Kamikawa-Enclosure/Kamikawa-Enclosure-Open-Models/Spec-Sheets/README.md

# Specification Sheets Library
PDF datasheets with full technical parameters of each aluminum enclosure model:
- Outer & inner dimensions
- Wall thickness
- IP65 waterproof & dustproof performance
- Material and surface treatment options
- Mounting and assembly instructions
