Kamikawa-Enclosure/Kamikawa-Enclosure-Open-Models/Product-Case-Studies-3D/README.md

# Product Case Studies 3D
## Overview
This folder collects real-world finished product 3D models of Kamikawa Precision aluminum enclosure solutions for industrial electronics. All samples are verified mass-production cases, covering extrusion aluminum profiles, IP-rated electronic shells, home energy storage pack boxes, and custom CNC precision housings.

## File Contents
- Native SolidWorks part & assembly source files
- Neutral exchange formats: STEP / STL for cross-platform CAD viewing
- Render preview images of finished aluminum enclosures
- Dimension-matched 3D models aligned with official spec sheets

## Usage Scenarios
- Mechanical engineers: Internal structural layout design, space interference check
- Procurement & sales teams: Visual 3D demo for client technical communication
- Hardware developers: Quick size reference for PCB board layout matching

## Version Control Note
All case models are sorted by application industry, updated synchronously with our latest public open mold library.
