Kamikawa-Enclosure/Kamikawa-Enclosure-Open-Models/Spec-Sheets/Aluminium Extrusion Enclosure Specifications v1.0.0.2.pdf

| | | Split-body | K268 | Split-body | K3
SC-ZT25.5x25.5 | SC-ZT32x23 | SC-ZT32x32 | SC-FT33.8X25 | | SC-FT33.8X33.8
Unibody+21:69A621:9221:85A6221:705 K365 | Unibody | K418 | Unibody | K2

# HUIZHOU KAMIKAWA PRECISION

TECHNOLOGY CO., LTD.

### Aluminium Extrusion Enclosure Available Models & Specifications VER: 1.0.0.2

Electronic enclosures are widely used across a vast range of applications—almost all electronic devices require robust, lightweight, and eco-friendly housing for effective protection.
Aluminum enclosures have gained strong popularity in the market. They are not only sturdy, lightweight, and environmentally friendly, but also offer excellent heat dissipation. In addition, aluminum enclosures provide outstanding electromagnetic interference (EMI) shielding performance (and can also be designed to be electrically conductive), ensuring safe and stable operation of your electronic equipment.
We offer over 400 different extruded aluminum enclosure profiles in various sizes and shapes (as shown in the table)—all available without any tooling/mold costs. Simply select the appropriate size based on your PCB dimensions, pair it with your choice of end caps, and you can easily create a perfect anodized aluminum electronic enclosure. You can also fully customize your enclosures: end-cap styles, mounting hole positions and shapes, surface color, logo marking, and packaging. Of course, our professional design team can also develop electronic enclosures with different ingress protection (IP) ratings to meet your specific requirements.
Custom ingress protection grades including IP65 and IP68 can be configured per equipment demands.

Cross-sectional dimensions and shape：20 & 50mm.

Split-body | K15 | Unibody | K318 | Split-body | K4 | Split-body | K5 | Unibody | K7
SC-FT34.6X25 | | SC-FT35X19 | | SC-FT35X25.8 | | SC-FT40.6X30 | | SC-ZT42X42
Split-body | SC-K269 | Split-body | SC-K6 | Unibody | SC-K324 | Unibody | SC-K9 | Unibody | SC-K266
SC-FT43.8X25 | | SC-FT43.8X43.8 | | SC-ZT43X14.1 | | SC-ZT44X23 | | SC-ZT45X18.5
Unibody | SC-K353 | Split-body | SC-K11 | Unibody | SC-K10 | Unibody | SC-K412 | Unibody | SC-K13
SC-ZT45X18.5 | | SC-FT46.2X29.6 | | SC-ZT46X18.8 | | SC-ZT48X25 | | SC-ZT50.5X21.1
Split-body | SC-K12 | Unibody | SC-K14 | Unibody | SC-K180 | Unibody | SC-K270 | Unibody | SC-K16
SC-FT50X20 | | SC-ZT50X21 | | SC-ZT50X30 | | SC-ZT50X35 | | SC-ZT50X40

# HUIZHOU KAMIKAWA PRECISION

TECHNOLOGY CO., LTD.

### Aluminium Extrusion Enclosure Available Models & Specifications VER: 1.0.0.2

Electronic enclosures are widely used across a vast range of applications—almost all electronic devices require robust, lightweight, and eco-friendly housing for effective protection.
Aluminum enclosures have gained strong popularity in the market. They are not only sturdy, lightweight, and environmentally friendly, but also offer excellent heat dissipation. In addition, aluminum enclosures provide outstanding electromagnetic interference (EMI) shielding performance (and can also be designed to be electrically conductive), ensuring safe and stable operation of your electronic equipment.
We offer over 400 different extruded aluminum enclosure profiles in various sizes and shapes (as shown in the table)—all available without any tooling/mold costs. Simply select the appropriate size based on your PCB dimensions, pair it with your choice of end caps, and you can easily create a perfect anodized aluminum electronic enclosure. You can also fully customize your enclosures: end-cap styles, mounting hole positions and shapes, surface color, logo marking, and packaging. Of course, our professional design team can also develop electronic enclosures with different ingress protection (IP) ratings to meet your specific requirements.
Custom ingress protection grades including IP65 and IP68 can be configured per equipment demands.
Unibody | SC-K359 | Unibody | SC-K341 | Unibody | SC-K18 | Split-body | SC-K272 | Split-body | SC-K20
SC-ZT52X19.6 | | SC-ZT52X26 | | SC-ZT52X52 | | SC-FT53.8X25 | | SC-FT54.2X54.2

Cross-sectional dimensions and shape：50 & 60mm.

Split-body | SC-K444 | Unibody | SC-K19 | Unibody | SC-K21 | Split-body | SC-K22 | Unibody | SC-K340
SC-FT54.5X27 | | SC-ZT54X23 | | SC-ZT55X19 | | SC-FT55X30 | | SC-ZT56X16
Unibody | SC-K24 | Unibody | SC-K327 | Unibody | SC-K342 | Unibody | SC-K26 | Unibody | SC-K448
SC-ZT56X56 | | SC-ZT57.8X34.2 | | SC-ZT57X24 | | SC-ZT57X28 | | SC-ZT58.6X20
Unibody | SC-K493 | Unibody | SC-K27 | Unibody | SC-K28 | Split-body | SC-K188 | Split-body | SC-K189
SC-ZT58.6X24.1 | | SC-ZT58X24 | | SC-ZT58.3X24.9 | | SC-FT60X25 | | SC-FT60X35
Split-body | SC-K190 | Unibody | SC-K181
SC-FT60X50 | | SC-ZT60X60

# HUIZHOU KAMIKAWA PRECISION

TECHNOLOGY CO., LTD.

### Aluminium Extrusion Enclosure Available Models & Specifications VER: 1.0.0.2

Electronic enclosures are widely used across a vast range of applications—almost all electronic devices require robust, lightweight, and eco-friendly housing for effective protection.
Aluminum enclosures have gained strong popularity in the market. They are not only sturdy, lightweight, and environmentally friendly, but also offer excellent heat dissipation. In addition, aluminum enclosures provide outstanding electromagnetic interference (EMI) shielding performance (and can also be designed to be electrically conductive), ensuring safe and stable operation of your electronic equipment.
We offer over 400 different extruded aluminum enclosure profiles in various sizes and shapes (as shown in the table)—all available without any tooling/mold costs. Simply select the appropriate size based on your PCB dimensions, pair it with your choice of end caps, and you can easily create a perfect anodized aluminum electronic enclosure. You can also fully customize your enclosures: end-cap styles, mounting hole positions and shapes, surface color, logo marking, and packaging. Of course, our professional design team can also develop electronic enclosures with different ingress protection (IP) ratings to meet your specific requirements.
Custom ingress protection grades including IP65 and IP68 can be configured per equipment demands.
Unibody with ears | SC-K157 | Unibody | SC-K36 | Split-body | SC-K155 | Unibody | SC-K259 | Unibody | SC-K256
SC-ZT66.6X29.5带耳 | | SC-ZT66X27 | | SC-FT66X30 | | SC-ZT66X32 | | SC-ZT66X43
Split-body | SC-K23 | Unibody | SC-K152 | Split-body | SC-K25 | Unibody | SC-K378 | Split-body | SC-K284
SC-FT61.6X40 | | SC-ZT61X22.4 | | SC-FT62.6X45 | | SC-FT62.9X38 | | SC-ZT63.8X30

Cross-sectional dimensions and shape：60 & 70mm.

Split-body | SC-K30 | Unibody | SC-K31 | Unibody | SC-K153 | Split-body | SC-K34 | Unibody | SC-K373
SC-FT63X25 | | SC-ZT63X37 | | SC-ZT64.2X23.5 | | SC-FT64.2X64.2 | | SC-ZT64.5X35
Split-body | SC-K33 | Unibody | SC-K154 | Split-body | SC-K41 | Split-body | SC-K35 | Unibody | SC-K156
SC-FT64X23 | | SC-ZT64X25.3 | | SC-FT65.6X35 | | SC-FT65X45 | | SC-ZT66.2X27.5
Unibody | SC-K338 | Unibody | SC-K366 | Unibody | SC-K366 | Unibody | SC-K40 | Unibody | SC-K396
SC-ZT66X55 | | SC-ZT67.1-24.9 | | SC-ZT67.1X24.9 | | SC-ZT67X53 | | SC-ZT68X42.5

# HUIZHOU KAMIKAWA PRECISION

TECHNOLOGY CO., LTD.

### Aluminium Extrusion Enclosure Available Models & Specifications VER: 1.0.0.2

Electronic enclosures are widely used across a vast range of applications—almost all electronic devices require robust, lightweight, and eco-friendly housing for effective protection.
Aluminum enclosures have gained strong popularity in the market. They are not only sturdy, lightweight, and environmentally friendly, but also offer excellent heat dissipation. In addition, aluminum enclosures provide outstanding electromagnetic interference (EMI) shielding performance (and can also be designed to be electrically conductive), ensuring safe and stable operation of your electronic equipment.
We offer over 400 different extruded aluminum enclosure profiles in various sizes and shapes (as shown in the table)—all available without any tooling/mold costs. Simply select the appropriate size based on your PCB dimensions, pair it with your choice of end caps, and you can easily create a perfect anodized aluminum electronic enclosure. You can also fully customize your enclosures: end-cap styles, mounting hole positions and shapes, surface color, logo marking, and packaging. Of course, our professional design team can also develop electronic enclosures with different ingress protection (IP) ratings to meet your specific requirements.
Custom ingress protection grades including IP65 and IP68 can be configured per equipment demands.
Unibody with ears | SC-K47 | Split-body | SC-K48 | Split-body | SC-K49 | Unibody | SC-K240 | Split-body | SC-K42
SC-ZT70.5X24.7带耳 | | SC-FT71X25 | | SC-FT71X27 | | SC-ZT73.2X65.2 | | SC-FT73.6X50
Split-body | SC-K55 | Split-body | SC-K158 | Unibody with ears | SC-K281 | Unibody | SC-K182 | Split-body | SC-K470
SC-FT75.8X46 | | SC-FT75X35 | | SC-ZT75X39.3带耳 | | SC-ZT75X40 | | SC-FT76X47.6
Unibody | SC-K257 | Split-body | SC-K43 | Unibody | SC-K310 | Split-body | SC-K44 | Split-body | SC-K45
SC-ZT69X24 | | SC-FT69X27 | | SC-ZT69X34.5 | | SC-FT69X35 | | SC-FT69X43

Cross-sectional dimensions and shape：70 & 80mm.

Unibody | SC-K331 | Split-body | SC-K286 | Split-body | SC-K363 | Split-body | SC-K368 | Split-body | SC-K369
SC-ZT73X59 | | SC-FT73.8X30 | | SC-FT74.6X25 | | SC-FT74.6X25 | | SC-FT74.6X25
Split-body | SC-K52 | Unibody | SC-K51 | Split-body | SC-K50 | Split-body | SC-K53 | Split-body | SC-K54
SC-FT74.6X74.6 | | SC-ZT74X29 | | SC-FT75.6X40 | | SC-FT75.6X45 | | SC-FT75.8X34.8

# HUIZHOU KAMIKAWA PRECISION

TECHNOLOGY CO., LTD.

### Aluminium Extrusion Enclosure Available Models & Specifications VER: 1.0.0.2

Electronic enclosures are widely used across a vast range of applications—almost all electronic devices require robust, lightweight, and eco-friendly housing for effective protection.
Aluminum enclosures have gained strong popularity in the market. They are not only sturdy, lightweight, and environmentally friendly, but also offer excellent heat dissipation. In addition, aluminum enclosures provide outstanding electromagnetic interference (EMI) shielding performance (and can also be designed to be electrically conductive), ensuring safe and stable operation of your electronic equipment.
We offer over 400 different extruded aluminum enclosure profiles in various sizes and shapes (as shown in the table)—all available without any tooling/mold costs. Simply select the appropriate size based on your PCB dimensions, pair it with your choice of end caps, and you can easily create a perfect anodized aluminum electronic enclosure. You can also fully customize your enclosures: end-cap styles, mounting hole positions and shapes, surface color, logo marking, and packaging. Of course, our professional design team can also develop electronic enclosures with different ingress protection (IP) ratings to meet your specific requirements.
Custom ingress protection grades including IP65 and IP68 can be configured per equipment demands.
Split-body | SC-K273 | Unibody with ears | SC-K57 | Split type with ears | SC-K169 | Unibody | SC-K311 | Unibody | SC-K435
SC-FT77.4X46 | | SC-ZT78X24带耳 | | SC-FT78X26带耳 | | SC-ZT79X23.5 | | SC-ZT79X30
Split-body | SC-K361 | Unibody | SC-K397 | Unibody with ears | SC-K58 | Split-body | SC-K191 | Split-body | SC-K210
SC-FT80X22.5 | | SC-ZT80X22 | | SC-ZT80X23带耳 | | SC-FT80X30 | | SC-FT80X30
Unibody with ears | SC-K297 | Split-body | SC-K59 | Unibody | SC-K463 | Split-body | SC-K60 | Split-body | SC-K300
SC-ZT80.5X25.5带耳 | | 81.6X40 | | SC-ZT82X44 | | SC-FT83.6X50 | | SC-FT83.8X30
Unibody | SC-K159 | Unibody | SC-K170 | Unibody | SC-K303 | Split-body | SC-K61 | Split-body | SC-K192
SC-ZT80X35 | | SC-ZT80X35 | | SC-ZT80X37.6 | | SC-FT80X40 | | SC-FT80X40
Split-body | SC-K211 | Unibody | SC-K63 | Split-body | SC-K193 | Split-body | SC-K212 | Unibody | SC-K183
SC-FT80X40 | | SC-ZT80X45 | | SC-FT80X55 | | SC-FT80X55 | | SC-ZT80X80

Cross-sectional dimensions and shape：80 & 90mm.

# HUIZHOU KAMIKAWA PRECISION

TECHNOLOGY CO., LTD.

### Aluminium Extrusion Enclosure Available Models & Specifications VER: 1.0.0.2

Electronic enclosures are widely used across a vast range of applications—almost all electronic devices require robust, lightweight, and eco-friendly housing for effective protection.
Aluminum enclosures have gained strong popularity in the market. They are not only sturdy, lightweight, and environmentally friendly, but also offer excellent heat dissipation. In addition, aluminum enclosures provide outstanding electromagnetic interference (EMI) shielding performance (and can also be designed to be electrically conductive), ensuring safe and stable operation of your electronic equipment.
We offer over 400 different extruded aluminum enclosure profiles in various sizes and shapes (as shown in the table)—all available without any tooling/mold costs. Simply select the appropriate size based on your PCB dimensions, pair it with your choice of end caps, and you can easily create a perfect anodized aluminum electronic enclosure. You can also fully customize your enclosures: end-cap styles, mounting hole positions and shapes, surface color, logo marking, and packaging. Of course, our professional design team can also develop electronic enclosures with different ingress protection (IP) ratings to meet your specific requirements.
Custom ingress protection grades including IP65 and IP68 can be configured per equipment demands.
Split-body | SC-K68 | Unibody | SC-K67 | Unibody | SC-K504 | Unibody with ears | SC-K426 | Unibody | SC-K385
SC-FT84.6X84.6 | | SC-ZT84X28 | | SC-ZT84X28 | | SC-ZT85.8X26.5带耳 | | SC-ZT85X46
Split-body | SC-K279 | Split-body | SC-K69 | Unibody | SC-K172 | Split-body | SC-K70 | Unibody with ears | SC-K281
SC-FT86X46 | | SC-FT88X30 | | SC-ZT88X38.9 | | SC-FT88X38 | | SC-ZT88X39.6带耳
Unibody | SC-K420 | Split-body | SC-K301 | Split type with ears | SC-K71 | Unibody | SC-K160 | Split-body | SC-K73
SC-ZT88X43 | | SC-FT89.6X35 | | SC-FT89X27带耳 | | SC-ZT90X34.9 | | SC-FT90X35
Split-body | SC-K74 | Unibody with ears | SC-K75 | Split-body | SC-K77 | Split-body | SC-K78 | Split-body | SC-K79
SC-FT90X36 | | SC-ZT90X40带耳 | | SC-FT90X59 | | SC-FT90X74.5 | | SC-FT90X90
Split-body | SC-K308 | Unibody | SC-K65 | Split-body | SC-K371 | Split-body | SC-K375 | Split-body | SC-K377
SC-FT83.9X55 | | SC-ZT83X29 | | SC-FT84.6X30 | | SC-FT84.6X30 | | SC-FT84.6X30

# HUIZHOU KAMIKAWA PRECISION

TECHNOLOGY CO., LTD.

### Aluminium Extrusion Enclosure Available Models & Specifications VER: 1.0.0.2

Electronic enclosures are widely used across a vast range of applications—almost all electronic devices require robust, lightweight, and eco-friendly housing for effective protection.
Aluminum enclosures have gained strong popularity in the market. They are not only sturdy, lightweight, and environmentally friendly, but also offer excellent heat dissipation. In addition, aluminum enclosures provide outstanding electromagnetic interference (EMI) shielding performance (and can also be designed to be electrically conductive), ensuring safe and stable operation of your electronic equipment.
We offer over 400 different extruded aluminum enclosure profiles in various sizes and shapes (as shown in the table)—all available without any tooling/mold costs. Simply select the appropriate size based on your PCB dimensions, pair it with your choice of end caps, and you can easily create a perfect anodized aluminum electronic enclosure. You can also fully customize your enclosures: end-cap styles, mounting hole positions and shapes, surface color, logo marking, and packaging. Of course, our professional design team can also develop electronic enclosures with different ingress protection (IP) ratings to meet your specific requirements.
Custom ingress protection grades including IP65 and IP68 can be configured per equipment demands.
Unibody | SC-K374 | Split type with ears | SC-K80 | Split type with ears | SC-K81 | Unibody | SC-K499 | Split-body | SC-K82
SC-ZT92X30 | | SC-FT92X35带耳 | | SC-FT92X46带耳 | | SC-ZT92X46 | | SC-FT92X73
Split-body | SC-K133 | Split-body | SC-K90 | Split-body | SC-K86 | Unibody with ears | SC-K161 | Split-body | SC-K87
SC-FT97.6X39 | | SC-FT97.8X48.4 | | SC-FT97X39.8 | | SC-ZT97X40.6带耳 | | SC-FT97X50
Split-body | SC-K64 | Split-body | SC-K468 | Unibody | SC-K477 | Split-body | SC-K76 | Unibody | SC-K124
SC-FT91.6X50 | | SC-FT91X57.6 | | SC-ZT91X91 | | SC-FT92.6X30 | | SC-ZT92.6X31

Cross-sectional dimensions and shape：90 & 100mm.

Split-body | SC-K379 | Split-body | SC-K381 | Split-body | SC-K382 | Split-body | SC-K315 | Unibody | SC-K83
SC-FT94.6X30 | | SC-FT94.6X30 | | SC-FT94.6X30 | | SC-FT94.6X35 | | SC-ZT95.4X45.2
Unibody | SC-K399 | Split-body | SC-K84 | Split-body | SC-K498 | Split-body | SC-K85 | Split-body | SC-K66
SC-ZT95X30 | | SC-FT95X54.3 | | SC-FT96.6X36.5 | | SC-FT96X45.5 | | SC-FT97.6X30

# HUIZHOU KAMIKAWA PRECISION

TECHNOLOGY CO., LTD.

### Aluminium Extrusion Enclosure Available Models & Specifications VER: 1.0.0.2

Electronic enclosures are widely used across a vast range of applications—almost all electronic devices require robust, lightweight, and eco-friendly housing for effective protection.
Aluminum enclosures have gained strong popularity in the market. They are not only sturdy, lightweight, and environmentally friendly, but also offer excellent heat dissipation. In addition, aluminum enclosures provide outstanding electromagnetic interference (EMI) shielding performance (and can also be designed to be electrically conductive), ensuring safe and stable operation of your electronic equipment.
We offer over 400 different extruded aluminum enclosure profiles in various sizes and shapes (as shown in the table)—all available without any tooling/mold costs. Simply select the appropriate size based on your PCB dimensions, pair it with your choice of end caps, and you can easily create a perfect anodized aluminum electronic enclosure. You can also fully customize your enclosures: end-cap styles, mounting hole positions and shapes, surface color, logo marking, and packaging. Of course, our professional design team can also develop electronic enclosures with different ingress protection (IP) ratings to meet your specific requirements.
Custom ingress protection grades including IP65 and IP68 can be configured per equipment demands.
Unibody | SC-K329 | Split-body | SC-K436 | Unibody with ears | SC-K92 | Split-body | SC-K319 | Split-body | SC-K93
SC-ZT101.2X23.5 | | SC-FT101.5X24 | | SC-ZT104.4X28.3带耳 | | SC-FT104.6X35 | | SC-FT104X35.6
Split-body | SC-K88 | Unibody | SC-K89 | Split-body | SC-K276 | Split-body | SC-K317 | Split-body | SC-K320
SC-FT97X60 | | SC-ZT97X84 | | SC-FT98X25 | | SC-FT99.6X35 | | SC-FT99.6X43.8
Split-body | SC-K387 | Split-body | SC-K393 | Split-body | SC-K398 | Split-body | SC-K91 | Unibody | SC-K424
SC-FT99.6X35 | | SC-FT99.6X35 | | SC-FT99.6X35 | | SC-FT100X25.5 | | SC-ZT100X27
Unibody | SC-K184 | Unibody | SC-K323
SC-ZT100X50 | | SC-ZT100X54.5

Cross-sectional dimensions and shape：100 & 110mm.

Split-body | SC-K94 | Split-body | SC-K328 | Split-body | SC-K95 | Split-body | SC-K96 | Split-body | SC-K336
SC-FT104X45.6 | | SC-FT104X46.9 | | SC-FT104X55.6 | | SC-FT104X63 | | SC-FT104X63

# HUIZHOU KAMIKAWA PRECISION

TECHNOLOGY CO., LTD.

### Aluminium Extrusion Enclosure Available Models & Specifications VER: 1.0.0.2

Electronic enclosures are widely used across a vast range of applications—almost all electronic devices require robust, lightweight, and eco-friendly housing for effective protection.
Aluminum enclosures have gained strong popularity in the market. They are not only sturdy, lightweight, and environmentally friendly, but also offer excellent heat dissipation. In addition, aluminum enclosures provide outstanding electromagnetic interference (EMI) shielding performance (and can also be designed to be electrically conductive), ensuring safe and stable operation of your electronic equipment.
We offer over 400 different extruded aluminum enclosure profiles in various sizes and shapes (as shown in the table)—all available without any tooling/mold costs. Simply select the appropriate size based on your PCB dimensions, pair it with your choice of end caps, and you can easily create a perfect anodized aluminum electronic enclosure. You can also fully customize your enclosures: end-cap styles, mounting hole positions and shapes, surface color, logo marking, and packaging. Of course, our professional design team can also develop electronic enclosures with different ingress protection (IP) ratings to meet your specific requirements.
Custom ingress protection grades including IP65 and IP68 can be configured per equipment demands.
Split-body | SC-K97 | Split-body | SC-K337 | Split-body | SC-K98 | Split-body | SC-K335 | Unibody | SC-K367
SC-FT104X73 | | SC-FT104X76.95 | | SC-FT104X89.6 | | SC-FT104X107 | | SC-ZT105.5X52.9
Unibody | SC-K99 | Split-body | SC-K194 | Split-body | SC-K213 | Split-body | SC-K162 | Split-body | SC-K195
SC-ZT105X22 | | SC-FT105X30 | | SC-FT105X30 | | SC-FT105X45 | | SC-FT105X45
Split-body | SC-K196 | Unibody | SC-K434 | Split-body | SC-K100 | Split-body | SC-K101 | Split-body | SC-K102
SC-FT105X60 | | SC-ZT106X36.3 | | SC-FT106X40 | | SC-FT106X54 | | SC-FT106X55
Split-body | SC-K263 | Split-body | SC-K148 | Unibody | SC-K395 | Unibody | SC-K296 | Split-body | SC-K103
SC-FT106X55 | | SC-FT107.6X55 | | SC-ZT107X27 | | SC-ZT107X36.6 | | SC-FT107X47
Unibody | SC-K171 | Split-body | SC-K321 | Split-body | SC-K402 | Split-body | SC-K404 | Split-body | SC-K406
SC-ZT108X108 | | SC-FT109.6X35 | | SC-FT109.6X35 | | SC-FT109.6X35 | | SC-FT109.6X35

# HUIZHOU KAMIKAWA PRECISION

TECHNOLOGY CO., LTD.

### Aluminium Extrusion Enclosure Available Models & Specifications VER: 1.0.0.2

Electronic enclosures are widely used across a vast range of applications—almost all electronic devices require robust, lightweight, and eco-friendly housing for effective protection.
Aluminum enclosures have gained strong popularity in the market. They are not only sturdy, lightweight, and environmentally friendly, but also offer excellent heat dissipation. In addition, aluminum enclosures provide outstanding electromagnetic interference (EMI) shielding performance (and can also be designed to be electrically conductive), ensuring safe and stable operation of your electronic equipment.
We offer over 400 different extruded aluminum enclosure profiles in various sizes and shapes (as shown in the table)—all available without any tooling/mold costs. Simply select the appropriate size based on your PCB dimensions, pair it with your choice of end caps, and you can easily create a perfect anodized aluminum electronic enclosure. You can also fully customize your enclosures: end-cap styles, mounting hole positions and shapes, surface color, logo marking, and packaging. Of course, our professional design team can also develop electronic enclosures with different ingress protection (IP) ratings to meet your specific requirements.
Custom ingress protection grades including IP65 and IP68 can be configured per equipment demands.
Unibody | SC-K425 | Unibody with ears | SC-K427 | Split-body | SC-K492 | Split-body | SC-K106 | Unibody | SC-K175
SC-ZT110X24 | | SC-ZT110X26.1带耳 | | SC-FT110X46.9 | | SC-FT110X50 | | SC-ZT110X58
Unibody with ears | SC-K285

SC-ZT129.6X31.5带耳

Split-body | SC-K234 | Unibody | SC-K423 | Split type with ears | SC-K108 | Split type with ears | SC-K109 | Split-body | SC-K110
SC-FT111.2X88 | | SC-ZT112X25 | | SC-FT113X40带耳 | | SC-FT113X49.8带耳 | | SC-FT114X33
Split-body | SC-K409 | Split-body | SC-K414 | Split-body | SC-K422 | Unibody | SC-K185 | Unibody with ears | SC-K112
SC-FT114.6X38 | | SC-FT114.6X38 | | SC-FT114.6X38 | | SC-ZT114X65 | | SC-ZT116X53带耳
Split-body | SC-K229 | Split-body | SC-K230 | Split-body | SC-K231 | Split-body | SC-K232 | Split-body | SC-K233
SC-FT111.2X21.4 | | SC-FT111.2X32.5 | | SC-FT111.2X43.6 | | SC-FT111.2X54.7 | | SC-FT111.2X65.8

Cross-sectional dimensions and shape：110 & 120mm.

# HUIZHOU KAMIKAWA PRECISION

TECHNOLOGY CO., LTD.

### Aluminium Extrusion Enclosure Available Models & Specifications VER: 1.0.0.2

Electronic enclosures are widely used across a vast range of applications—almost all electronic devices require robust, lightweight, and eco-friendly housing for effective protection.
Aluminum enclosures have gained strong popularity in the market. They are not only sturdy, lightweight, and environmentally friendly, but also offer excellent heat dissipation. In addition, aluminum enclosures provide outstanding electromagnetic interference (EMI) shielding performance (and can also be designed to be electrically conductive), ensuring safe and stable operation of your electronic equipment.
We offer over 400 different extruded aluminum enclosure profiles in various sizes and shapes (as shown in the table)—all available without any tooling/mold costs. Simply select the appropriate size based on your PCB dimensions, pair it with your choice of end caps, and you can easily create a perfect anodized aluminum electronic enclosure. You can also fully customize your enclosures: end-cap styles, mounting hole positions and shapes, surface color, logo marking, and packaging. Of course, our professional design team can also develop electronic enclosures with different ingress protection (IP) ratings to meet your specific requirements.
Custom ingress protection grades including IP65 and IP68 can be configured per equipment demands.
Split type with ears | SC-K115 | Split-body | SC-K114 | Split-body | SC-K116 | Unibody | SC-K350 | Split-body | SC-K117
SC-FT119.6X34.2带耳 | | SC-FT120X35 | | SC-FT120X40 | | SC-ZT120X45 | | SC-FT120X49
Split type with ears | SC-K118 | Split-body | SC-K119 | Split type with ears | SC-K120 | Split-body | SC-K121 | Split-body | SC-K122
SC-FT120X50.1带耳 | | SC-FT120X63 | | SC-FT120X64.9带耳 | | SC-FT120X69 | | SC-FT120X83
Split-body | SC-K113 | Unibody with ears | SC-K287
SC-FT120X103 | | SC-ZT149X38带耳
Split-body | SC-K267 | Unibody | SC-K123 | Split-body | SC-K235 | Unibody | SC-K278 | Unibody | SC-K275
SC-FT122.4X28 | | SC-ZT122X28 | | SC-FT122X44.8 | | SC-ZT122X87 | | SC-ZT123X40

Cross-sectional dimensions and shape：120 & 140mm.

Split-body | SC-K343 | Split-body | SC-K428 | Split-body | SC-K430 | Split-body | SC-K437 | Split-body | SC-K125
SC-FT124.6X35 | | SC-FT124.6X45 | | SC-FT124.6X45 | | SC-FT124.6X45 | | SC-FT125X51

# HUIZHOU KAMIKAWA PRECISION

TECHNOLOGY CO., LTD.

### Aluminium Extrusion Enclosure Available Models & Specifications VER: 1.0.0.2

Electronic enclosures are widely used across a vast range of applications—almost all electronic devices require robust, lightweight, and eco-friendly housing for effective protection.
Aluminum enclosures have gained strong popularity in the market. They are not only sturdy, lightweight, and environmentally friendly, but also offer excellent heat dissipation. In addition, aluminum enclosures provide outstanding electromagnetic interference (EMI) shielding performance (and can also be designed to be electrically conductive), ensuring safe and stable operation of your electronic equipment.
We offer over 400 different extruded aluminum enclosure profiles in various sizes and shapes (as shown in the table)—all available without any tooling/mold costs. Simply select the appropriate size based on your PCB dimensions, pair it with your choice of end caps, and you can easily create a perfect anodized aluminum electronic enclosure. You can also fully customize your enclosures: end-cap styles, mounting hole positions and shapes, surface color, logo marking, and packaging. Of course, our professional design team can also develop electronic enclosures with different ingress protection (IP) ratings to meet your specific requirements.
Custom ingress protection grades including IP65 and IP68 can be configured per equipment demands.
Split-body | SC-K126 | Unibody | SC-K429 | Unibody with ears | SC-K127 | Unibody with ears | SC-K165 | Split-body | SC-K128
SC-FT127X75 | | SC-ZT128.5X41 | | SC-ZT129.7X31带耳 | | SC-ZT130X31.7带耳 | | SC-FT130X55
Split-body | SC-K451 | Split-body | SC-K443 | Split-body | SC-K452 | Unibody with ears | SC-K438 | Unibody | SC-K462
SC-FT130X55 | | SC-FT130X55 | | SC-FT130X55 | | SC-ZT131X27.5带耳 | | SC-ZT133.6X97.5
Unibody with ears | SC-K288 | Split-body | SC-K439 | Split-body | SC-K440 | Split-body | SC-K441 | Split type with ears | SC-K129
SC-ZT133X46.8带耳 | | SC-FT134.6X45 | | SC-FT134.6X45 | | SC-FT134.6X45 | | SC-FT134X35.6带耳
Split type with ears | SC-K130 | Split type with ears | SC-K131 | Split-body | SC-K304 | Unibody | SC-K132 | Unibody with ears | SC-K417
SC-FT134X45.6带耳 | | SC-FT134X62.6带耳 | | SC-FT136X64 | | SC-ZT136X136 | | SC-ZT137.5X50带耳
Unibody | SC-K494 | Unibody | SC-K309 | Split-body | SC-K197 | Split-body | SC-K216 | Split-body | SC-K163
SC-ZT137.8X34.1 | | SC-ZT137X72 | | SC-FT140X35 | | SC-FT140X35 | | SC-FT140X50

# HUIZHOU KAMIKAWA PRECISION

TECHNOLOGY CO., LTD.

### Aluminium Extrusion Enclosure Available Models & Specifications VER: 1.0.0.2

Electronic enclosures are widely used across a vast range of applications—almost all electronic devices require robust, lightweight, and eco-friendly housing for effective protection.
Aluminum enclosures have gained strong popularity in the market. They are not only sturdy, lightweight, and environmentally friendly, but also offer excellent heat dissipation. In addition, aluminum enclosures provide outstanding electromagnetic interference (EMI) shielding performance (and can also be designed to be electrically conductive), ensuring safe and stable operation of your electronic equipment.
We offer over 400 different extruded aluminum enclosure profiles in various sizes and shapes (as shown in the table)—all available without any tooling/mold costs. Simply select the appropriate size based on your PCB dimensions, pair it with your choice of end caps, and you can easily create a perfect anodized aluminum electronic enclosure. You can also fully customize your enclosures: end-cap styles, mounting hole positions and shapes, surface color, logo marking, and packaging. Of course, our professional design team can also develop electronic enclosures with different ingress protection (IP) ratings to meet your specific requirements.
Custom ingress protection grades including IP65 and IP68 can be configured per equipment demands.
Unibody with ears | SC-K294 | Split-body | SC-K236 | Split-body | SC-K458 | Split-body | SC-K455 | Split-body | SC-K459
SC-ZT142.8X31带耳 | | SC-FT142x53.4 | | SC-FT145.6X65 | | SC-FT145.6X65 | | SC-FT145.6X65
Split-body | SC-K357 | Split-body | SC-K134 | Split-body | SC-K135 | Split-body | SC-K136 | Split type with ears | SC-K283
SC-FT145.6X40 | | SC-FT145X54 | | SC-FT145X68 | | SC-FT145X82 | | SC-FT147X35.7带耳
Split type with ears | SC-K137 | Split type with ears | SC-K138 | Split type with ears | SC-K139 | Split type with ears | SC-K265 | Unibody | SC-K302
SC-FT147X41带耳 | | SC-FT147X55带耳 | | SC-FT147X61带耳 | | SC-FT149X50.5带耳 | | SC-ZT149X106.2
Split-body | SC-K496 | Unibody with ears | SC-K445 | Split type with ears | SC-K140 | Split-body | SC-K164 | Split type with ears | SC-K142
SC-FT150.6X151 | | SC-ZT150X37.9带耳 | | SC-FT150X39带耳 | | SC-FT150X55 | | SC-FT150X72带耳

Cross-sectional dimensions and shape：140 & 160mm.

Split-body | SC-K198 | Split-body | SC-K199 | Split-body | SC-K200
SC-FT140X50 | | SC-FT140X70 | | SC-FT140X90

# HUIZHOU KAMIKAWA PRECISION

TECHNOLOGY CO., LTD.

### Aluminium Extrusion Enclosure Available Models & Specifications VER: 1.0.0.2

Electronic enclosures are widely used across a vast range of applications—almost all electronic devices require robust, lightweight, and eco-friendly housing for effective protection.
Aluminum enclosures have gained strong popularity in the market. They are not only sturdy, lightweight, and environmentally friendly, but also offer excellent heat dissipation. In addition, aluminum enclosures provide outstanding electromagnetic interference (EMI) shielding performance (and can also be designed to be electrically conductive), ensuring safe and stable operation of your electronic equipment.
We offer over 400 different extruded aluminum enclosure profiles in various sizes and shapes (as shown in the table)—all available without any tooling/mold costs. Simply select the appropriate size based on your PCB dimensions, pair it with your choice of end caps, and you can easily create a perfect anodized aluminum electronic enclosure. You can also fully customize your enclosures: end-cap styles, mounting hole positions and shapes, surface color, logo marking, and packaging. Of course, our professional design team can also develop electronic enclosures with different ingress protection (IP) ratings to meet your specific requirements.
Custom ingress protection grades including IP65 and IP68 can be configured per equipment demands.
Unibody | SC-K186 | Split-body | SC-K173 | Split-body | SC-K487 | Split-body | SC-K143 | Split type with ears | SC-K380
SC-ZT150X75 | | SC-FT150X90 | | SC-FT152X30 | | SC-FT152X44 | | SC-FT153.4X42带耳
Split-body | SC-K358 | Split-body | SC-K460 | Split-body | SC-K461 | Split-body | SC-K465 | Unibody with ears | SC-K144
SC-FT155.6X50 | | SC-FT155.6X90 | | SC-FT155.6X90 | | SC-FT155.6X90 | | SC-ZT155X32带耳
Unibody with ears | SC-K306 | Unibody with ears | SC-K292 | Split-body | SC-K364 | Split-body | SC-K166 | Unibody | SC-K476
SC-ZT158X35带耳 | | SC-ZT158X39带耳 | | SC-FT159X40 | | SC-FT160X55 | | SC-ZT160X68.1
Split-body | SC-K475 | Split-body | SC-K483 | Split-body | SC-K484 | Split-body | SC-K258 | Split type with ears | SC-K389
SC-FT165.6X90 | | SC-FT165.6X90 | | SC-FT165.6X90 | | SC-FT167.6X47 | | SC-FT168X40.6带耳
Split-body | SC-K146

SC-FT160X80

Cross-sectional dimensions and shape：160 & 200mm.

# HUIZHOU KAMIKAWA PRECISION

TECHNOLOGY CO., LTD.

### Aluminium Extrusion Enclosure Available Models & Specifications VER: 1.0.0.2

Electronic enclosures are widely used across a vast range of applications—almost all electronic devices require robust, lightweight, and eco-friendly housing for effective protection.
Aluminum enclosures have gained strong popularity in the market. They are not only sturdy, lightweight, and environmentally friendly, but also offer excellent heat dissipation. In addition, aluminum enclosures provide outstanding electromagnetic interference (EMI) shielding performance (and can also be designed to be electrically conductive), ensuring safe and stable operation of your electronic equipment.
We offer over 400 different extruded aluminum enclosure profiles in various sizes and shapes (as shown in the table)—all available without any tooling/mold costs. Simply select the appropriate size based on your PCB dimensions, pair it with your choice of end caps, and you can easily create a perfect anodized aluminum electronic enclosure. You can also fully customize your enclosures: end-cap styles, mounting hole positions and shapes, surface color, logo marking, and packaging. Of course, our professional design team can also develop electronic enclosures with different ingress protection (IP) ratings to meet your specific requirements.
Custom ingress protection grades including IP65 and IP68 can be configured per equipment demands.
Split type with ears | SC-K386 | Split-body | SC-K277 | Split-body | SC-K147 | Split-body | SC-K486 | Split-body | SC-K497
SC-FT168X40带耳 | | SC-FT168X45 | | SC-FT168X54 | | SC-FT175.6X65 | | SC-FT175.6X65
Split-body | SC-K204 | Split type with ears | SC-K352 | Split type with ears | SC-K149 | Unibody with ears | SC-K450 | Split-body | SC-K495
SC-FT185X105 | | SC-FT190X45.9带耳 | | SC-FT190X71.6带耳 | | SC-ZT194X23.5带耳 | | SC-FT197.6X197.6
Unibody | SC-K500 | Split-body | SC-K261 | Split-body | SC-K392 | Split-body | SC-K167 | Split-body | SC-K201
SC-ZT175.6X65 | | SC-FT177.6X39 | | SC-FT179.8X50 | | SC-FT180X45 | | SC-FT185X42
Split-body | SC-K479 | Split-body | SC-K480 | Split-body | SC-K481 | Split-body | SC-K202 | Split-body | SC-K203
SC-FT185.6X65 | | SC-FT185.6X65 | | SC-FT185.6X65 | | SC-FT185X60 | | SC-FT185X80
Split-body | SC-K168 | Unibody | SC-K187
SC-FT200X55 | | SC-ZT200X75

# HUIZHOU KAMIKAWA PRECISION

TECHNOLOGY CO., LTD.

### Aluminium Extrusion Enclosure Available Models & Specifications VER: 1.0.0.2

Electronic enclosures are widely used across a vast range of applications—almost all electronic devices require robust, lightweight, and eco-friendly housing for effective protection.
Aluminum enclosures have gained strong popularity in the market. They are not only sturdy, lightweight, and environmentally friendly, but also offer excellent heat dissipation. In addition, aluminum enclosures provide outstanding electromagnetic interference (EMI) shielding performance (and can also be designed to be electrically conductive), ensuring safe and stable operation of your electronic equipment.
We offer over 400 different extruded aluminum enclosure profiles in various sizes and shapes (as shown in the table)—all available without any tooling/mold costs. Simply select the appropriate size based on your PCB dimensions, pair it with your choice of end caps, and you can easily create a perfect anodized aluminum electronic enclosure. You can also fully customize your enclosures: end-cap styles, mounting hole positions and shapes, surface color, logo marking, and packaging. Of course, our professional design team can also develop electronic enclosures with different ingress protection (IP) ratings to meet your specific requirements.
Custom ingress protection grades including IP65 and IP68 can be configured per equipment demands.
Split-body | SC-K384 | Split-body | SC-K237 | Split type with ears | SC-K150 | Split-body | SC-K488 | Split-body | SC-K489
SC-FT202X32 | | SC-FT202X52 | | SC-FT204X48带耳 | | SC-FT205.6X65 | | SC-FT205.6X65

Cross-sectional dimensions and shape：200 & 300mm.

Split-body | SC-K490 | Split-body | SC-K503 | Unibody | SC-K298 | Split-body | SC-K205 | Split-body | SC-K206
SC-FT205.6X65 | | SC-FT210X54 | | SC-ZT220X48.4 | | SC-FT230X50 | | SC-FT230X75
Split-body | SC-K207 | Split-body | SC-K501 | Split-body | SC-K502 | Split-body | SC-K208 | Split-body | SC-K209
SC-FT230X100 | | SC-FT240X85 | | SC-FT250X54 | | SC-FT285X75 | | SC-FT285X125
Split-body | SC-K242 | Split-body | SC-K243 | Unibody | SC-K29 | Unibody | SC-K407 | Split-body | SC-K252
SC-FT40.6X14.6 | | SC-FT56.5X17.5 | | SC-ZT60X21 | | SC-ZT67.5X24 | | SC-FT69.1X35

The following is the special-shaped aluminum shell.

Split-body | SC-K244 | Split-body | SC-K248 | Unibody | SC-K46 | Split-body | SC-K307 | Split-body | SC-K245
SC-FT69.5X19.5 | | SC-FT69.5X34.5 | | SC-ZT70X24 | | SC-FT79X26 | | SC-FT81.5X23.5

# HUIZHOU KAMIKAWA PRECISION

TECHNOLOGY CO., LTD.

### Aluminium Extrusion Enclosure Available Models & Specifications VER: 1.0.0.2

Electronic enclosures are widely used across a vast range of applications—almost all electronic devices require robust, lightweight, and eco-friendly housing for effective protection.
Aluminum enclosures have gained strong popularity in the market. They are not only sturdy, lightweight, and environmentally friendly, but also offer excellent heat dissipation. In addition, aluminum enclosures provide outstanding electromagnetic interference (EMI) shielding performance (and can also be designed to be electrically conductive), ensuring safe and stable operation of your electronic equipment.
We offer over 400 different extruded aluminum enclosure profiles in various sizes and shapes (as shown in the table)—all available without any tooling/mold costs. Simply select the appropriate size based on your PCB dimensions, pair it with your choice of end caps, and you can easily create a perfect anodized aluminum electronic enclosure. You can also fully customize your enclosures: end-cap styles, mounting hole positions and shapes, surface color, logo marking, and packaging. Of course, our professional design team can also develop electronic enclosures with different ingress protection (IP) ratings to meet your specific requirements.
Custom ingress protection grades including IP65 and IP68 can be configured per equipment demands.
Unibody | SC-K241 | Unibody | SC-K348 | Split-body | SC-K249 | Split-body | SC-K253 | Split-body | SC-K246
SC-ZT84X17.5 | | SC-ZT84X17.5 | | SC-FT94.5X39.5 | | SC-FT99.4X25.8 | | SC-FT99.6X15.6
Split-body | SC-K254 | Unibody | SC-K104 | Split-body | SC-K247 | Unibody | SC-K105 | Unibody | SC-K111
SC-FT108.2X29.5 | | SC-ZT108X26 | | SC-FT109.5X29.5 | | SC-ZT110X28 | | SC-ZT115X24
Unibody | SC-K401 | Split-body | SC-K250 | Unibody | SC-K305 | SC-FTxx X xx
SC-ZT128.4X34.3 | | SC-FT129.5X34.5 | | SC-ZT165X40 | | Any length, width, height dimensions
