Kamikawa-Enclosure/Kamikawa-Enclosure-Open-Models/3D-Models/SCZT245x180-SC.STEP

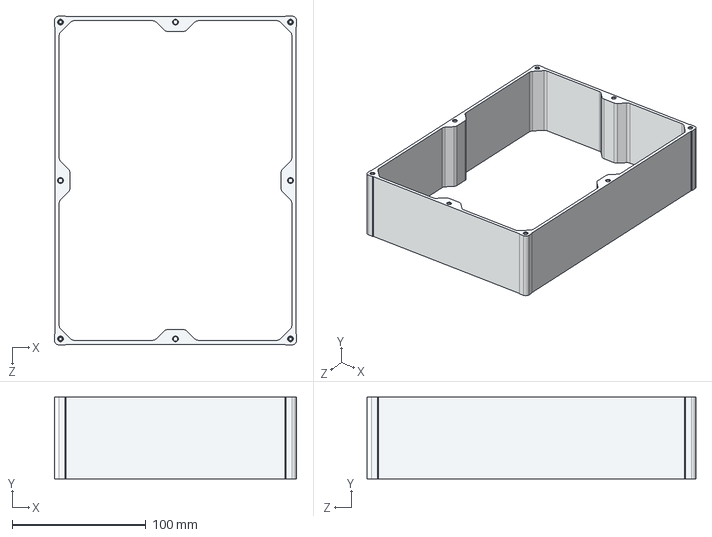
[picture p1: CAD file, 2026-11-07]
3D-Models/SCZT245x180-SC.STEP
181.0 x 61.0 x 246.0 mm
