Kamikawa-Enclosure/Kamikawa-Enclosure-Open-Models/CAD-Drawings/SCZT245x180-SC.DXF

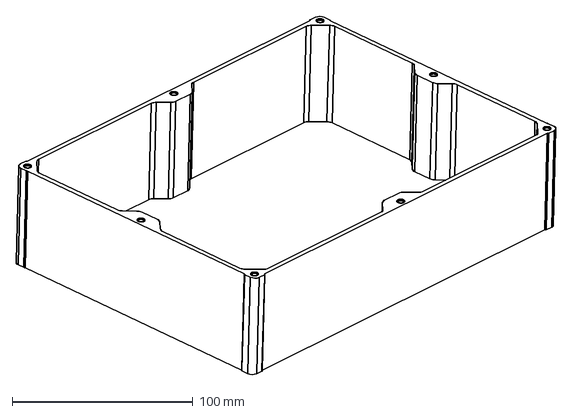
[picture p2: CAD file, 2026-11-07]
CAD-Drawings/SCZT245x180-SC.DXF
298.7 x 198.6 mm
