Kamikawa-Enclosure/Kamikawa-Enclosure-Open-Models/Product-Case-Studies-3D/SC-FT-K61-K73-K116-K158-22.STEP

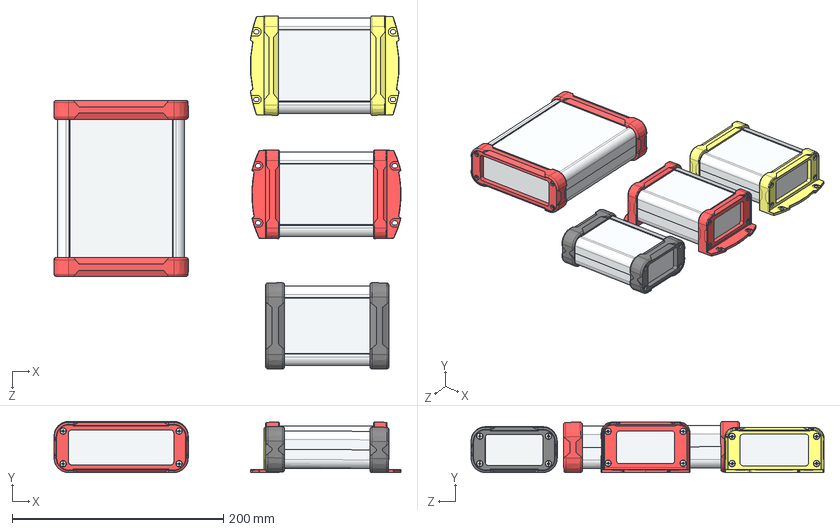
[picture p3: CAD file, 2026-10-18]
Product-Case-Studies-3D/SC-FT-K61-K73-K116-K158-22.STEP
328.1 x 48.4 x 333.9 mm
SC-FT80x40-10_A
SC-FT80x40-10_B
SC-FT80x40-20_A
SC-FT80x40-20_B
cross recessed pan head screws gb_GB M3X8-8 x 32
SC-FT80x40-30_深蓝色 x 2
SC-FT90x35-10_A
SC-FT90x35-10_B
SC-FT90x35-20_A
SC-FT90x35-20_B
SC-FT90x35-30_深蓝色 x 2
SC-FT120x40-10_A
SC-FT120x40-10_B
SC-FT120x40-20_A
SC-FT120x40-20_B
SC-FT120x40-30_黑色 x 2
SC-FT75x35-10_A
SC-FT75x35-10_B
SC-FT75x35-20_A
SC-FT75x35-20_B
SC-FT75x35-30_黑色 x 2
