Kamikawa-Enclosure/Kamikawa-Enclosure-Open-Models/3D-Models/SC-ZT150x120-SC.STEP

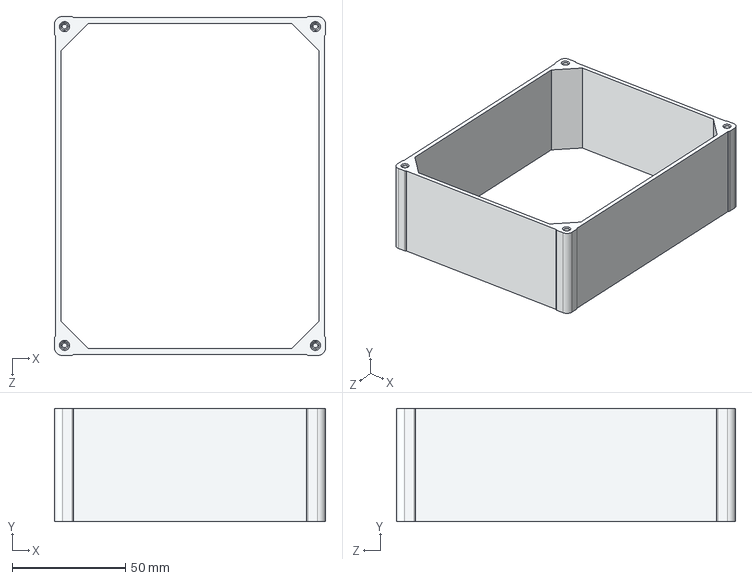
[picture p4: CAD file, 2026-11-07]
3D-Models/SC-ZT150x120-SC.STEP
120.0 x 50.0 x 150.0 mm
