Kamikawa-Enclosure/Kamikawa-Enclosure-Open-Models/CAD-Drawings/SC-ZT190x120-SC.DXF

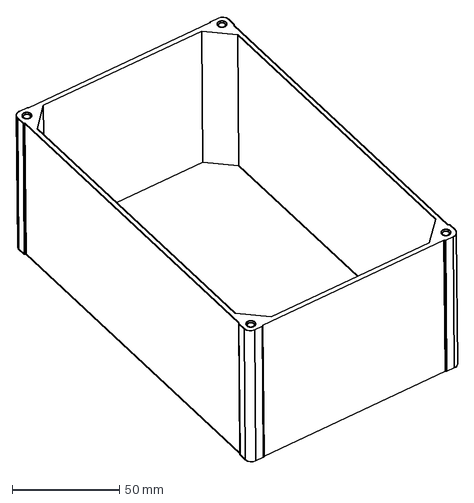
[picture p5: CAD file, 2026-11-07]
CAD-Drawings/SC-ZT190x120-SC.DXF
205.3 x 207.5 mm
