Kamikawa-Enclosure/Kamikawa-Enclosure-Open-Models/Product-Case-Studies-3D/SC-FT80x40-00.STEP

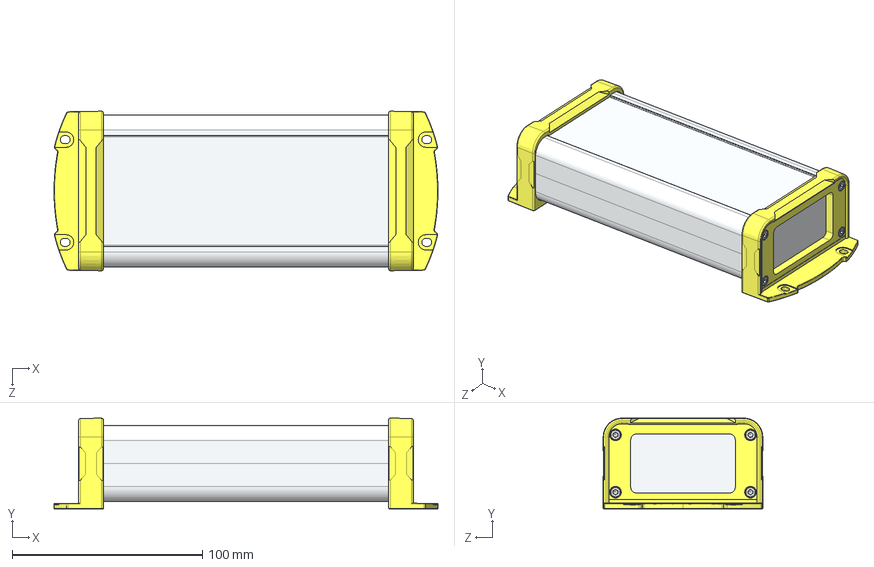
[picture p6: CAD file, 2026-10-11]
Product-Case-Studies-3D/SC-FT80x40-00.STEP
202.0 x 47.8 x 84.0 mm
SC-FT80x40-1.1-K61 x 2
SC-FT80x40-2.1-K61
SC-FT80x40-2.3-K61_黄色 x 2
SC-FT80x40-3.1-K61
hexagon socket head cap screws gb_GB_FASTENER_SCREWS_HSHCS M3X12-N x 8
