Kamikawa-Enclosure/Kamikawa-Enclosure-Open-Models/3D-Models/SC-ZT190x120-SC.STEP

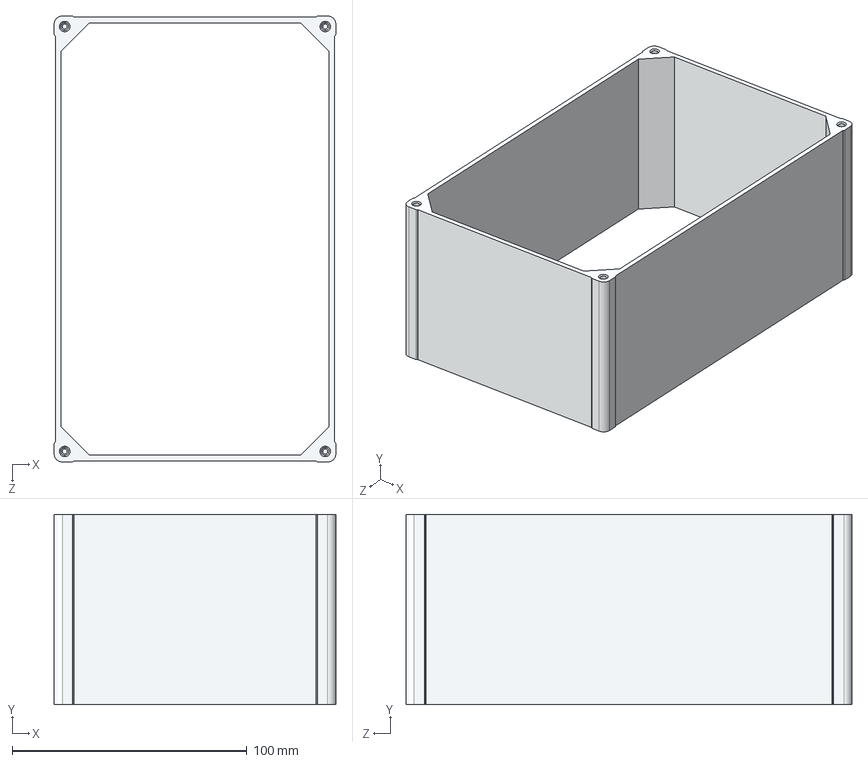
[picture p7: CAD file, 2026-11-07]
3D-Models/SC-ZT190x120-SC.STEP
120.0 x 81.0 x 190.0 mm
