Kamikawa-Enclosure/Kamikawa-Enclosure-Open-Models/CAD-Drawings/SC-ZT150x120-SC.DXF

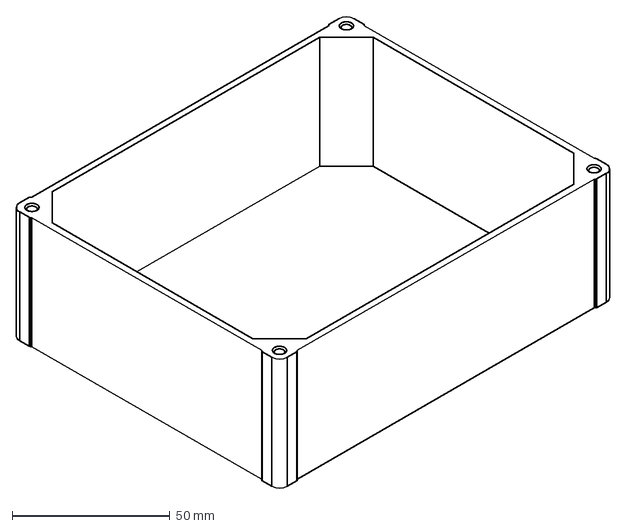
[picture p8: CAD file, 2026-11-07]
CAD-Drawings/SC-ZT150x120-SC.DXF
188.0 x 149.8 mm
