Kamikawa-Enclosure/Kamikawa-Enclosure-Open-Models/Product-Case-Studies-3D/SC-ZT200-200-60-A2003T.STEP

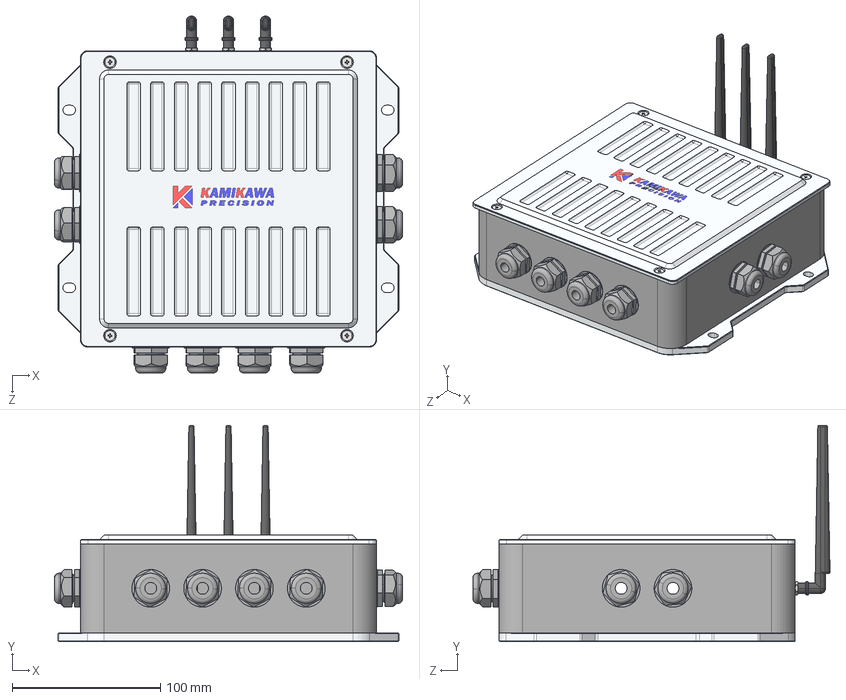
[picture p9: CAD file, 2026-08-10]
Product-Case-Studies-3D/SC-ZT200-200-60-A2003T.STEP
235.0 x 146.0 x 241.0 mm
SC-ZT200x200x60-1-A2003T
SC-ZT200x200x60-2-A2003T
cross recessed ctsk head screws type b gb_GB_CROSS_SCREWS_TYPE136 M4X10-N x 8
SC-ZT200x200x60-3-A2003T
SC-ZT200x200x60-4-A2003T x 4
cross recessed cheese head screws type a gb_GB_CROSS_SCREWS_TYPE135 M3X8-N x 4
SC-K150x120x60-6 x 3
SC-K150x120x60-7 x 3
SC-ZT200x200x60-5-A2003T x 8
