Kamikawa-Enclosure/Kamikawa-Enclosure-Open-Models/3D-Models/SC-FT106X54-K101.STEP

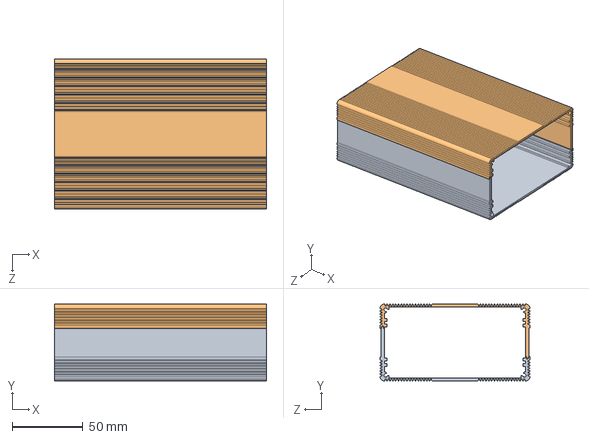
[picture p10: CAD file, 2026-11-05]
3D-Models/SC-FT106X54-K101.STEP
150.0 x 54.4 x 106.0 mm
