Kamikawa-Enclosure/Kamikawa-Enclosure-Open-Models/CAD-Drawings/SC-FT106X54-K101.dxf

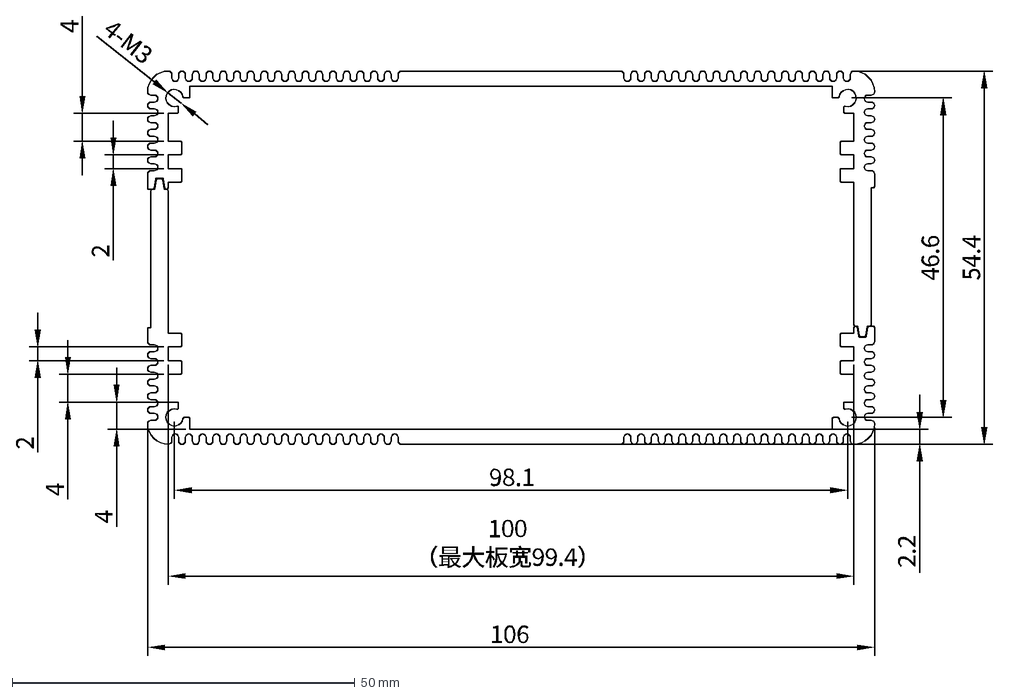
[picture p11: CAD file, 2026-11-05]
CAD-Drawings/SC-FT106X54-K101.dxf
98.1
46.6
106
54.4
4-M3
100 （最大板宽99.4）
2.2
2
4
