Kamikawa-Enclosure/Kamikawa-Enclosure-Open-Models/Product-Case-Studies-3D/SC-IT1000-00.STEP

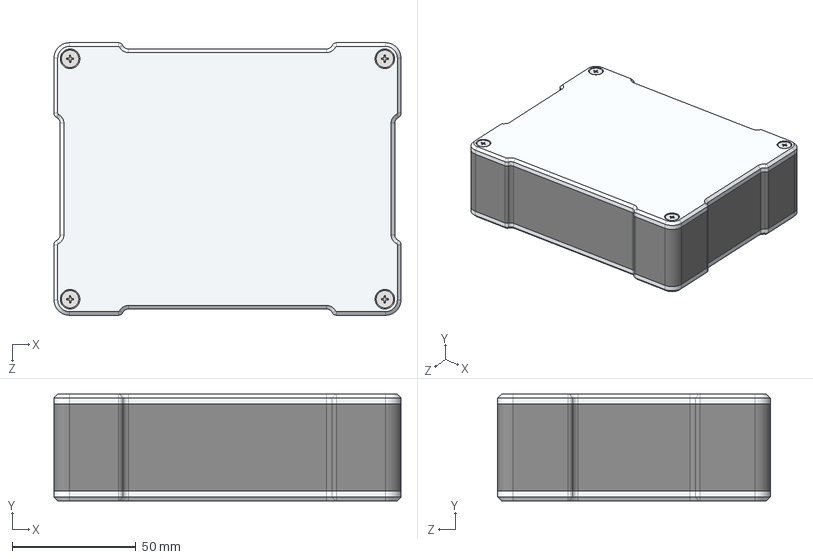
[picture p12: CAD file, 2026-07-21]
Product-Case-Studies-3D/SC-IT1000-00.STEP
140.0 x 43.0 x 110.0 mm
SC-IT1000-10
SC-IT1000-20
SC-IT1000-30
cross recessed ctsk head screws type b gb_GB_CROSS_SCREWS_TYPE136 M4X12-N x 8
