Kamikawa-Enclosure/Kamikawa-Enclosure-Open-Models/3D-Models/SC-FT75x35-K158.STEP

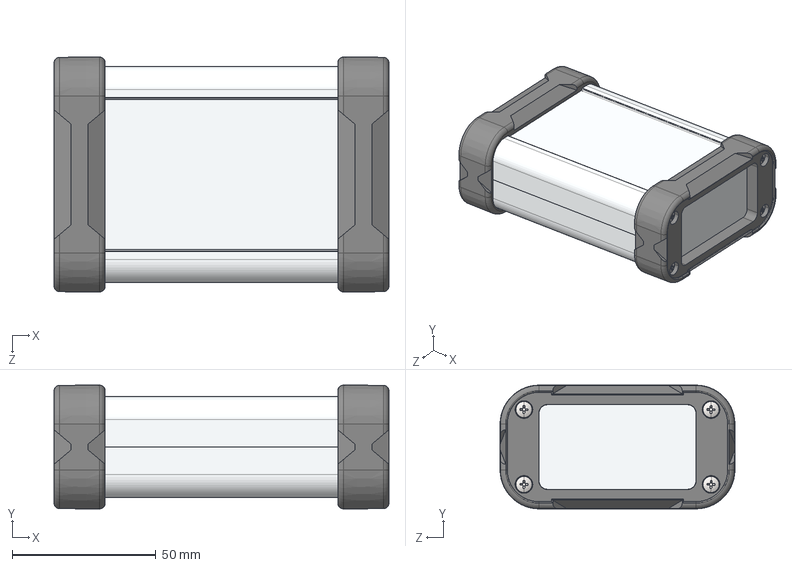
[picture p13: CAD file, 2026-10-18]
3D-Models/SC-FT75x35-K158.STEP
116.4 x 43.0 x 81.6 mm
SC-FT75x35-10_A
SC-FT75x35-10_B
SC-FT75x35-20_A
SC-FT75x35-20_B
SC-FT75x35-30_黑色 x 2
cross recessed pan head screws gb_GB M3X8-8 x 8
