Kamikawa-Enclosure/Kamikawa-Enclosure-Open-Models/CAD-Drawings/SC-FT75x35-K158.dxf

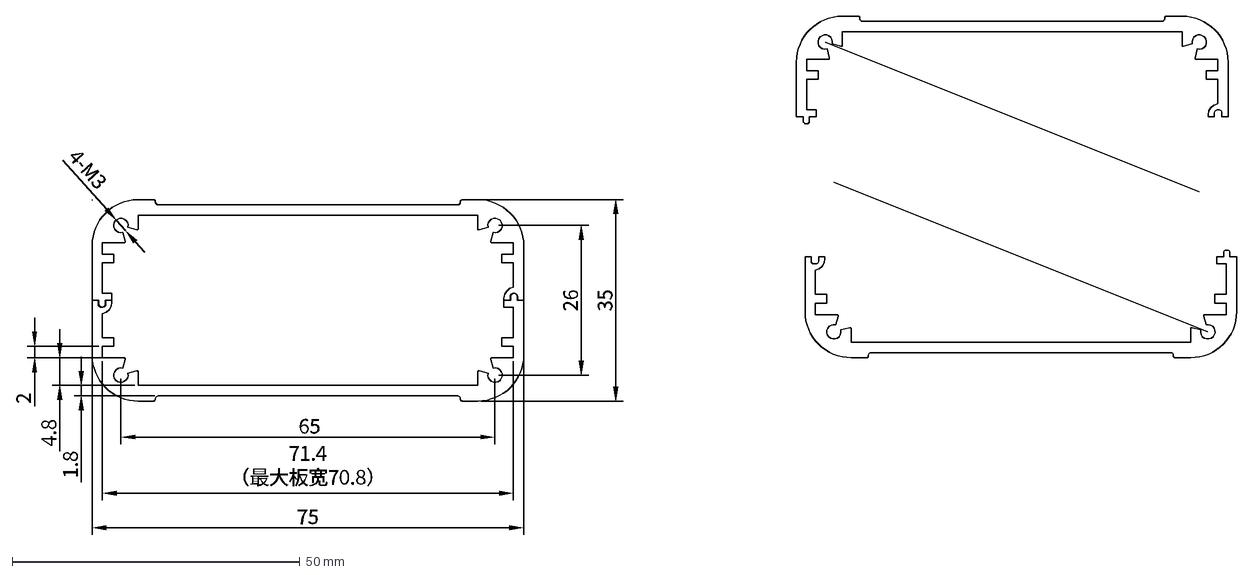
[picture p14: CAD file, 2026-10-18]
CAD-Drawings/SC-FT75x35-K158.dxf
4-M3
65
26
35
75
71.4 （最大板宽70.8）
1.8
4.8
2
