Kamikawa-Enclosure/Kamikawa-Enclosure-Open-Models/3D-Models/SC-FT120x40-K116.STEP

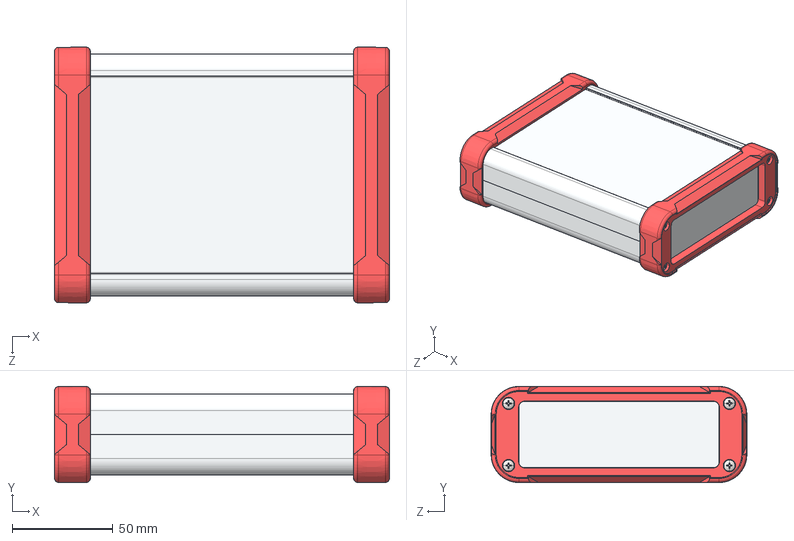
[picture p15: CAD file, 2026-10-18]
3D-Models/SC-FT120x40-K116.STEP
166.4 x 47.7 x 127.0 mm
SC-FT120x40-10_A
SC-FT120x40-10_B
SC-FT120x40-20_A
SC-FT120x40-20_B
SC-FT120x40-30_黑色 x 2
cross recessed pan head screws gb_GB M3X8-8 x 8
