Kamikawa-Enclosure/Kamikawa-Enclosure-Open-Models/CAD-Drawings/SC-FT120x40-K116.dxf

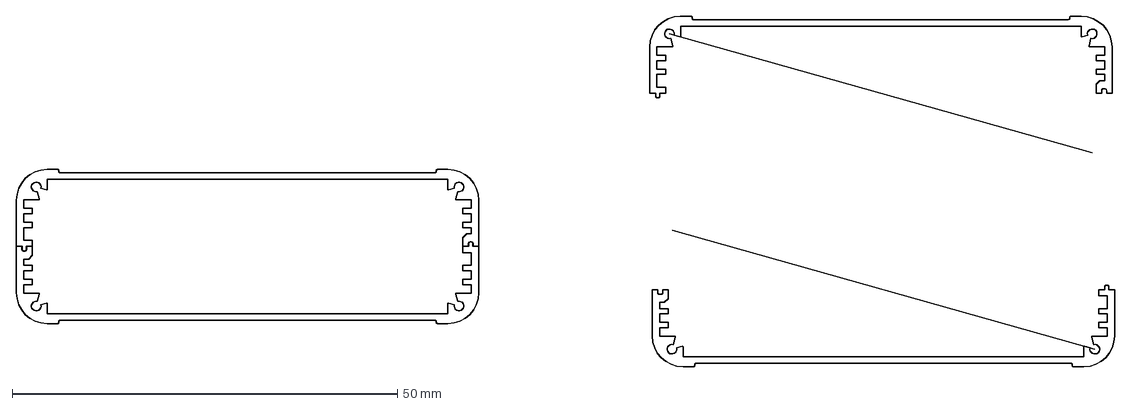
[picture p16: CAD file, 2026-10-18]
CAD-Drawings/SC-FT120x40-K116.dxf
142.5 x 45.5 mm
