Kamikawa-Enclosure/Kamikawa-Enclosure-Open-Models/3D-Models/SC-FT80x40-K61.STEP

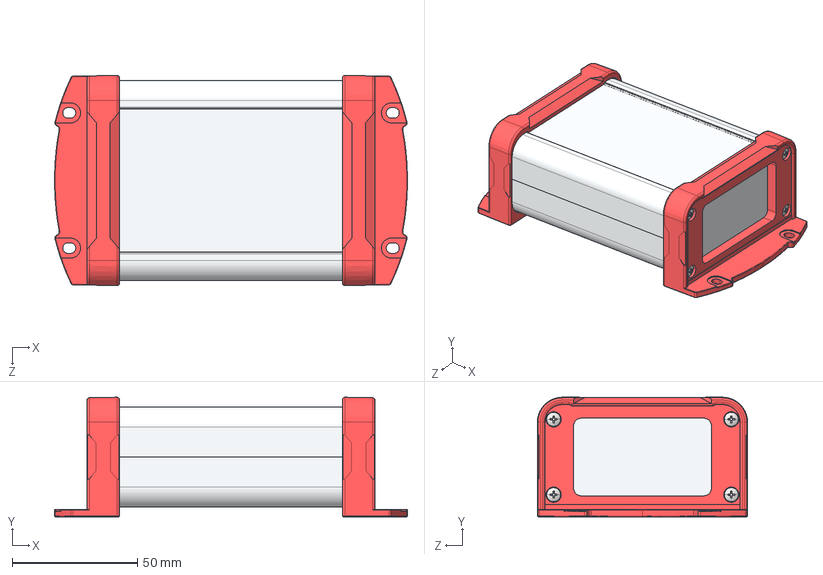
[picture p17: CAD file, 2026-10-18]
3D-Models/SC-FT80x40-K61.STEP
141.0 x 47.8 x 84.0 mm
SC-FT80x40-10_A
SC-FT80x40-10_B
SC-FT80x40-20_A
SC-FT80x40-20_B
cross recessed pan head screws gb_GB M3X8-8 x 8
SC-FT80x40-30_深蓝色 x 2
