Kamikawa-Enclosure/Kamikawa-Enclosure-Open-Models/CAD-Drawings/SC-FT80x40-K61.dxf

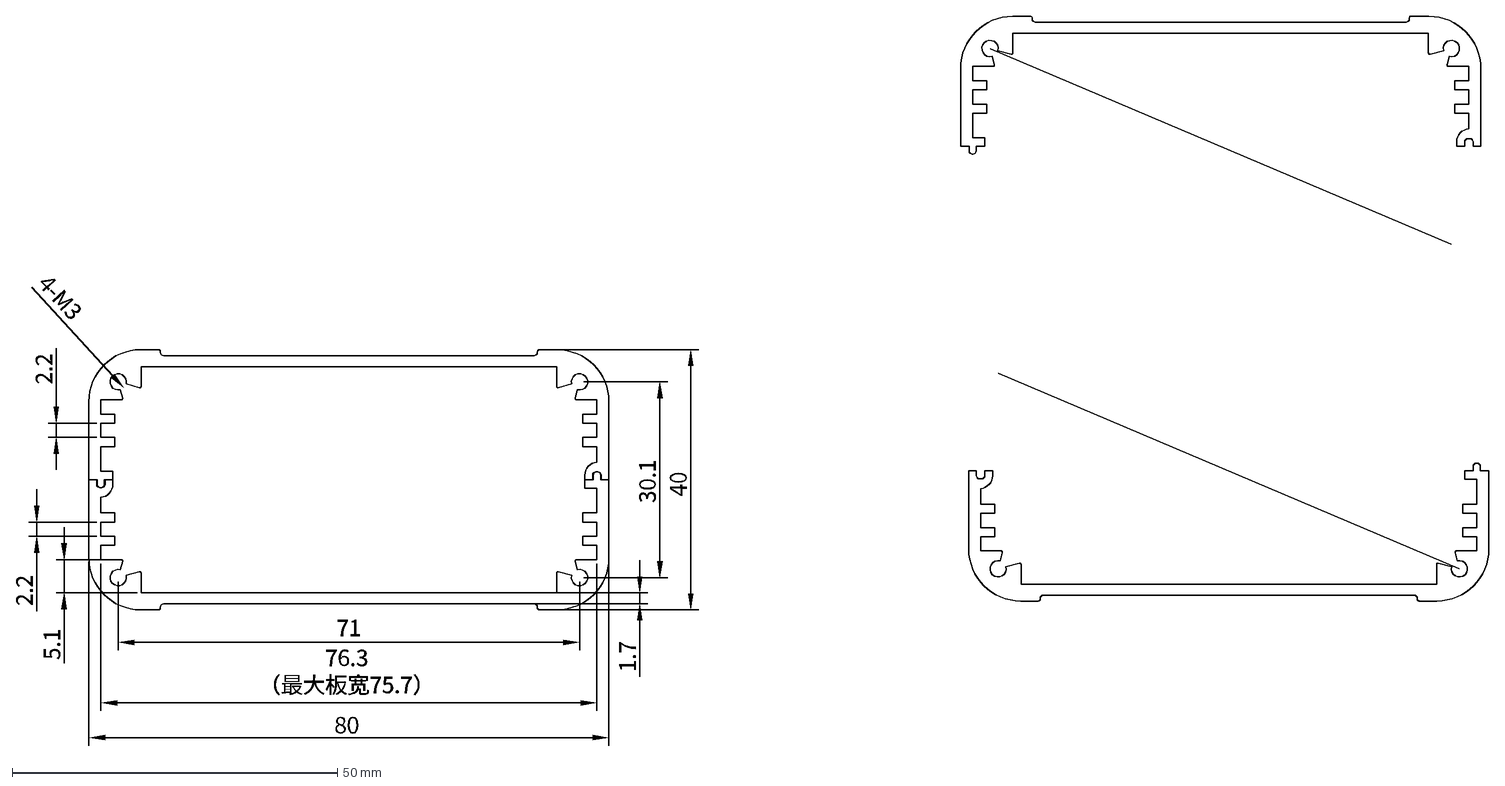
[picture p18: CAD file, 2026-10-18]
CAD-Drawings/SC-FT80x40-K61.dxf
30.1
80
40
76.3 （最大板宽75.7）
4-M3
1.7
5.1
2.2
71
