Kamikawa-Enclosure/Kamikawa-Enclosure-Open-Models/3D-Models/SC-FT90x35 K73.STEP

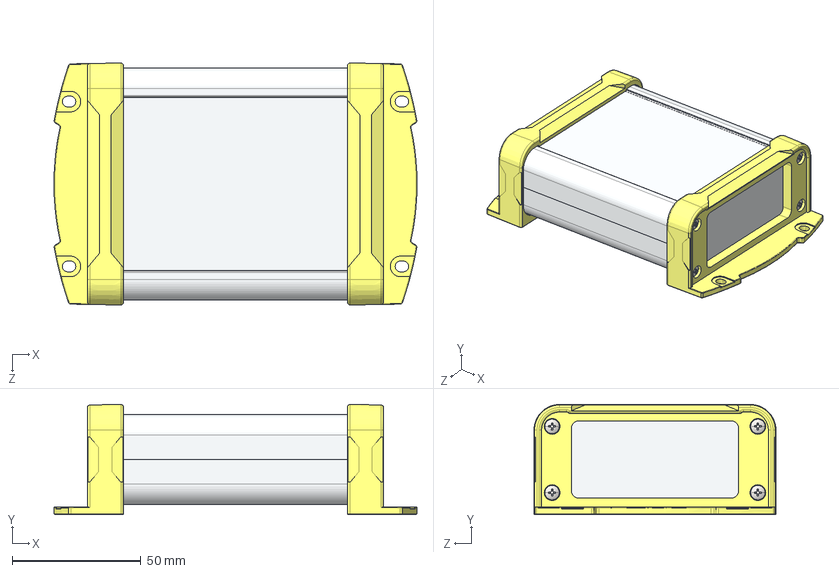
[picture p19: CAD file, 2026-10-18]
3D-Models/SC-FT90x35 K73.STEP
140.9 x 42.8 x 94.0 mm
SC-FT90x35-10_A
SC-FT90x35-10_B
SC-FT90x35-20_A
SC-FT90x35-20_B
SC-FT90x35-30_深蓝色 x 2
cross recessed pan head screws gb_GB M3X8-8 x 8
