Kamikawa-Enclosure/Kamikawa-Enclosure-Open-Models/CAD-Drawings/SC-FT90x35 K73.dxf

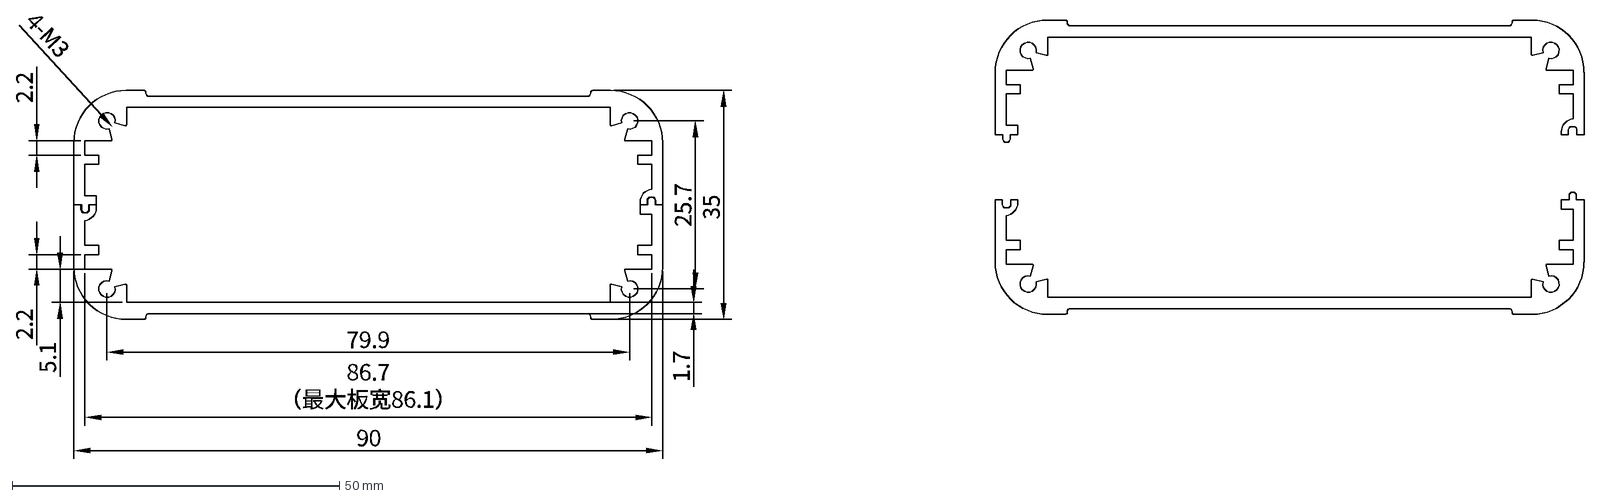
[picture p20: CAD file, 2026-10-18]
CAD-Drawings/SC-FT90x35 K73.dxf
79.9
25.7
4-M3
86.7 （最大板宽86.1）
5.1
1.7
90
35
2.2
