Kamikawa-Enclosure/Kamikawa-Enclosure-Open-Models/3D-Models/SC-FT140X70-K218.STEP

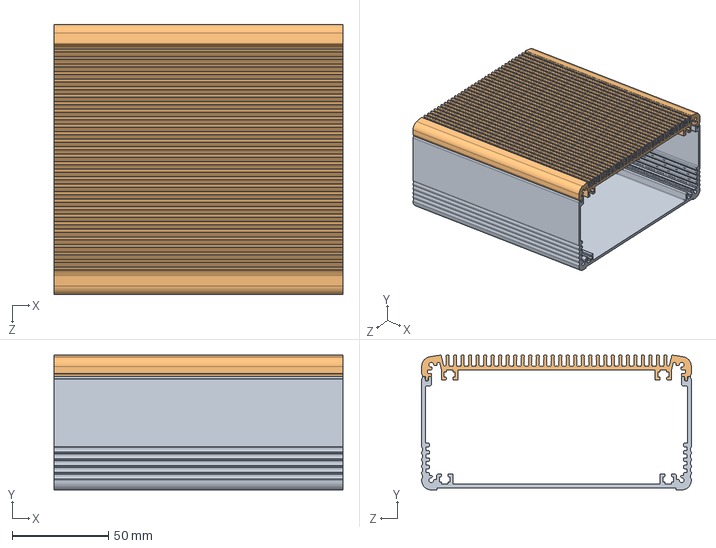
[picture p21: CAD file, 2026-10-17]
3D-Models/SC-FT140X70-K218.STEP
150.0 x 70.0 x 140.0 mm
