Kamikawa-Enclosure/Kamikawa-Enclosure-Open-Models/3D-Models/SC-FT140X90-K219.STEP

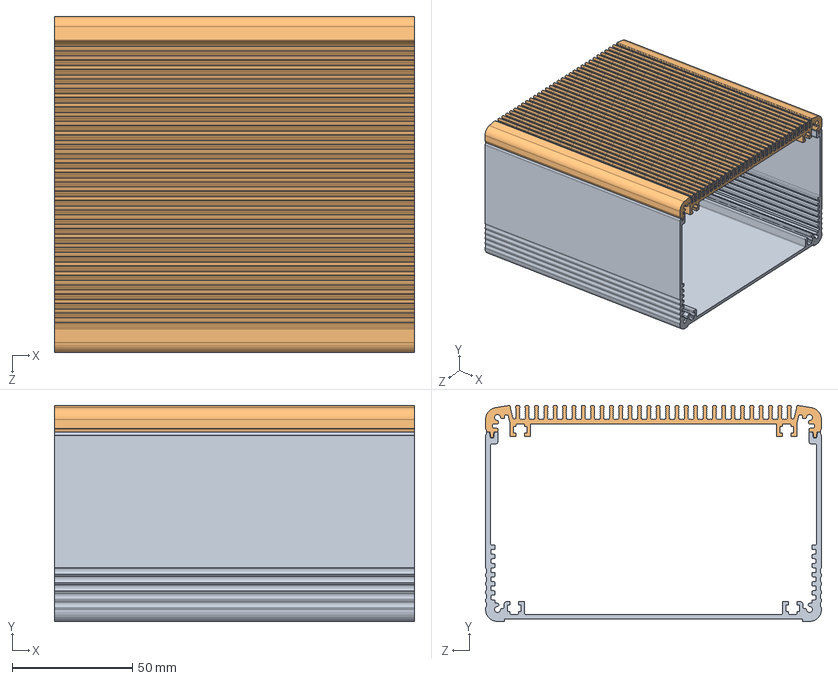
[picture p22: CAD file, 2026-10-17]
3D-Models/SC-FT140X90-K219.STEP
150.0 x 90.0 x 140.0 mm
