Kamikawa-Enclosure/Kamikawa-Enclosure-Open-Models/3D-Models/SC-ZT200x150-SC.STEP

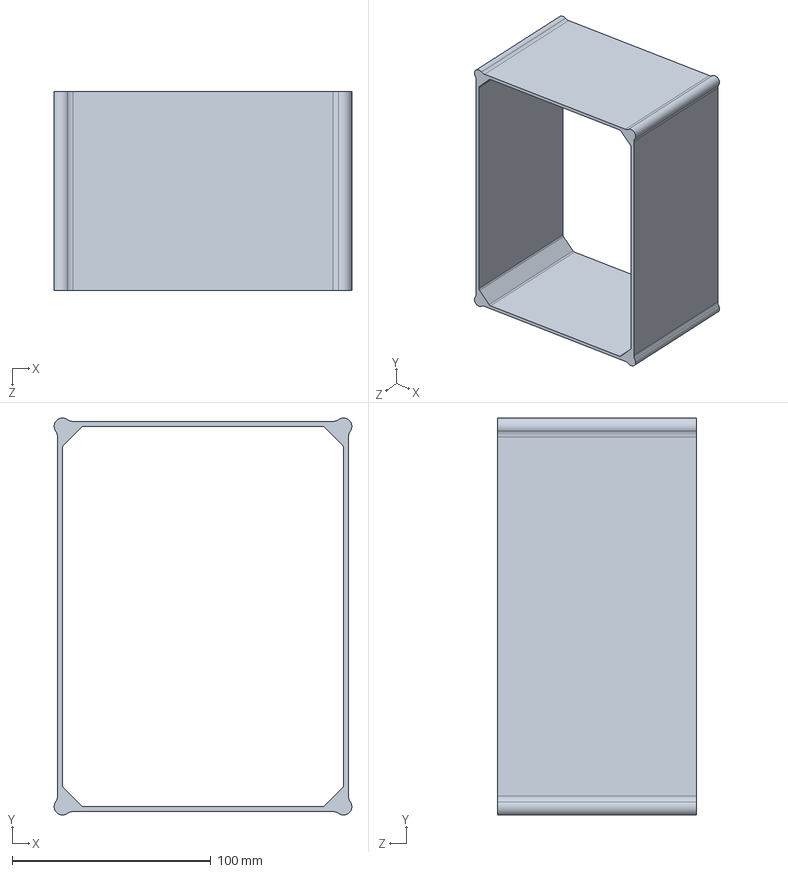
[picture p23: CAD file, 2026-10-16]
3D-Models/SC-ZT200x150-SC.STEP
150.0 x 200.0 x 100.0 mm
