Kamikawa-Enclosure/Kamikawa-Enclosure-Open-Models/3D-Models/SC-FT104X76.95-K337.STEP

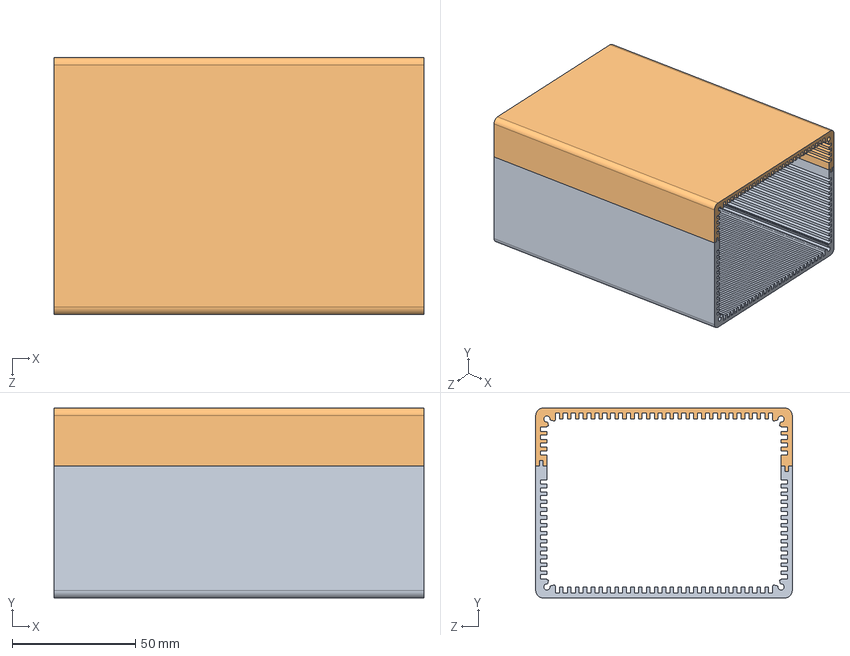
[picture p24: CAD file, 2026-09-08]
3D-Models/SC-FT104X76.95-K337.STEP
150.0 x 77.0 x 104.0 mm
