Kamikawa-Enclosure/Kamikawa-Enclosure-Open-Models/3D-Models/SC-ZT110X58-K175.STEP

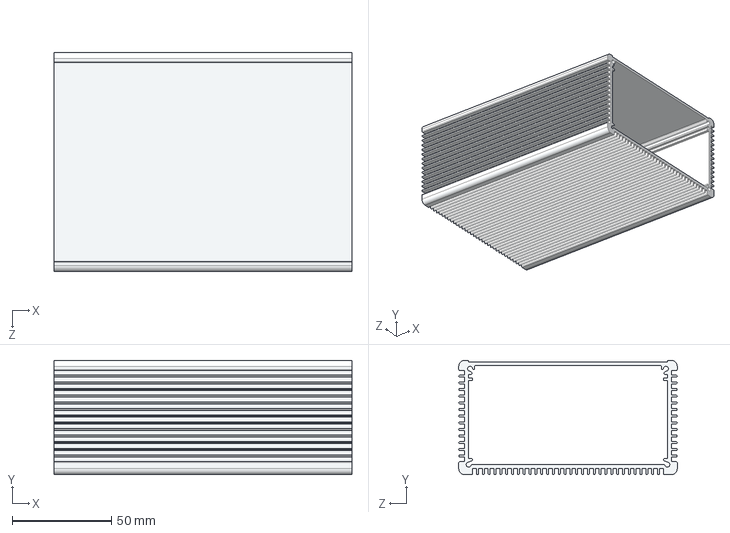
[picture p25: CAD file, 2026-08-13]
3D-Models/SC-ZT110X58-K175.STEP
150.0 x 57.5 x 110.0 mm
