Kamikawa-Enclosure/Kamikawa-Enclosure-Open-Models/3D-Models/SC-ZT120X32-K390.STEP

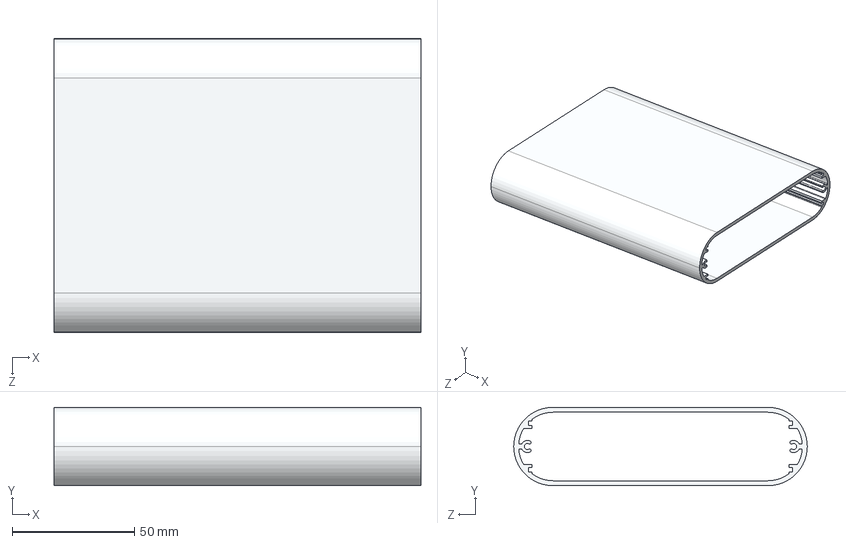
[picture p26: CAD file, 2026-08-12]
3D-Models/SC-ZT120X32-K390.STEP
150.0 x 32.0 x 120.0 mm
