Kamikawa-Enclosure/Kamikawa-Enclosure-Open-Models/CAD-Drawings/SC-FT177.6X39-K261.dxf

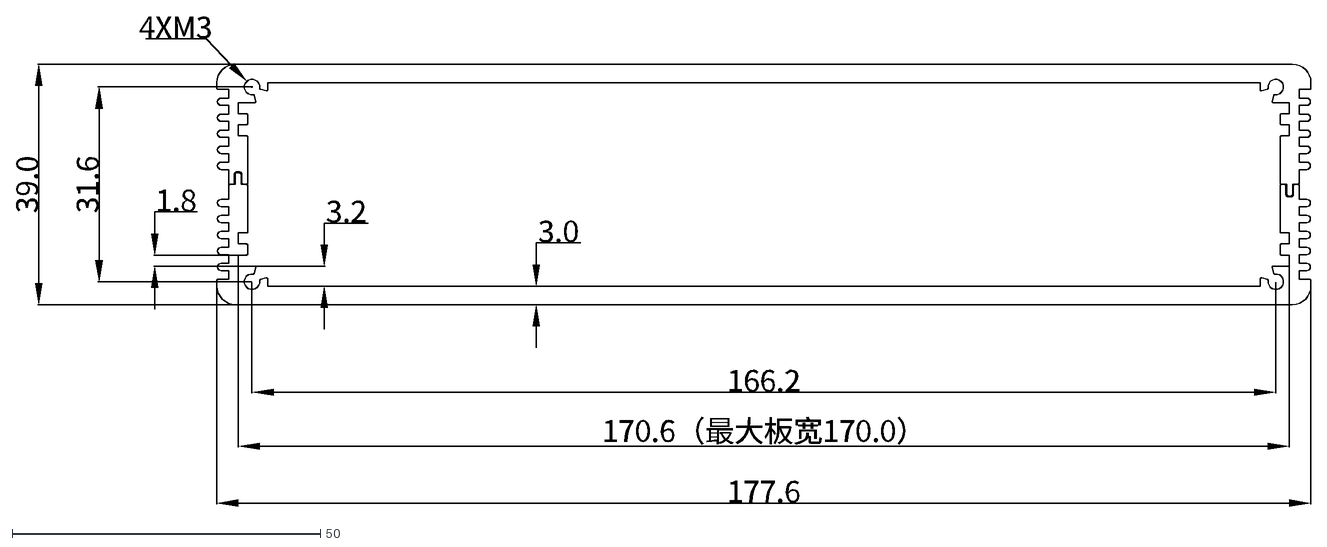
[picture p27: CAD file, 2026-07-27]
CAD-Drawings/SC-FT177.6X39-K261.dxf
1.8
3.2
3.0
166.2
170.6（最大板宽170.0）
177.6
31.6
39.0
4XM3
