Kamikawa-Enclosure/Kamikawa-Enclosure-Open-Models/3D-Models/SC-FT134X35.6-K129.STEP

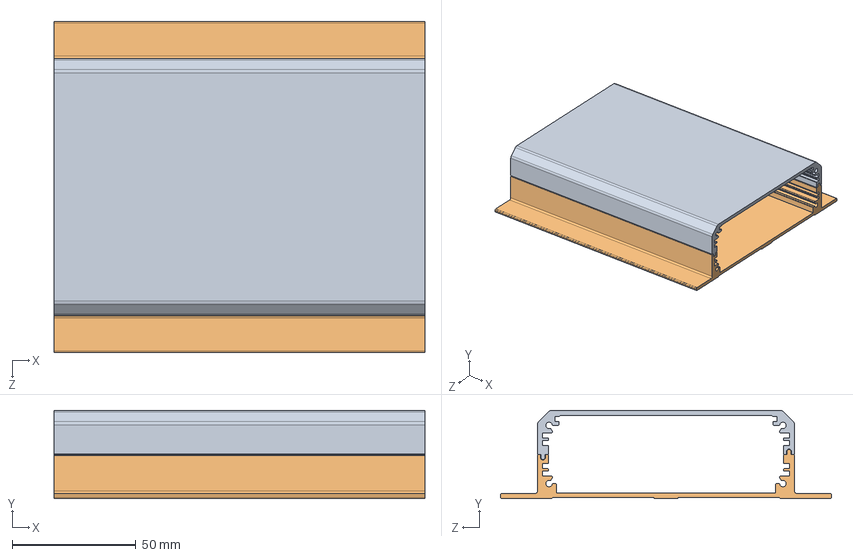
[picture p28: CAD file, 2026-07-24]
3D-Models/SC-FT134X35.6-K129.STEP
150.0 x 35.6 x 134.0 mm
