Kamikawa-Enclosure/Kamikawa-Enclosure-Open-Models/CAD-Drawings/SC-FT155.6X90-K461.dxf

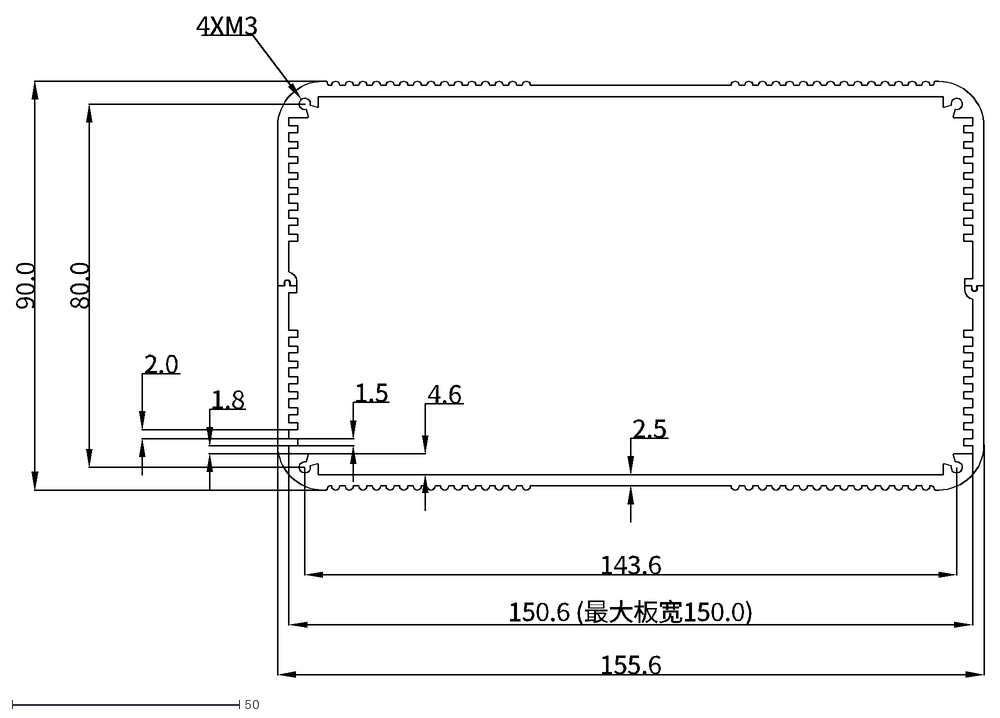
[picture p29: CAD file, 2026-07-27]
CAD-Drawings/SC-FT155.6X90-K461.dxf
155.6
90.0
1.8
2.0
1.5
4.6
2.5
143.6
150.6 (最大板宽150.0)
80.0
4XM3
