Kamikawa-Enclosure/Kamikawa-Enclosure-Open-Models/3D-Models/SC-FT50x40-K16.STEP

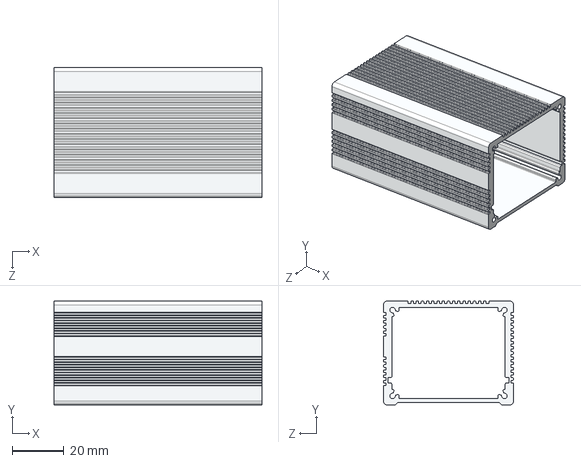
[picture p30: CAD file, 2026-07-23]
3D-Models/SC-FT50x40-K16.STEP
80.0 x 40.0 x 50.0 mm
