Kamikawa-Enclosure/Kamikawa-Enclosure-Open-Models/3D-Models/SC-ZT80X35-K170.STEP

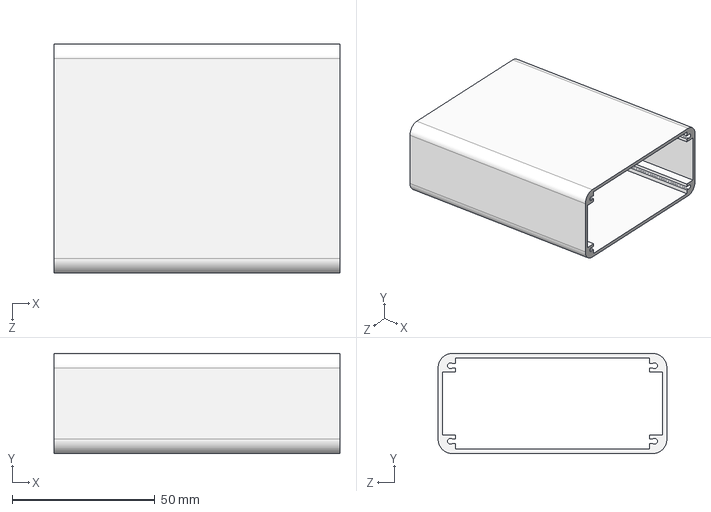
[picture p31: CAD file, 2026-07-23]
3D-Models/SC-ZT80X35-K170.STEP
100.0 x 35.0 x 80.0 mm
