Kamikawa-Enclosure/Kamikawa-Enclosure-Open-Models/CAD-Drawings/SC-ZT80X35-K170.dxf

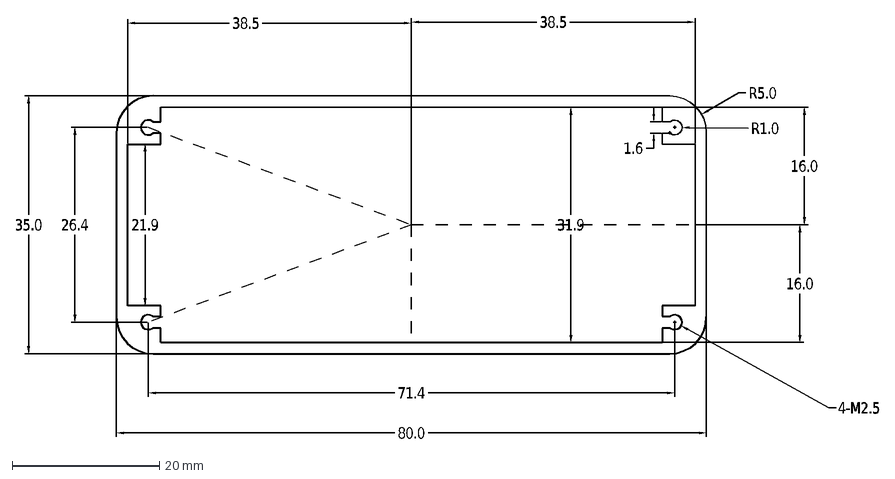
[picture p32: CAD file, 2026-07-23]
CAD-Drawings/SC-ZT80X35-K170.dxf
71.4
80.0
31.9
21.9
26.4
35.0
1.6
R1.0
R5.0
4-M2.5
38.5
16.0
