Kamikawa-Enclosure/Kamikawa-Enclosure-Open-Models/3D-Models/SC-FT140X50-K217.STEP

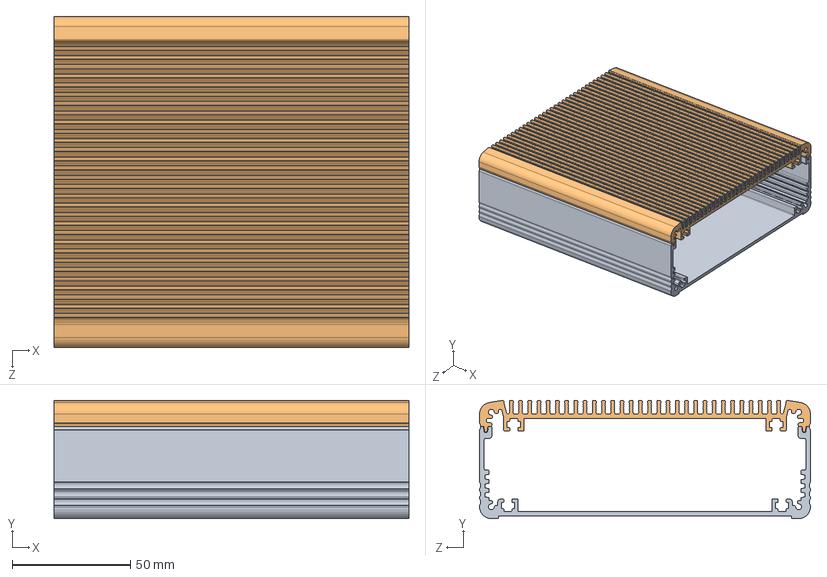
[picture p33: CAD file, 2026-07-18]
3D-Models/SC-FT140X50-K217.STEP
150.0 x 50.0 x 140.0 mm
