Kamikawa-Enclosure/Kamikawa-Enclosure-Open-Models/3D-Models/SC-FT91x58-K468.STEP

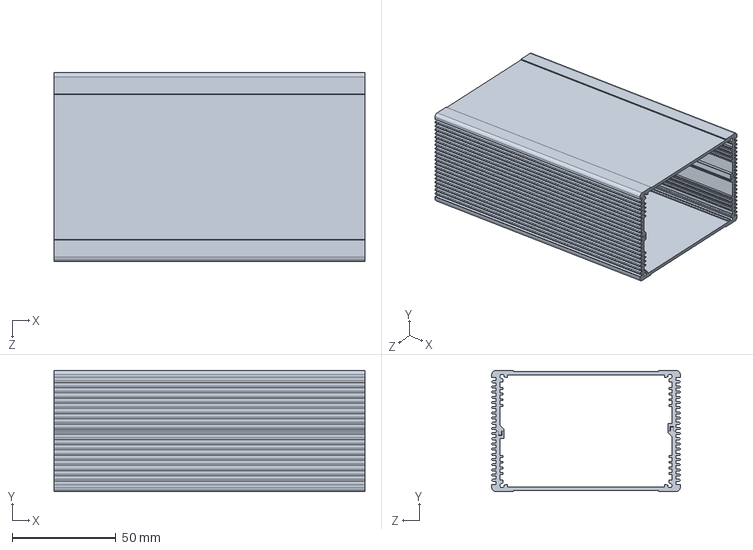
[picture p34: CAD file, 2026-07-14]
3D-Models/SC-FT91x58-K468.STEP
150.0 x 58.4 x 91.0 mm
