Kamikawa-Enclosure/Kamikawa-Enclosure-Open-Models/CAD-Drawings/SC-ZT340x280-A3009.dxf

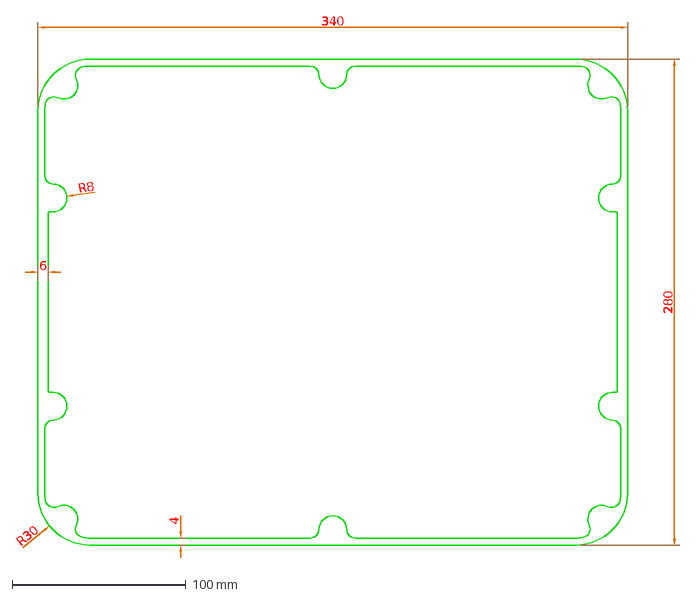
[picture p35: CAD file, 2026-07-02]
CAD-Drawings/SC-ZT340x280-A3009.dxf
340
280
4
6
R30
R8
