Kamikawa-Enclosure/Kamikawa-Enclosure-Open-Models/3D-Models/SC-FT145.6X65-K455.STEP

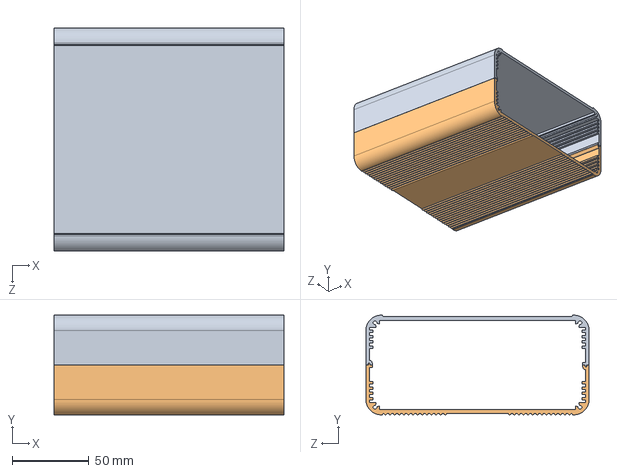
[picture p36: CAD file, 2026-07-14]
3D-Models/SC-FT145.6X65-K455.STEP
150.0 x 65.0 x 145.6 mm
