Kamikawa-Enclosure/Kamikawa-Enclosure-Open-Models/3D-Models/SC-ZT91x91-K477.STEP

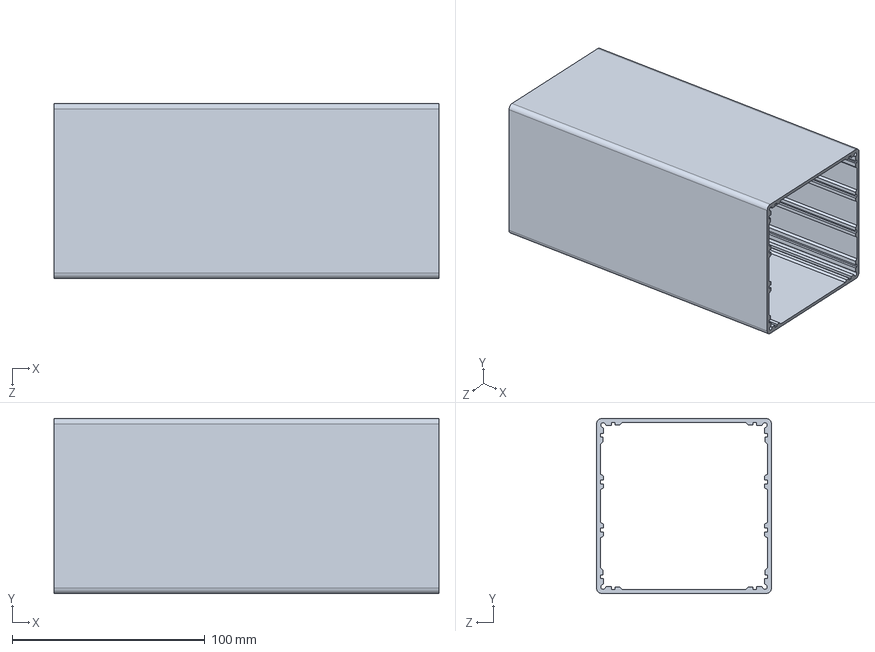
[picture p37: CAD file, 2026-07-14]
3D-Models/SC-ZT91x91-K477.STEP
200.0 x 91.0 x 91.0 mm
