Kamikawa-Enclosure/Kamikawa-Enclosure-Open-Models/CAD-Drawings/SC-ZT129.7x31-K127.dxf

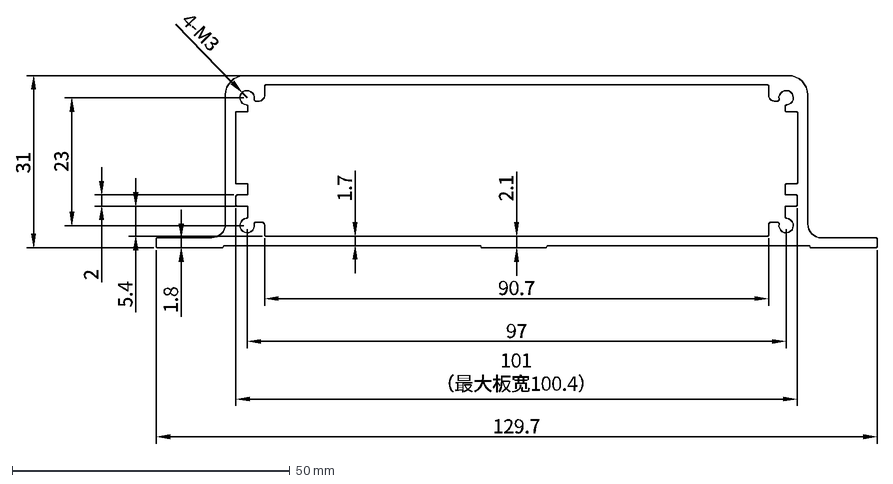
[picture p38: CAD file, 2026-07-02]
CAD-Drawings/SC-ZT129.7x31-K127.dxf
129.7
101 （最大板宽100.4）
97
90.7
31
23
1.7
2.1
1.8
5.4
2
4-M3
