Kamikawa-Enclosure/Kamikawa-Enclosure-Open-Models/3D-Models/SC-ZT92x46-K499.STEP

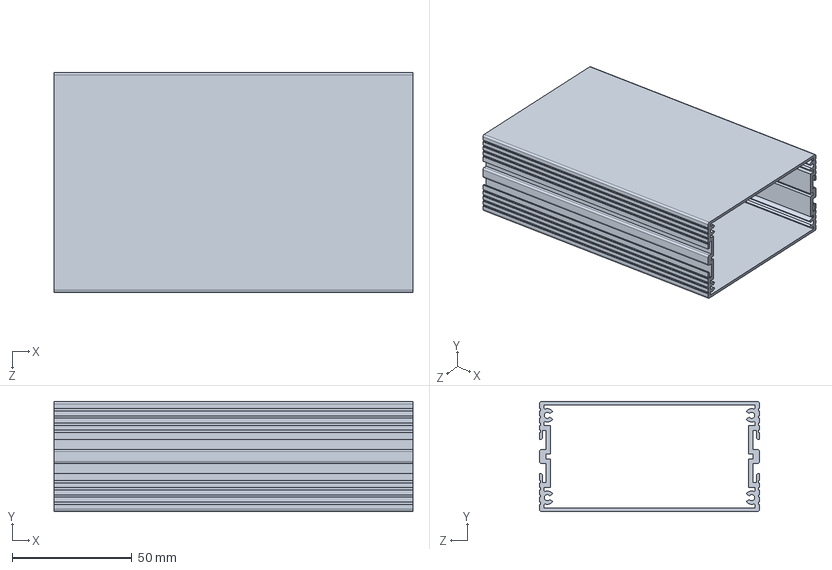
[picture p39: CAD file, 2026-07-14]
3D-Models/SC-ZT92x46-K499.STEP
150.0 x 46.0 x 92.0 mm
