Kamikawa-Enclosure/Kamikawa-Enclosure-Open-Models/CAD-Drawings/SC-ZT136X136-K132.dxf

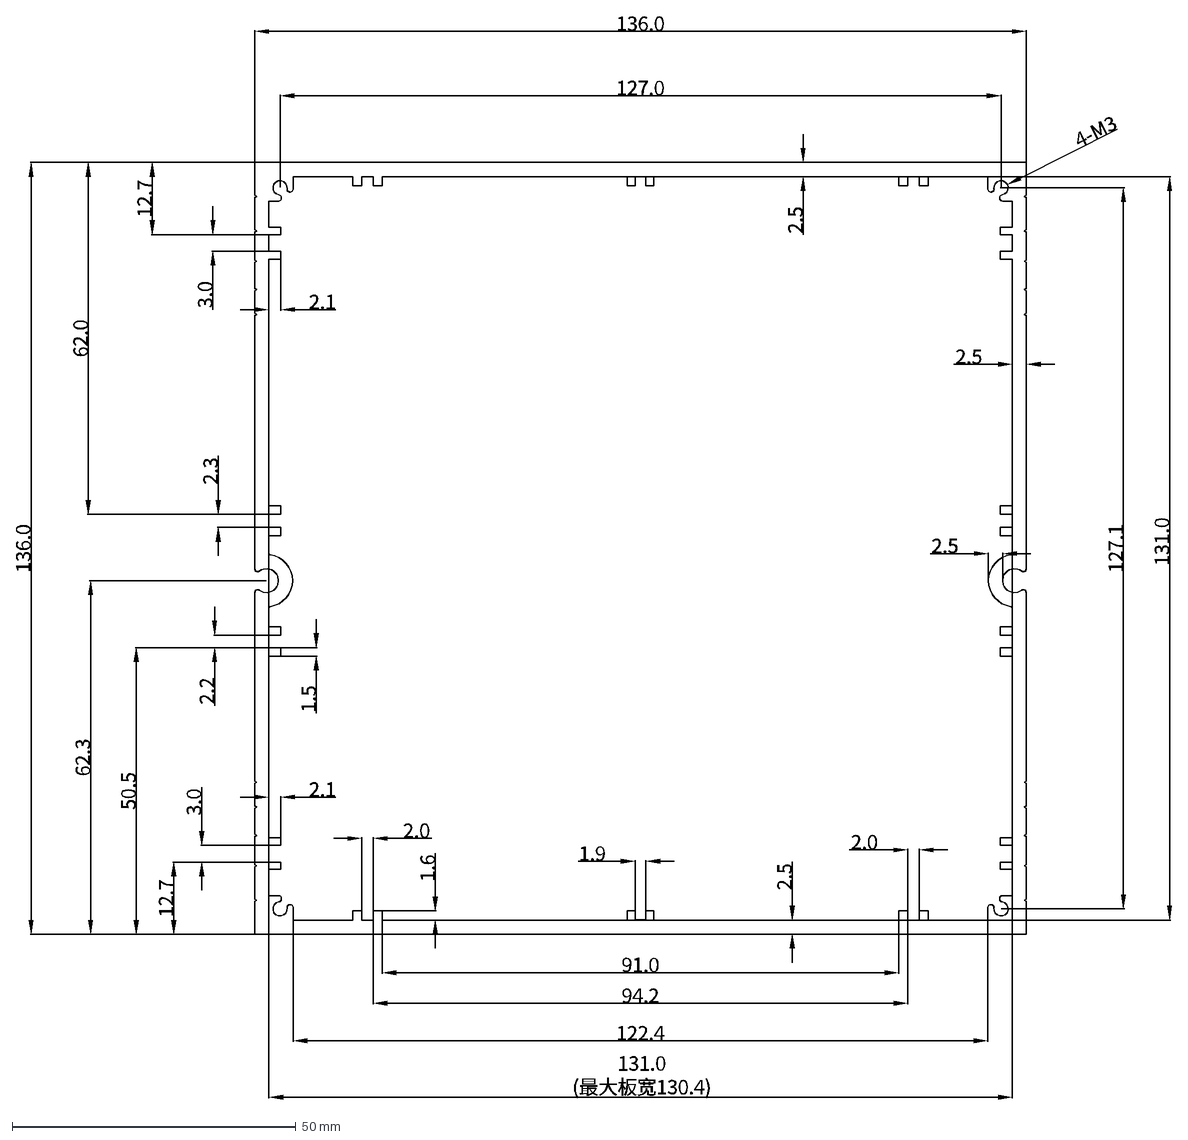
[picture p40: CAD file, 2026-07-02]
CAD-Drawings/SC-ZT136X136-K132.dxf
136.0
131.0 (最大板宽130.4)
62.3
131.0
127.0
127.1
2.5
2.0
1.9
94.2
1.6
91.0
122.4
12.7
3.0
50.5
62.0
2.3
2.1
2.2
1.5
4-M3
