Kamikawa-Enclosure/Kamikawa-Enclosure-Open-Models/3D-Models/SC-FT130X55-K451.STEP

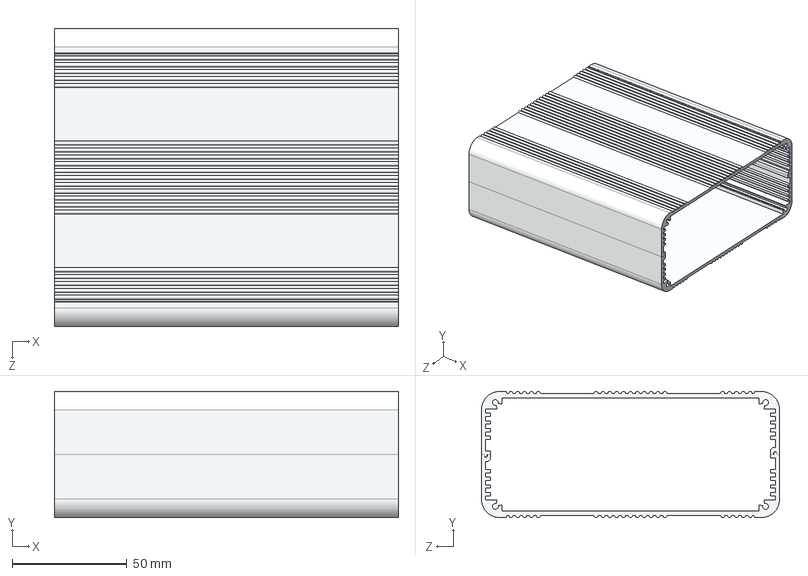
[picture p41: CAD file, 2026-07-14]
3D-Models/SC-FT130X55-K451.STEP
150.0 x 55.0 x 130.0 mm
