Kamikawa-Enclosure/Kamikawa-Enclosure-Open-Models/3D-Models/SC-FT175.6X65-K486.STEP

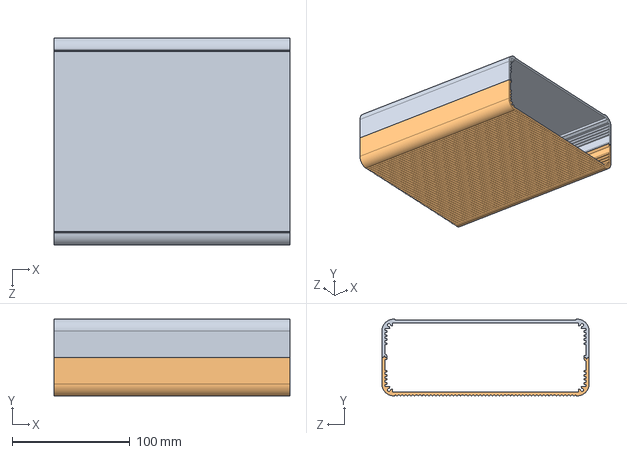
[picture p42: CAD file, 2026-07-14]
3D-Models/SC-FT175.6X65-K486.STEP
200.0 x 65.0 x 175.6 mm
