Kamikawa-Enclosure/Kamikawa-Enclosure-Open-Models/3D-Models/SC-FT240X85-K501.STEP

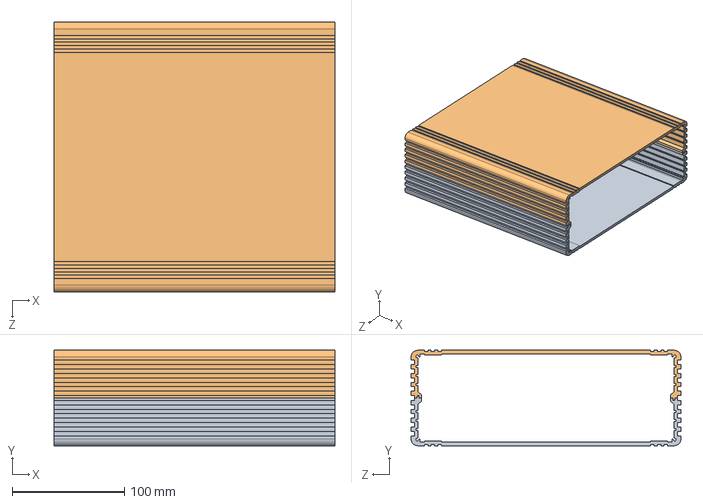
[picture p43: CAD file, 2026-07-14]
3D-Models/SC-FT240X85-K501.STEP
250.0 x 85.0 x 240.0 mm
