Kamikawa-Enclosure/Kamikawa-Enclosure-Open-Models/3D-Models/SC-ZT160X68.1-K476.STEP

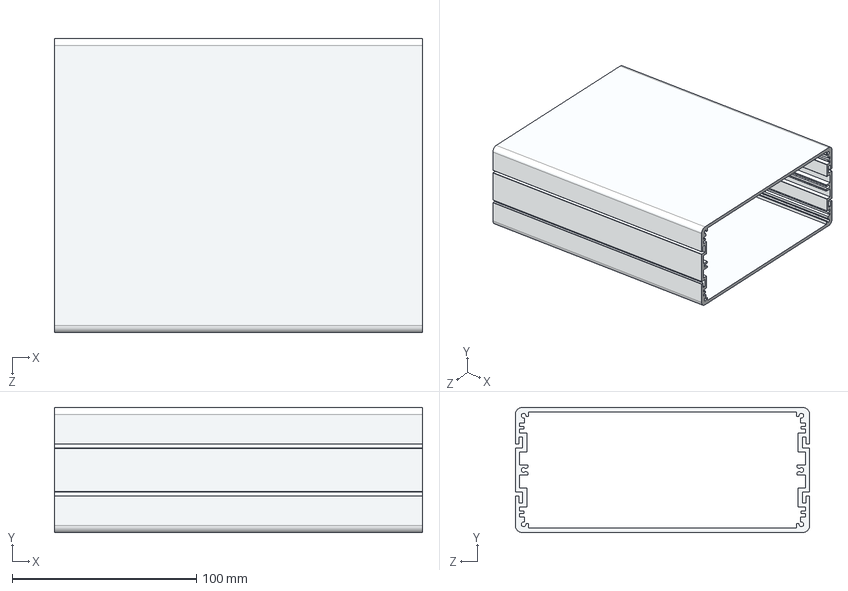
[picture p44: CAD file, 2026-07-14]
3D-Models/SC-ZT160X68.1-K476.STEP
200.0 x 68.1 x 160.0 mm
