Kamikawa-Enclosure/Kamikawa-Enclosure-Open-Models/3D-Models/SC-ZT175.6X65-K500.STEP

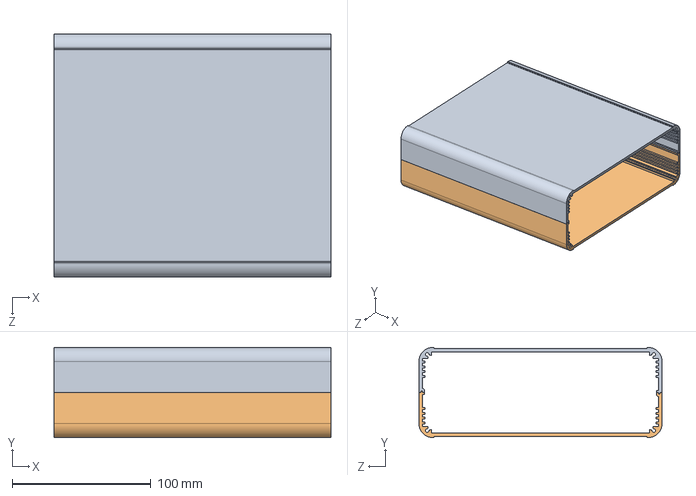
[picture p45: CAD file, 2026-07-14]
3D-Models/SC-ZT175.6X65-K500.STEP
200.0 x 65.0 x 175.6 mm
