Kamikawa-Enclosure/Kamikawa-Enclosure-Open-Models/CAD-Drawings/SC-ZT115.4x23.7-K111.dxf

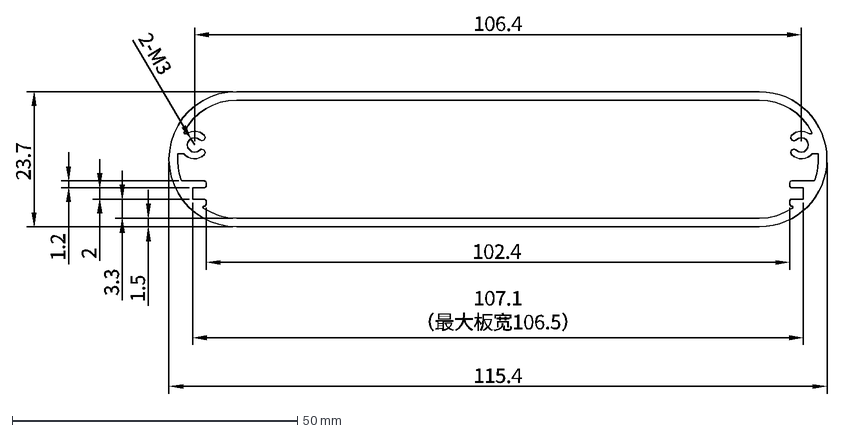
[picture p46: CAD file, 2026-07-02]
CAD-Drawings/SC-ZT115.4x23.7-K111.dxf
115.4
107.1 （最大板宽106.5）
102.4
23.7
106.4
1.5
3.3
2
1.2
2-M3
