Kamikawa-Enclosure/Kamikawa-Enclosure-Open-Models/3D-Models/SC-ZT150x37.4-K445.STEP

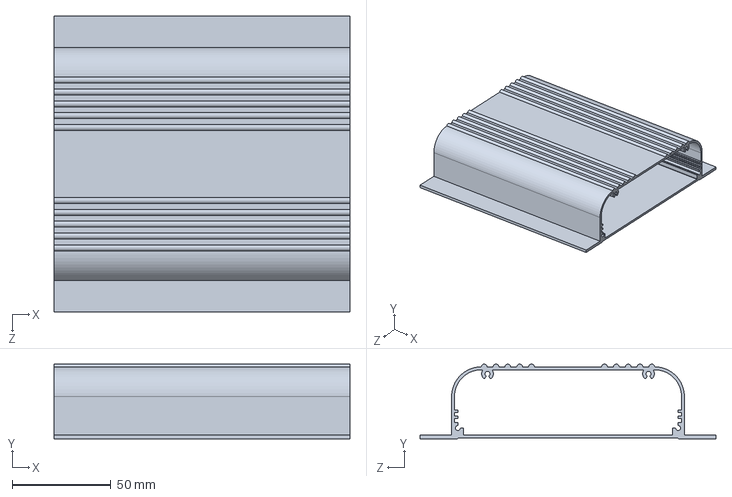
[picture p47: CAD file, 2026-07-14]
3D-Models/SC-ZT150x37.4-K445.STEP
150.0 x 37.9 x 150.0 mm
