Kamikawa-Enclosure/Kamikawa-Enclosure-Open-Models/3D-Models/SC-FT134.6X45-K440.STEP

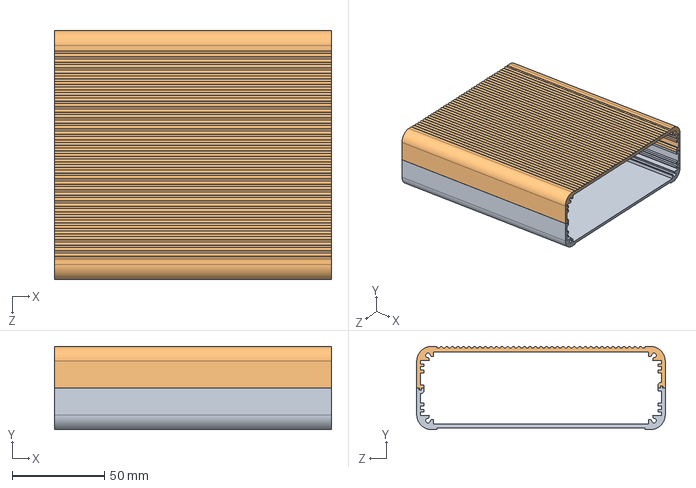
[picture p48: CAD file, 2026-07-14]
3D-Models/SC-FT134.6X45-K440.STEP
150.0 x 45.0 x 134.6 mm
