Kamikawa-Enclosure/Kamikawa-Enclosure-Open-Models/CAD-Drawings/SC-ZT121.5x28-K123.dxf

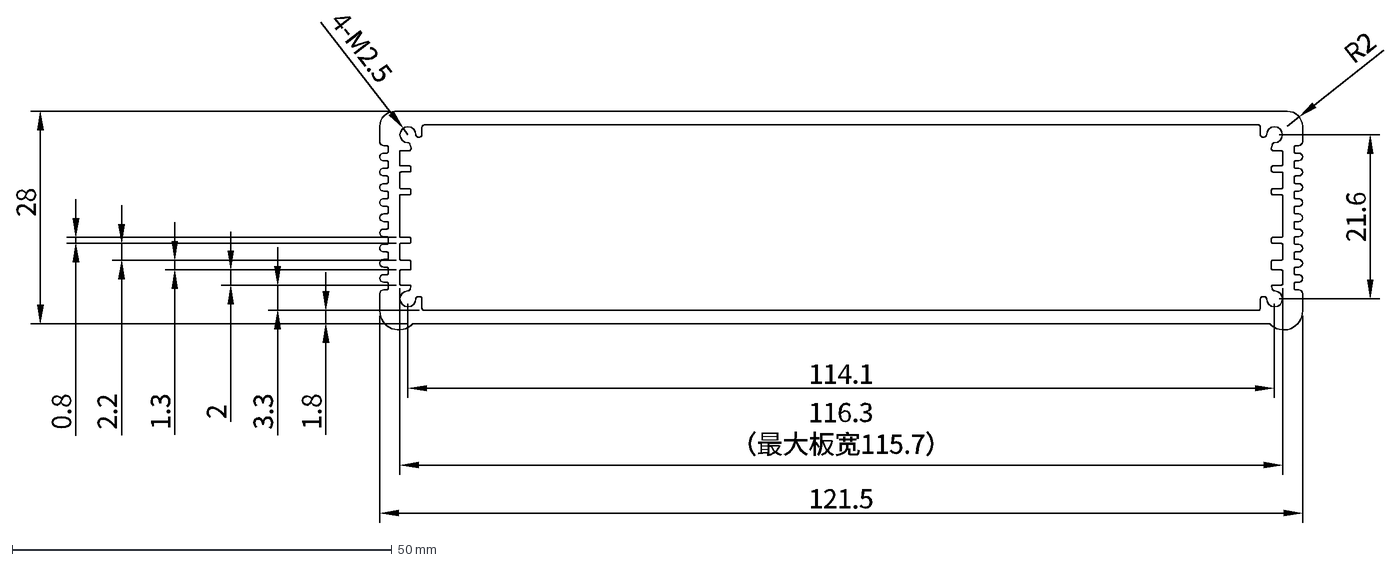
[picture p49: CAD file, 2026-07-02]
CAD-Drawings/SC-ZT121.5x28-K123.dxf
121.5
28
1.8
3.3
114.1
21.6
2
1.3
2.2
0.8
R2
4-M2.5
116.3 （最大板宽115.7）
