Kamikawa-Enclosure/Kamikawa-Enclosure-Open-Models/3D-Models/SC-ZT84X28-K504.STEP

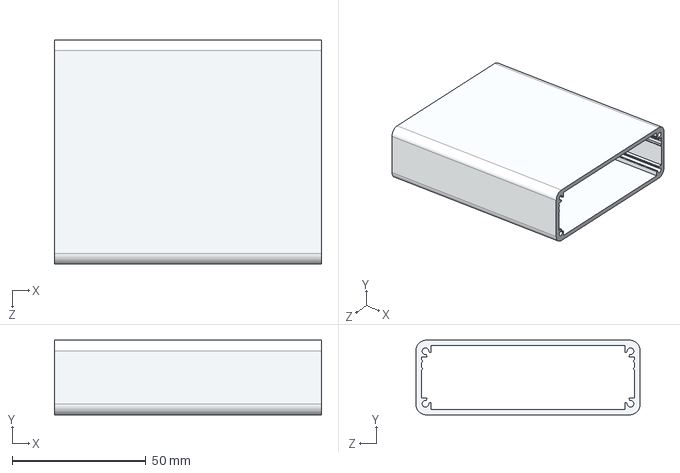
[picture p50: CAD file, 2026-07-14]
3D-Models/SC-ZT84X28-K504.STEP
100.0 x 28.0 x 84.0 mm
