Kamikawa-Enclosure/Kamikawa-Enclosure-Open-Models/CAD-Drawings/SC-ZT108x25.7-K104.dxf

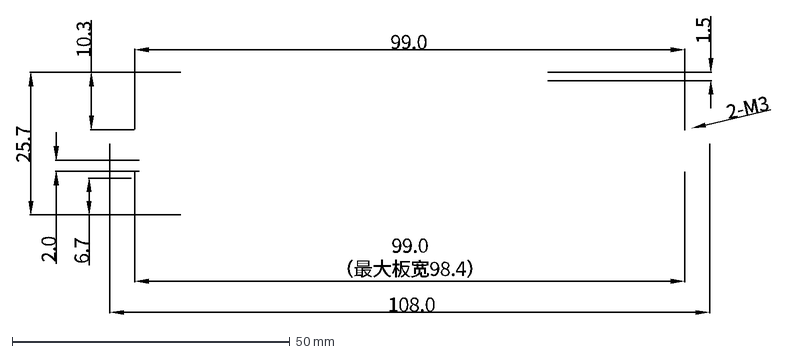
[picture p53: CAD file, 2026-07-02]
CAD-Drawings/SC-ZT108x25.7-K104.dxf
108.0
25.7
6.7
99.0 （最大板宽98.4）
99.0
10.3
2.0
2-M3
1.5
