Kamikawa-Enclosure/Kamikawa-Enclosure-Open-Models/3D-Models/SC-ZT137.77x34.1-K494.STEP

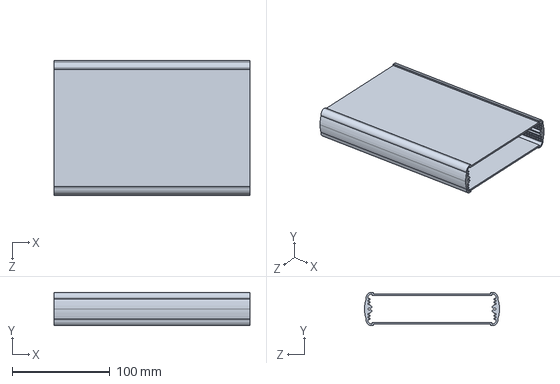
[picture p54: CAD file, 2026-07-14]
3D-Models/SC-ZT137.77x34.1-K494.STEP
200.0 x 34.1 x 137.8 mm
