Kamikawa-Enclosure/Kamikawa-Enclosure-Open-Models/3D-Models/SC-ZT110x46.9-K492.STEP

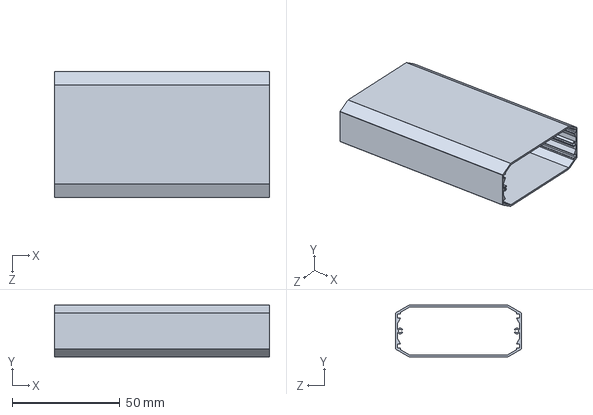
[picture p56: CAD file, 2026-07-14]
3D-Models/SC-ZT110x46.9-K492.STEP
100.0 x 24.1 x 58.6 mm
