Kamikawa-Enclosure/Kamikawa-Enclosure-Open-Models/CAD-Drawings/SC-ZT116x53-K112.dxf

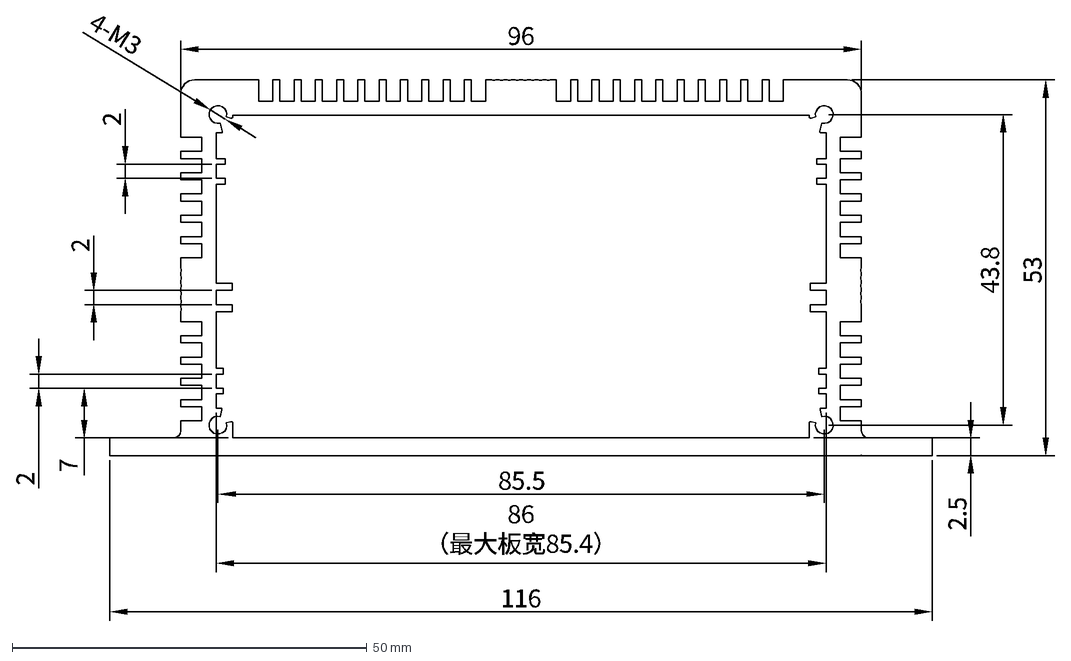
[picture p58: CAD file, 2026-07-02]
CAD-Drawings/SC-ZT116x53-K112.dxf
85.5
116
96
43.8
53
2.5
2
86 （最大板宽85.4）
4-M3
7
