Kamikawa-Enclosure/Kamikawa-Enclosure-Open-Models/3D-Models/SC-FT165.6X90-K475.STEP

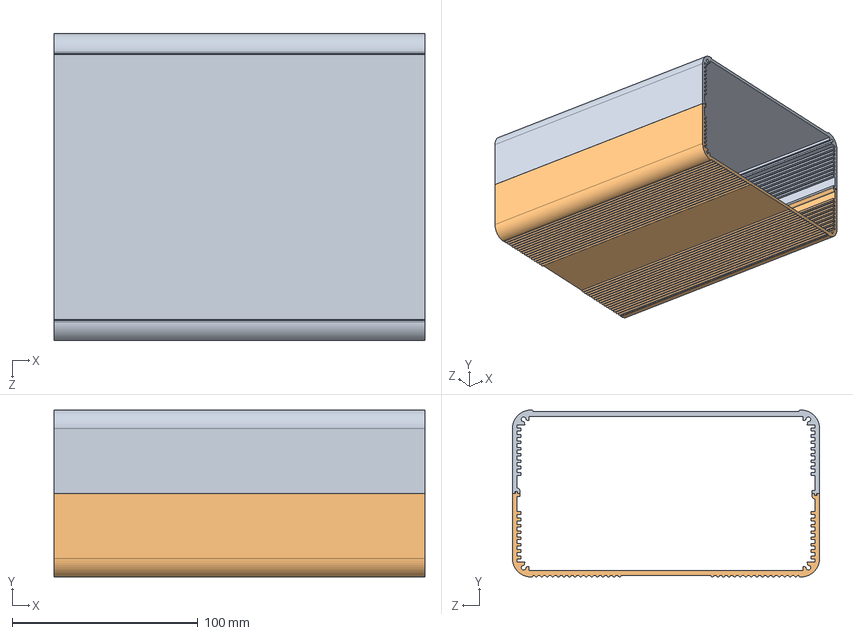
[picture p60: CAD file, 2026-07-14]
3D-Models/SC-FT165.6X90-K475.STEP
200.0 x 90.0 x 165.6 mm
