Kamikawa-Enclosure/Kamikawa-Enclosure-Open-Models/3D-Models/SC-FT145.6X65-K458.STEP

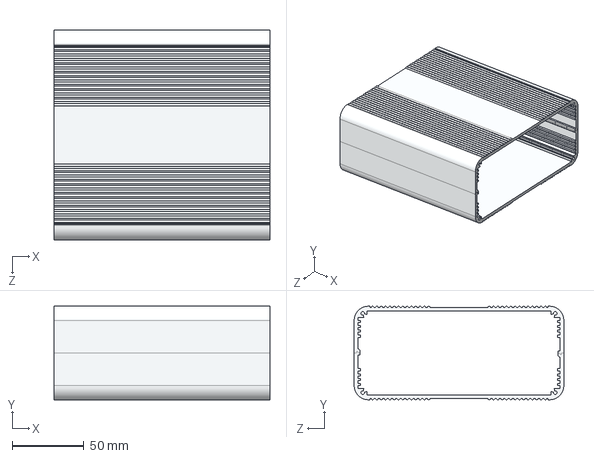
[picture p61: CAD file, 2026-07-14]
3D-Models/SC-FT145.6X65-K458.STEP
150.0 x 65.0 x 145.6 mm
