Kamikawa-Enclosure/Kamikawa-Enclosure-Open-Models/CAD-Drawings/SC-ZT110x28-K105.dxf

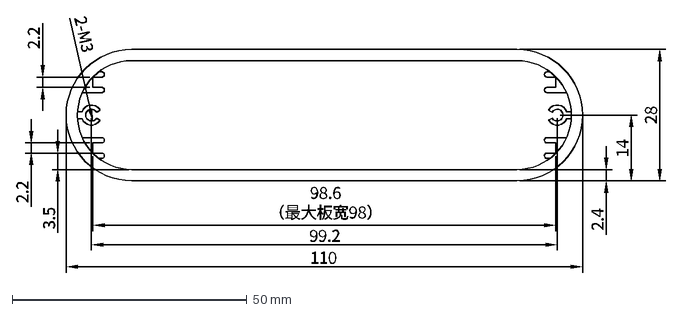
[picture p62: CAD file, 2026-07-02]
CAD-Drawings/SC-ZT110x28-K105.dxf
99.2
14
28
98.6 （最大板宽98）
2.2
110
2.4
3.5
2-M3
