Kamikawa-Enclosure/Kamikawa-Enclosure-Open-Models/3D-Models/SC-ZT58x20-K448.STEP

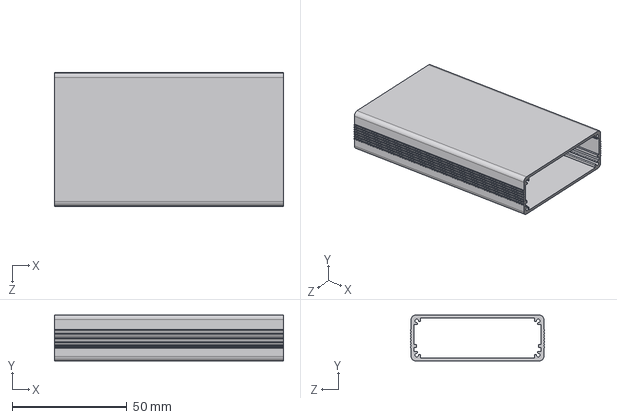
[picture p63: CAD file, 2026-07-14]
3D-Models/SC-ZT58x20-K448.STEP
100.0 x 20.0 x 58.6 mm
