Kamikawa-Enclosure/Kamikawa-Enclosure-Open-Models/3D-Models/SC-FT210X54-K503.STEP

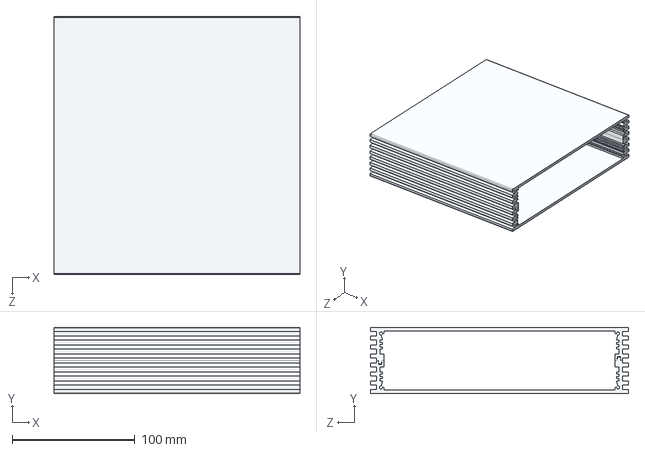
[picture p64: CAD file, 2026-07-14]
3D-Models/SC-FT210X54-K503.STEP
200.0 x 54.0 x 210.0 mm
