Kamikawa-Enclosure/Kamikawa-Enclosure-Open-Models/3D-Models/SC-FT124.6X45-K437.STEP

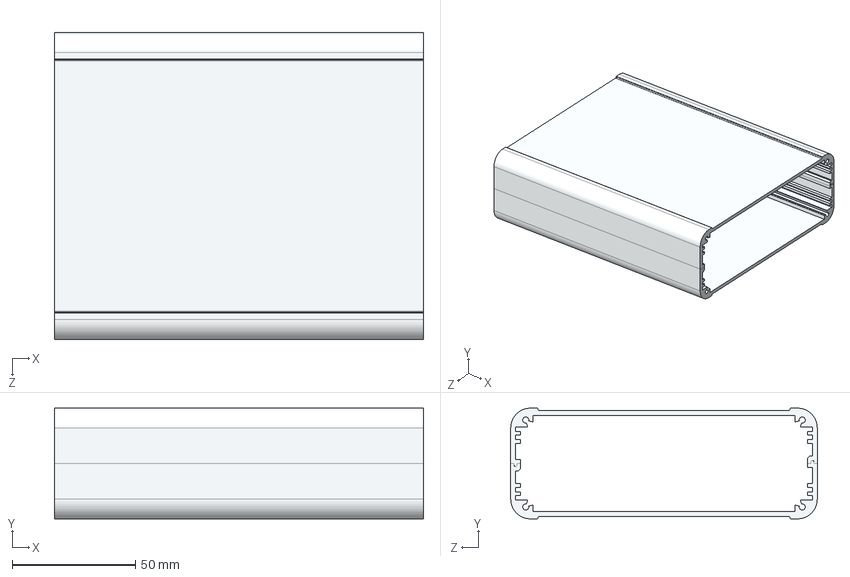
[picture p65: CAD file, 2026-07-14]
3D-Models/SC-FT124.6X45-K437.STEP
150.0 x 45.0 x 124.6 mm
