Kamikawa-Enclosure/Kamikawa-Enclosure-Open-Models/3D-Models/SC-FT155.6X90-K461.STEP

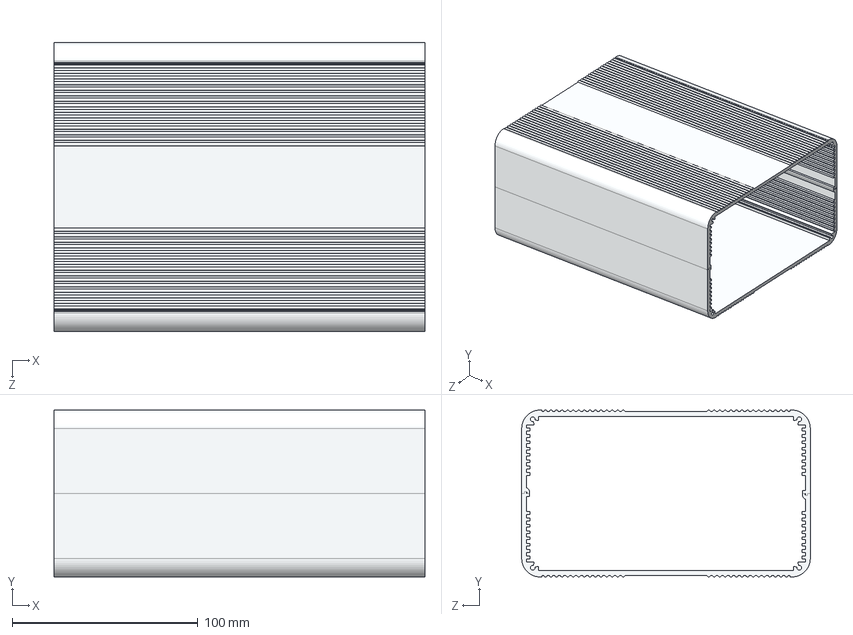
[picture p67: CAD file, 2026-07-14]
3D-Models/SC-FT155.6X90-K461.STEP
200.0 x 90.0 x 155.6 mm
