Kamikawa-Enclosure/Kamikawa-Enclosure-Open-Models/3D-Models/SC-FT134.6X45-K439.STEP

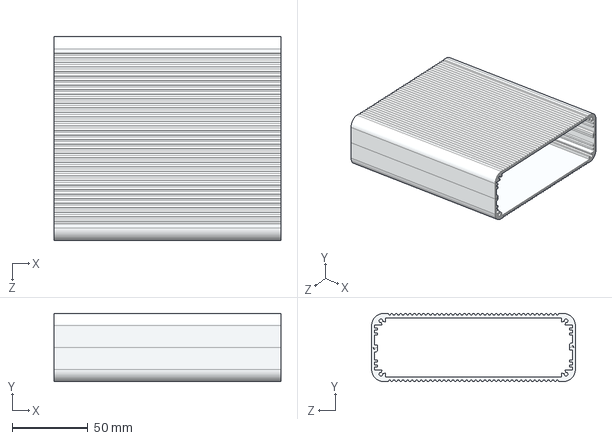
[picture p68: CAD file, 2026-07-14]
3D-Models/SC-FT134.6X45-K439.STEP
150.0 x 45.0 x 134.6 mm
