Kamikawa-Enclosure/Kamikawa-Enclosure-Open-Models/3D-Models/SC-FT205.6X65-K488.STEP

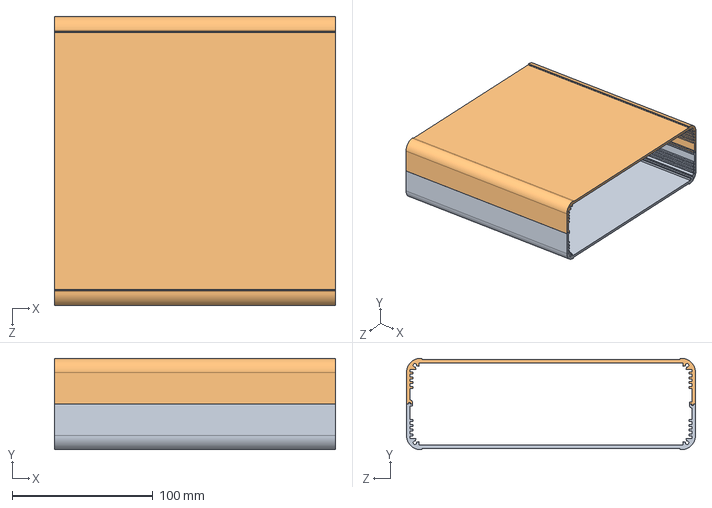
[picture p69: CAD file, 2026-07-14]
3D-Models/SC-FT205.6X65-K488.STEP
200.0 x 65.0 x 205.6 mm
