Kamikawa-Enclosure/Kamikawa-Enclosure-Open-Models/3D-Models/SC-ZT96.6x36.5-K498.STEP

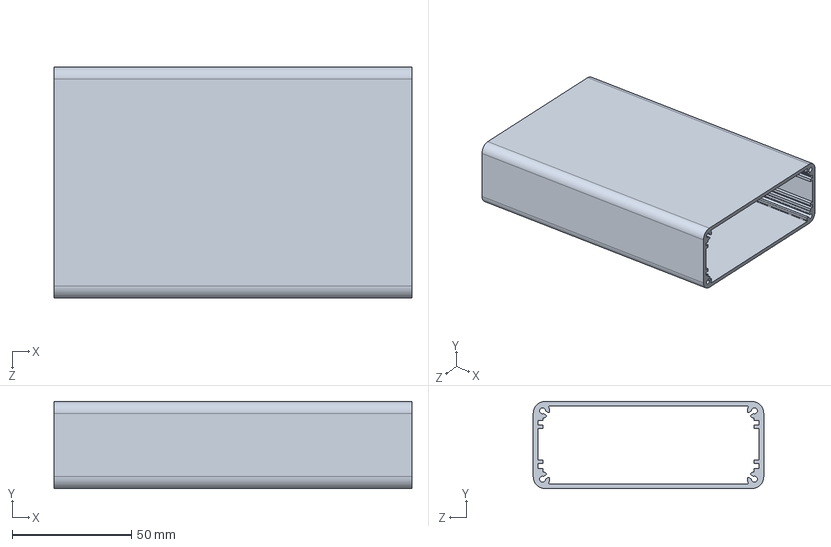
[picture p70: CAD file, 2026-07-14]
3D-Models/SC-ZT96.6x36.5-K498.STEP
150.0 x 36.5 x 96.6 mm
