Kamikawa-Enclosure/Kamikawa-Enclosure-Open-Models/CAD-Drawings/SC-ZT84x28-K67.dxf

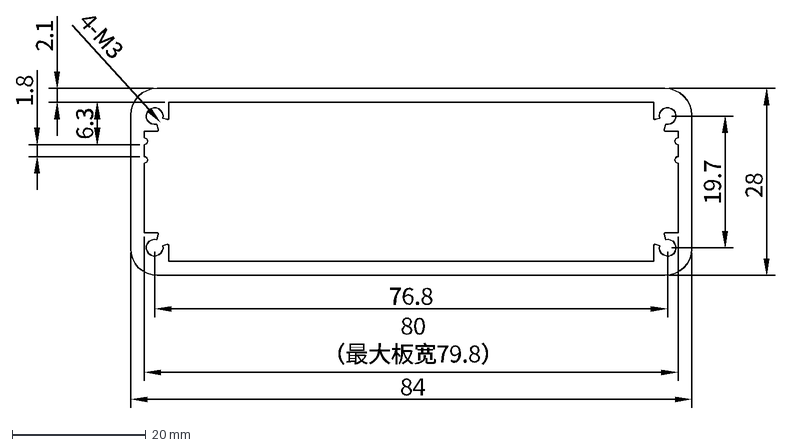
[picture p71: CAD file, 2026-07-02]
CAD-Drawings/SC-ZT84x28-K67.dxf
76.8
19.7
4-M3
80 （最大板宽79.8）
84
28
2.1
1.8
6.3
