Kamikawa-Enclosure/Kamikawa-Enclosure-Open-Models/3D-Models/SC-FT205.6X65-K489.STEP

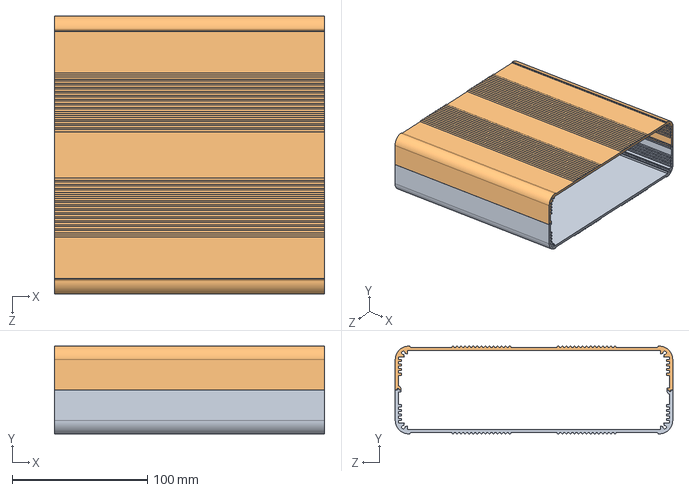
[picture p72: CAD file, 2026-07-14]
3D-Models/SC-FT205.6X65-K489.STEP
200.0 x 65.0 x 205.6 mm
