Kamikawa-Enclosure/Kamikawa-Enclosure-Open-Models/3D-Models/SC-FT250X54-K502.STEP

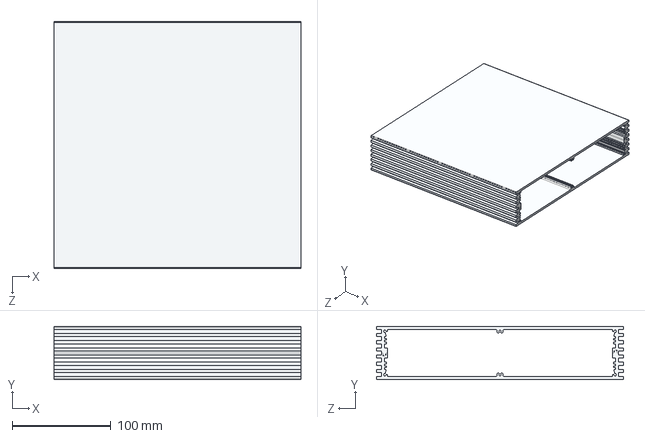
[picture p73: CAD file, 2026-07-14]
3D-Models/SC-FT250X54-K502.STEP
250.0 x 54.0 x 250.0 mm
