Kamikawa-Enclosure/Kamikawa-Enclosure-Open-Models/3D-Models/SC-FT185.6X65-K479.STEP

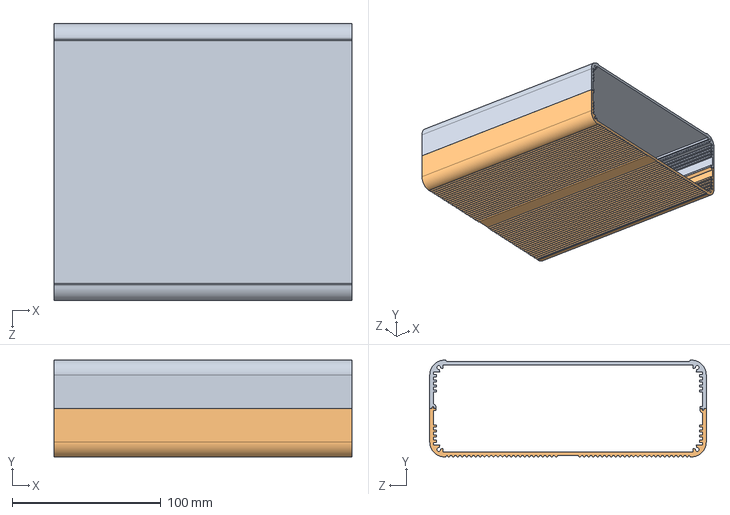
[picture p74: CAD file, 2026-07-14]
3D-Models/SC-FT185.6X65-K479.STEP
200.0 x 65.0 x 185.6 mm
