Kamikawa-Enclosure/Kamikawa-Enclosure-Open-Models/3D-Models/SC-ZT194x32.5-K450.STEP

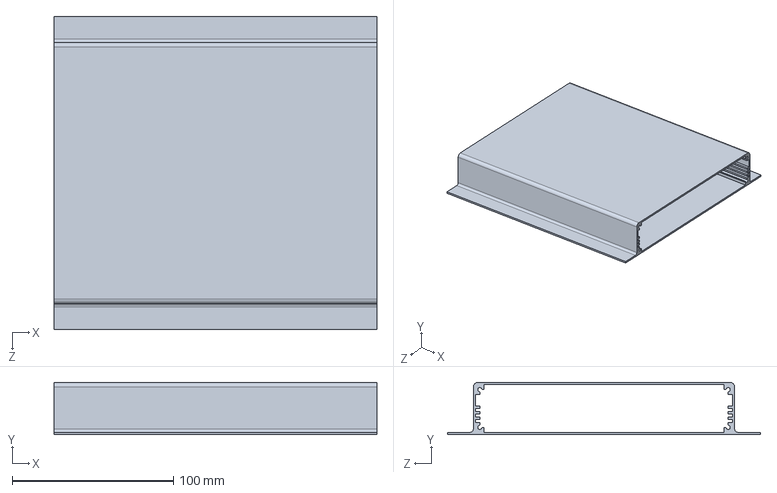
[picture p75: CAD file, 2026-07-14]
3D-Models/SC-ZT194x32.5-K450.STEP
200.0 x 32.5 x 194.0 mm
