Kamikawa-Enclosure/Kamikawa-Enclosure-Open-Models/3D-Models/SC-FT114.6X38-K414.STEP

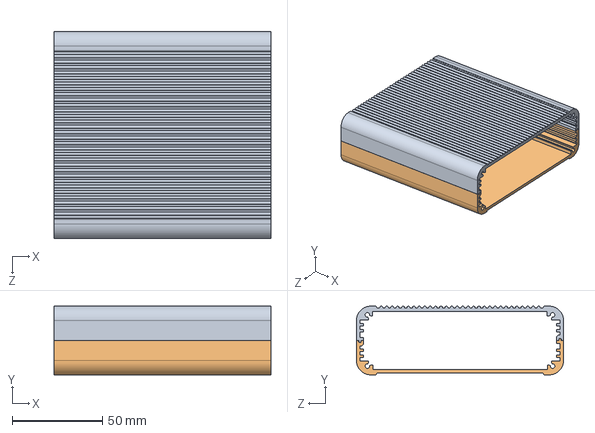
[picture p76: CAD file, 2026-07-14]
3D-Models/SC-FT114.6X38-K414.STEP
120.0 x 38.0 x 114.6 mm
