Kamikawa-Enclosure/Kamikawa-Enclosure-Open-Models/3D-Models/SC-ZT67.5x24-K407.STEP

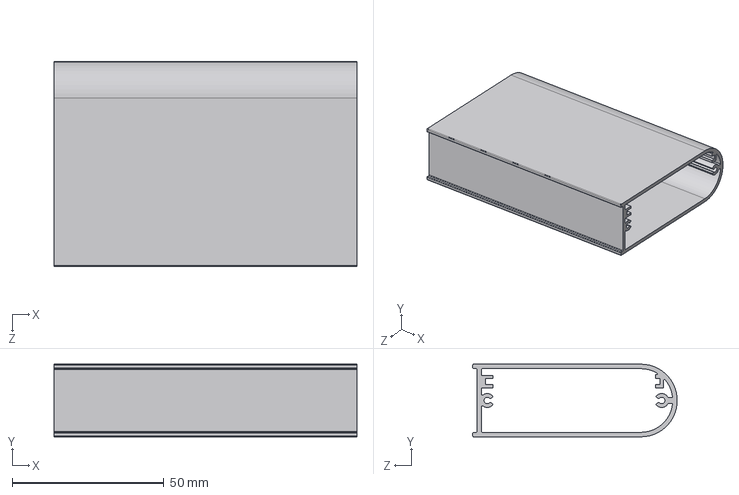
[picture p78: CAD file, 2026-07-14]
3D-Models/SC-ZT67.5x24-K407.STEP
100.0 x 24.0 x 67.5 mm
