Kamikawa-Enclosure/Kamikawa-Enclosure-Open-Models/3D-Models/SC-FT114.6X38-K409.STEP

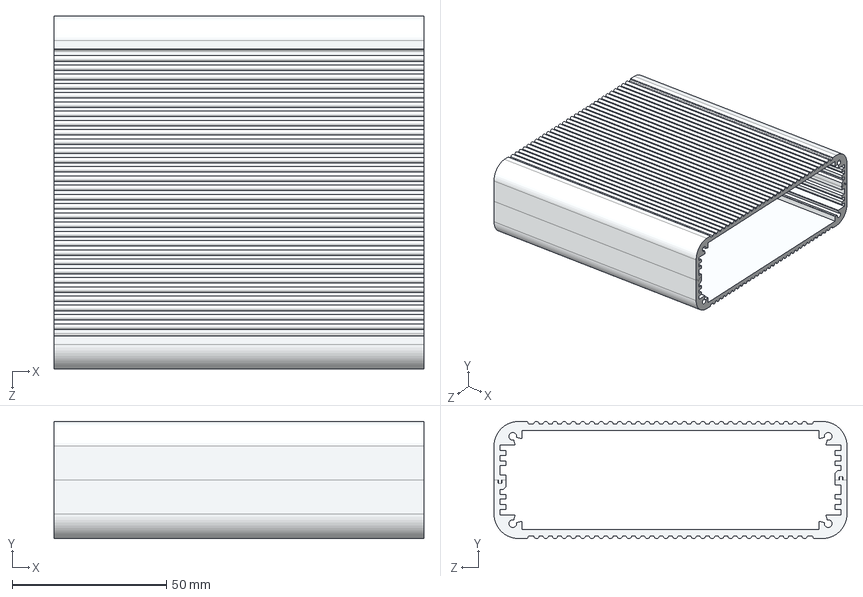
[picture p79: CAD file, 2026-07-14]
3D-Models/SC-FT114.6X38-K409.STEP
120.0 x 38.0 x 114.6 mm
