Kamikawa-Enclosure/Kamikawa-Enclosure-Open-Models/3D-Models/SC-FT99.6X35-K387.STEP

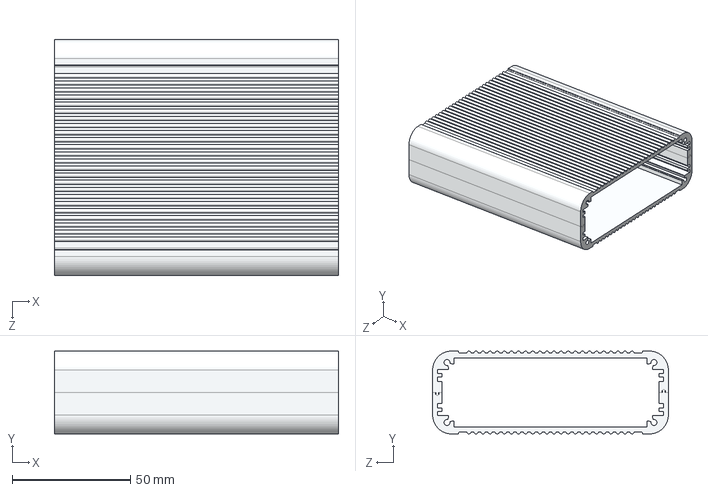
[picture p80: CAD file, 2026-07-14]
3D-Models/SC-FT99.6X35-K387.STEP
120.0 x 35.0 x 99.6 mm
