Kamikawa-Enclosure/Kamikawa-Enclosure-Open-Models/CAD-Drawings/SC-ZT95.4x45.2-K83.dxf

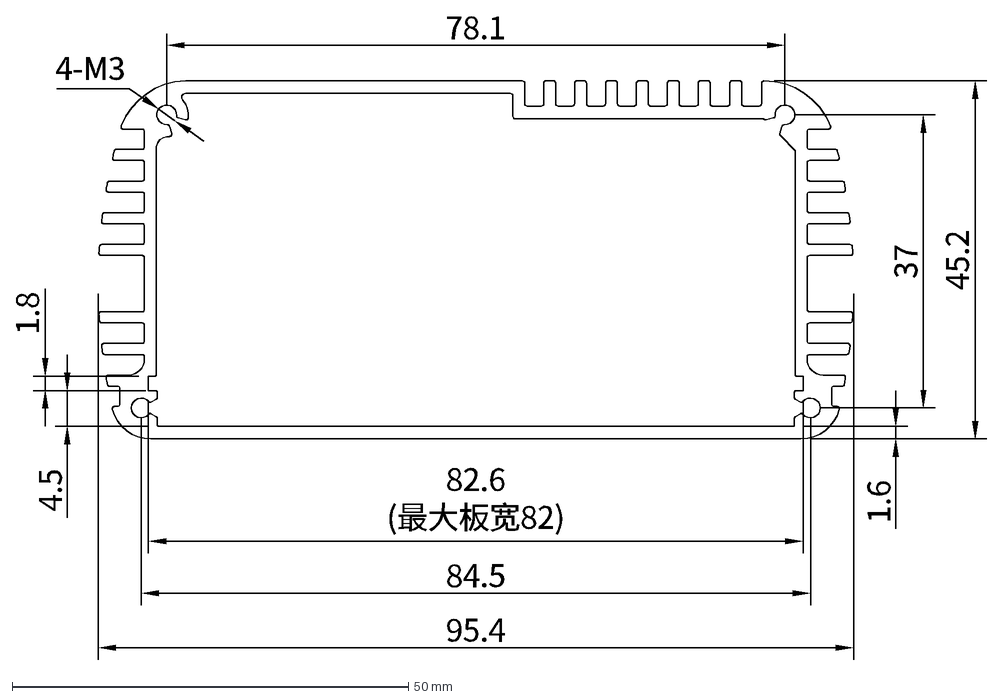
[picture p81: CAD file, 2026-07-02]
CAD-Drawings/SC-ZT95.4x45.2-K83.dxf
1.6
84.5
82.6 (最大板宽82)
95.4
37
45.2
1.8
4.5
78.1
4-M3
