Kamikawa-Enclosure/Kamikawa-Enclosure-Open-Models/3D-Models/SC-FT179.8X50-K392.STEP

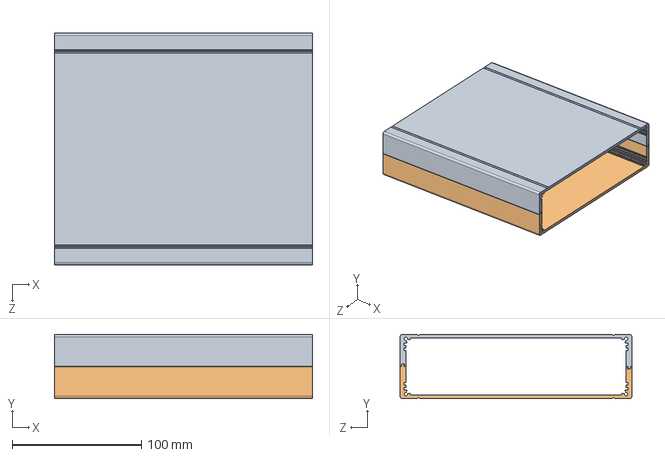
[picture p82: CAD file, 2026-07-14]
3D-Models/SC-FT179.8X50-K392.STEP
200.0 x 50.0 x 179.8 mm
