Kamikawa-Enclosure/Kamikawa-Enclosure-Open-Models/3D-Models/SC-FT109.6X35-K404.STEP

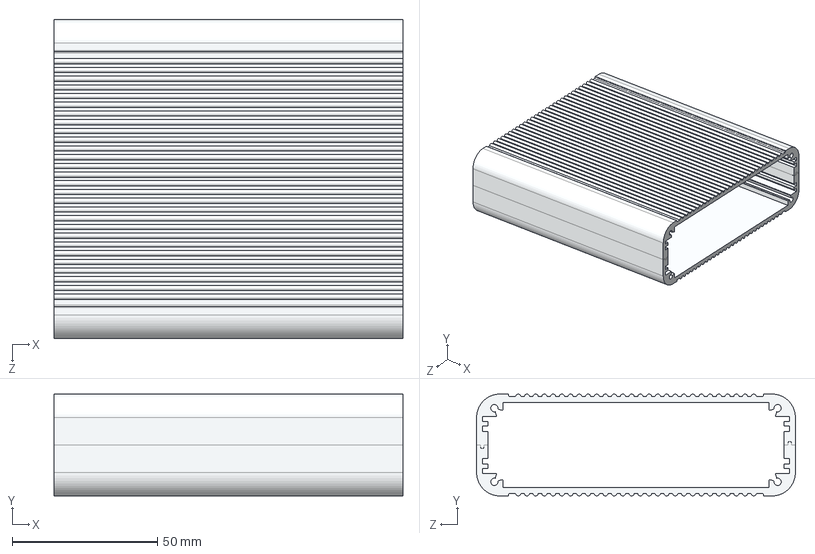
[picture p83: CAD file, 2026-07-14]
3D-Models/SC-FT109.6X35-K404.STEP
120.0 x 35.0 x 109.6 mm
