Kamikawa-Enclosure/Kamikawa-Enclosure-Open-Models/3D-Models/SC-FT99.6X35-K393.STEP

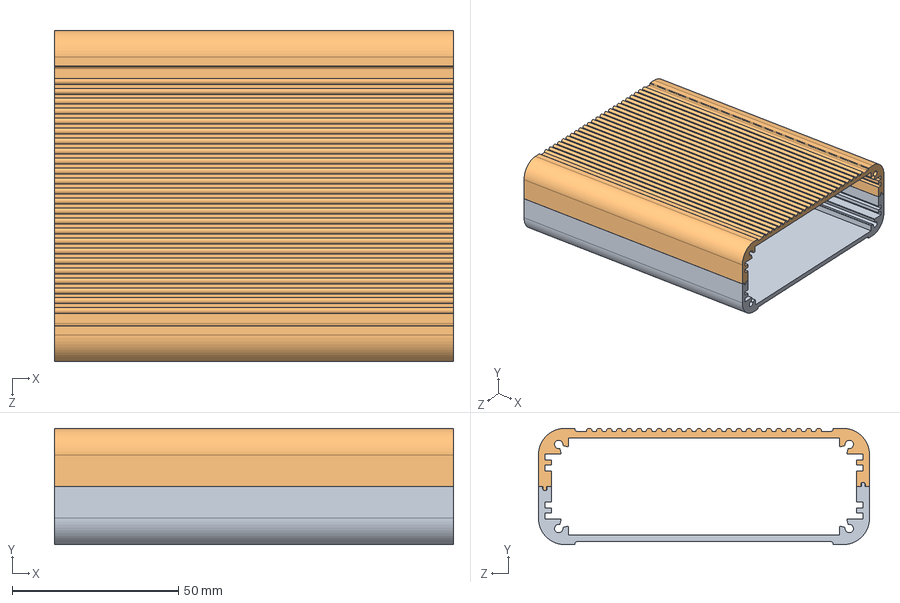
[picture p84: CAD file, 2026-07-14]
3D-Models/SC-FT99.6X35-K393.STEP
120.0 x 35.0 x 99.6 mm
