Kamikawa-Enclosure/Kamikawa-Enclosure-Open-Models/3D-Models/SC-FT109.6X35-K406.STEP

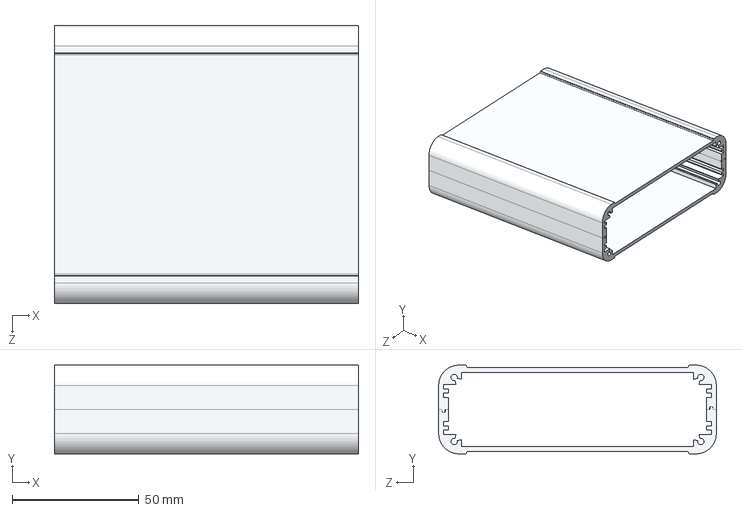
[picture p86: CAD file, 2026-07-14]
3D-Models/SC-FT109.6X35-K406.STEP
120.0 x 35.0 x 109.6 mm
