Kamikawa-Enclosure/Kamikawa-Enclosure-Open-Models/CAD-Drawings/SC-ZT104.5x21.8-K99.dxf

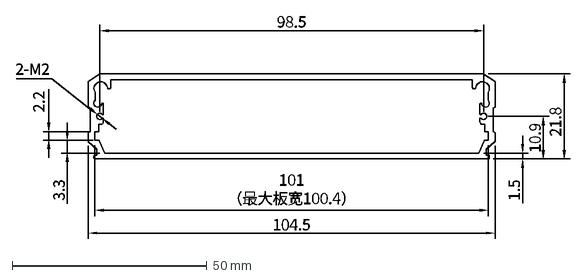
[picture p87: CAD file, 2026-07-02]
CAD-Drawings/SC-ZT104.5x21.8-K99.dxf
101 （最大板宽100.4）
3.3
1.5
104.5
21.8
98.5
10.9
2-M2
2.2
