Kamikawa-Enclosure/Kamikawa-Enclosure-Open-Models/3D-Models/SC-FT202X32-K384.STEP

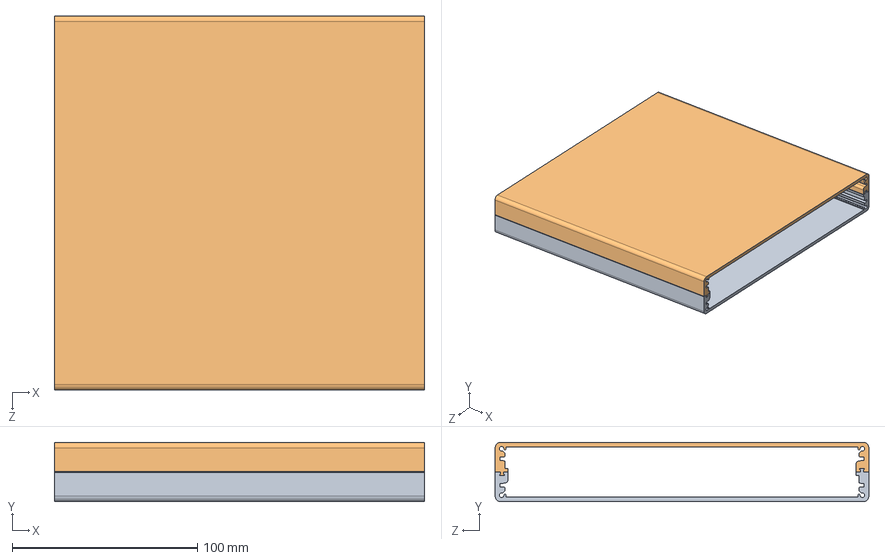
[picture p88: CAD file, 2026-07-14]
3D-Models/SC-FT202X32-K384.STEP
200.0 x 32.0 x 202.0 mm
