Kamikawa-Enclosure/Kamikawa-Enclosure-Open-Models/3D-Models/SC-ZT107x27-K395.STEP

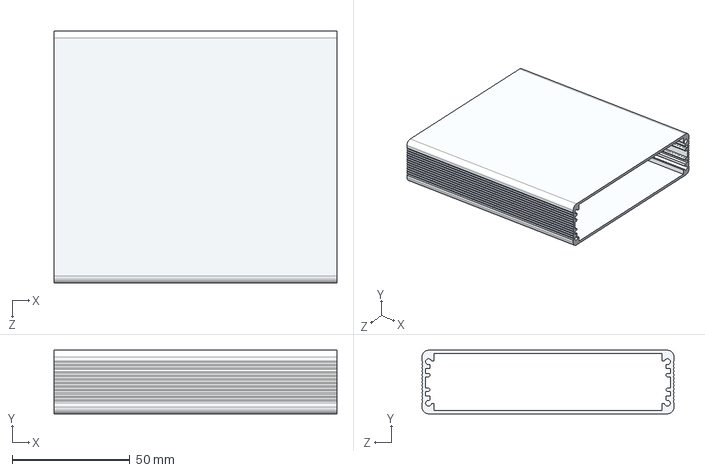
[picture p89: CAD file, 2026-07-14]
3D-Models/SC-ZT107x27-K395.STEP
120.0 x 27.0 x 107.0 mm
