Kamikawa-Enclosure/Kamikawa-Enclosure-Open-Models/CAD-Drawings/SC-ZT97x84-K89.dxf

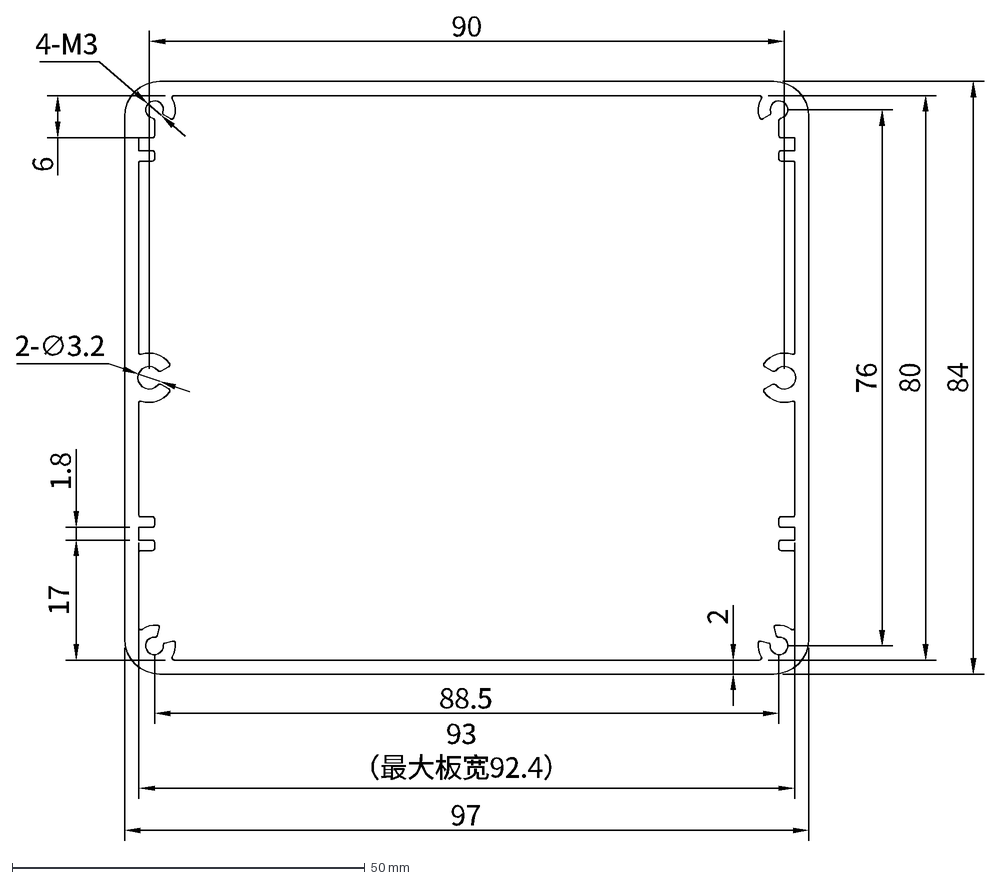
[picture p90: CAD file, 2026-07-02]
CAD-Drawings/SC-ZT97x84-K89.dxf
97
84
90
2
76
88.5
6
80
1.8
2-∅3.2
4-M3
17
93 （最大板宽92.4）
