Kamikawa-Enclosure/Kamikawa-Enclosure-Open-Models/3D-Models/SC-ZT85X46-K385.STEP

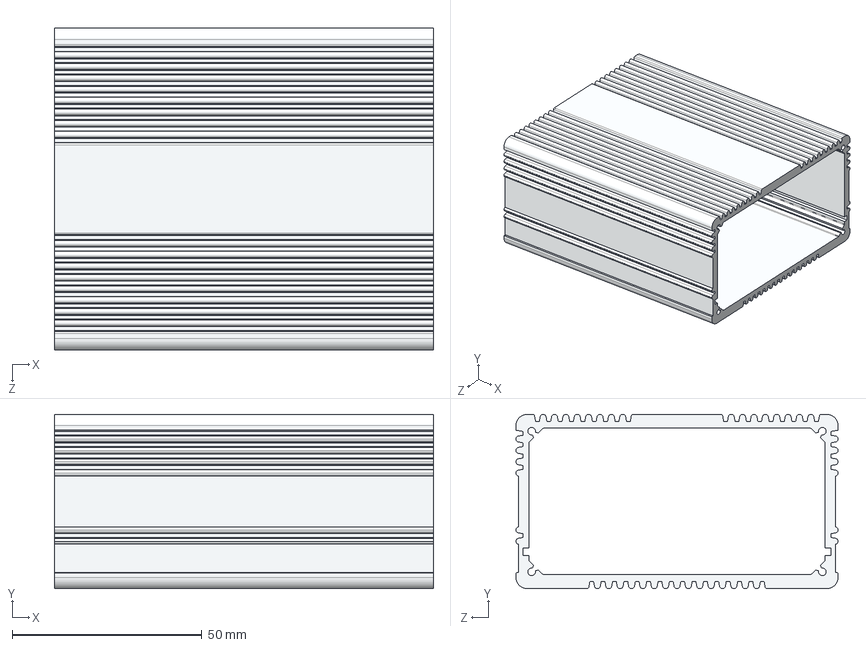
[picture p91: CAD file, 2026-07-14]
3D-Models/SC-ZT85X46-K385.STEP
100.0 x 46.0 x 85.0 mm
