Kamikawa-Enclosure/Kamikawa-Enclosure-Open-Models/CAD-Drawings/SC-ZT97x40.6-K161.dxf

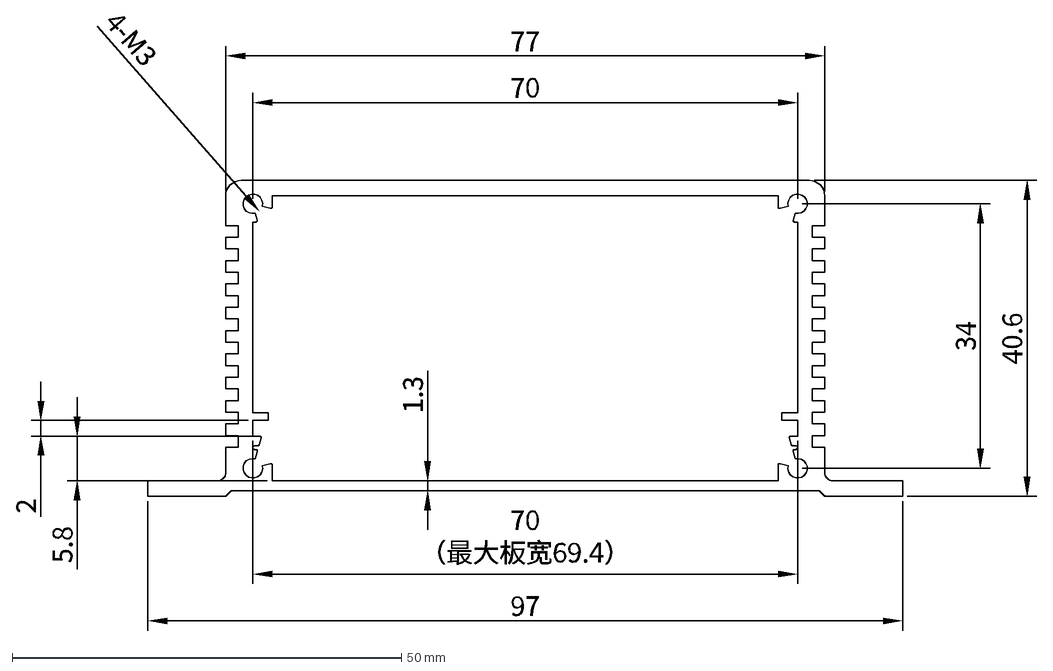
[picture p92: CAD file, 2026-07-02]
CAD-Drawings/SC-ZT97x40.6-K161.dxf
4-M3
34
97
40.6
77
70 （最大板宽69.4）
70
1.3
5.8
2
