Kamikawa-Enclosure/Kamikawa-Enclosure-Open-Models/3D-Models/SC-FT94.6X30-K381.STEP

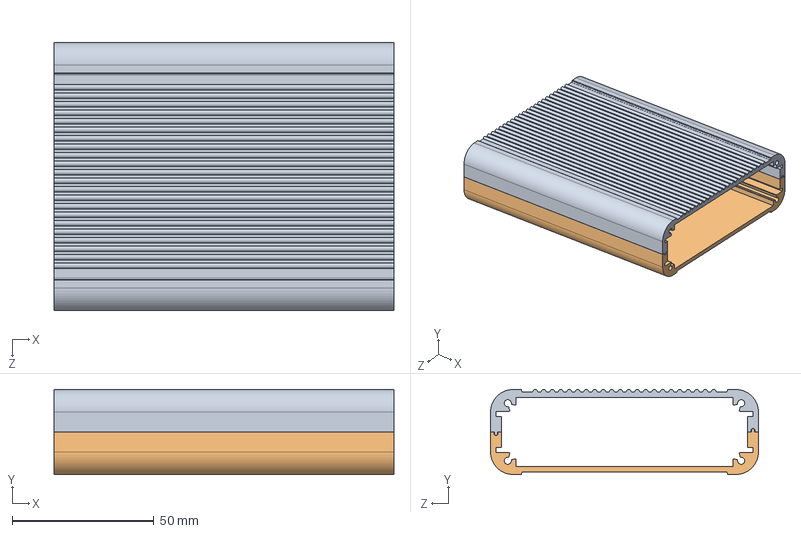
[picture p93: CAD file, 2026-07-14]
3D-Models/SC-FT94.6X30-K381.STEP
120.0 x 30.0 x 94.6 mm
