Kamikawa-Enclosure/Kamikawa-Enclosure-Open-Models/3D-Models/SC-ZT128.4x34.3-K401.STEP

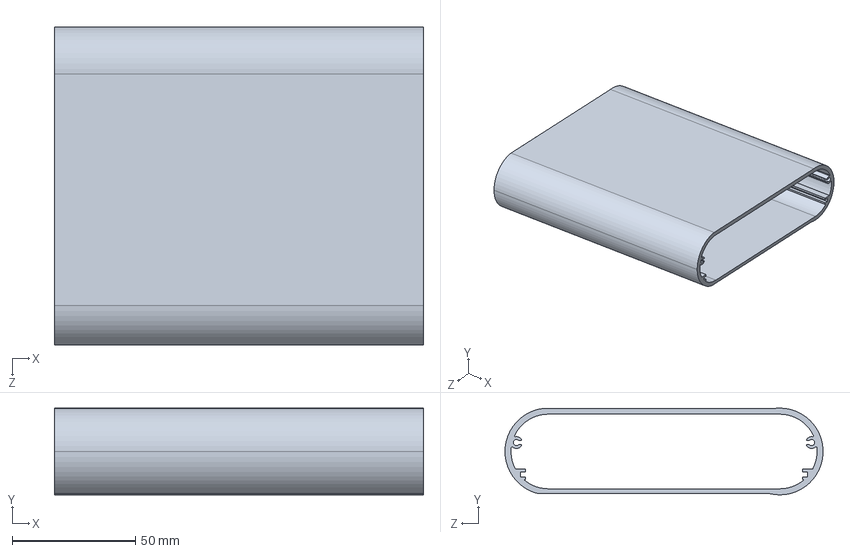
[picture p94: CAD file, 2026-07-14]
3D-Models/SC-ZT128.4x34.3-K401.STEP
150.0 x 35.3 x 129.3 mm
