Kamikawa-Enclosure/Kamikawa-Enclosure-Open-Models/(list of files, cad)

Other CAD files:
CAD-Drawings/SC-FT140X90-K219.dxf
CAD-Drawings/SC-FT140X70-K218.dxf
CAD-Drawings/SC-FT104X76.95-K337.dxf
CAD-Drawings/SC-ZT110X58-K175.dxf
CAD-Drawings/SC-ZT120X32-K390.dxf
CAD-Drawings/SC-FT134X35.6-K129.dxf
CAD-Drawings/SC-FT140X50-K217.dxf
CAD-Drawings/SC-ZT122x87-K278.dxf
CAD-Drawings/SC-ZT111.5x58-K290.dxf
CAD-Drawings/SC-ZT129x29-K433.dxf
CAD-Drawings/SC-ZT128.5x41-K429.dxf
CAD-Drawings/SC-ZT107x27-K395.dxf
CAD-Drawings/SC-ZT129.6x31.5-K285.dxf
CAD-Drawings/SC-ZT115.6x276-K431.dxf
CAD-Drawings/SC-ZT110x28-K427.dxf
CAD-Drawings/SC-ZT128x73.4-K400.dxf
3D-Models/SC-FT130X55-K443.STEP
3D-Models/SC-FT134.6X45-K441.STEP
CAD-Drawings/SC-ZT112x25-K423.dxf
CAD-Drawings/SC-ZT113.7x65-K185.dxf
CAD-Drawings/SC-ZT126x40-K275.dxf
CAD-Drawings/SC-ZT131x27.5-K438.dxf
CAD-Drawings/SC-ZT107x36.6-K296.dxf
CAD-Drawings/SC-ZT137.77x34.1-K494.dxf
CAD-Drawings/SC-ZT130.5x50-K417.dxf
CAD-Drawings/SC-ZT133.6x97.5-K462.dxf
3D-Models/SC-FT155.6X90-K460.STEP
CAD-Drawings/SC-ZT117x53-K403.dxf
CAD-Drawings/SC-ZT133x46.8-K288.dxf
CAD-Drawings/SC-ZT110x24-K425.dxf
CAD-Drawings/SC-ZT116x24-K330.dxf
CAD-Drawings/SC-ZT110x46.9-K492.dxf
3D-Models/SC-FT165.6X90-K484.STEP
CAD-Drawings/SC-ZT128.4x34.3-K401.dxf
3D-Models/SC-FT130X55-K452.STEP
CAD-Drawings/SC-ZT120x45-K350.dxf
CAD-Drawings/SC-ZT100x54.5-K323.dxf
CAD-Drawings/SC-ZT94.6x35-K289.dxf
3D-Models/SC-FT145.6X65-K459.STEP
CAD-Drawings/SC-ZT92x39.1-K482.dxf
CAD-Drawings/SC-ZT84x17.5-K241.dxf
3D-Models/SC-ZT58.6x24.1-K493.STEP
CAD-Drawings/SC-ZT91x91-K477.dxf
CAD-Drawings/SC-ZT92x30-K374.dxf
CAD-Drawings/SC-ZT105.5x52.9-K367.dxf
CAD-Drawings/SC-ZT100x50-K184.dxf
CAD-Drawings/SC-ZT89.5x29.5-K449.dxf
CAD-Drawings/SC-ZT91x49.6-K485.dxf
CAD-Drawings/SC-ZT100x27-K424.dxf
CAD-Drawings/SC-ZT85.8x26.5-K426.dxf
CAD-Drawings/SC-ZT101.5x24-K436.dxf
CAD-Drawings/SC-ZT101.2x23.5-K329.dxf
CAD-Drawings/SC-ZT95x30-K399.dxf
CAD-Drawings/SC-ZT84x17.5-K348.dxf
CAD-Drawings/SC-ZT106x36.3-K434.dxf
CAD-Drawings/SC-ZT92x46-K499.dxf
3D-Models/SC-FT100x25.5-K91.STEP
3D-Models/SC-FT100x25.5-K91.STL
3D-Models/SC-FT104.4x28.3-K92.STEP
3D-Models/SC-FT104.4x28.3-K92.STL
3D-Models/SC-FT104.5x21.8-K99.STEP
3D-Models/SC-FT104.5x21.8-K99.STL
3D-Models/SC-FT104.6X35-K319.STEP
3D-Models/SC-FT104.6X35-K319.STL
3D-Models/SC-FT104X107-K335.STEP
3D-Models/SC-FT104X107-K335.STL
3D-Models/SC-FT104X55.6-K95.STEP
3D-Models/SC-FT104X55.6-K95.STL
3D-Models/SC-FT104X76.95-K337.STL
3D-Models/SC-FT104x35.6-K93.STEP
3D-Models/SC-FT104x35.6-K93.STL
3D-Models/SC-FT104x46.9-K328.STEP
3D-Models/SC-FT104x46.9-K328.STL
3D-Models/SC-FT104x62.6-K96.STEP
3D-Models/SC-FT104x62.6-K96.STL
3D-Models/SC-FT104x63-K336.STEP
3D-Models/SC-FT104x63-K336.STL
3D-Models/SC-FT104x72.6-K97.STEP
3D-Models/SC-FT104x72.6-K97.STL
3D-Models/SC-FT105x30-K194.STEP
3D-Models/SC-FT105x30-K194.STL
3D-Models/SC-FT105x30-K213.STEP
3D-Models/SC-FT105x30-K213.STL
3D-Models/SC-FT105x45-K162.STEP
3D-Models/SC-FT105x45-K162.STL
3D-Models/SC-FT105x45-K195.STEP
3D-Models/SC-FT105x45-K195.STL
3D-Models/SC-FT105x60-K196.STEP
3D-Models/SC-FT105x60-K196.STL
3D-Models/SC-FT106X54-K101.STL
3D-Models/SC-FT106X55-K263.STEP
3D-Models/SC-FT106X55-K263.STL
3D-Models/SC-FT106x40-K100.STEP
3D-Models/SC-FT106x40-K100.STL
3D-Models/SC-FT106x55-K102.STEP
3D-Models/SC-FT106x55-K102.STL
3D-Models/SC-FT107.6X55-K148.STEP
3D-Models/SC-FT107.6X55-K148.STL
3D-Models/SC-FT107X47-K103.STEP
3D-Models/SC-FT107X47-K103.STL
3D-Models/SC-FT108.2x29.5-K254.STEP
3D-Models/SC-FT108.2x29.5-K254.STL
3D-Models/SC-FT108x25.7-K104.STEP
3D-Models/SC-FT108x25.7-K104.STL
3D-Models/SC-FT109.5x29.5-K247.STEP
3D-Models/SC-FT109.5x29.5-K247.STL
3D-Models/SC-FT109.6X35-K321.STEP
3D-Models/SC-FT109.6X35-K321.STL
3D-Models/SC-FT109.6X35-K402.STEP
3D-Models/SC-FT109.6X35-K402.STL
3D-Models/SC-FT109.6X35-K404.STL
3D-Models/SC-FT109.6X35-K406.STL
3D-Models/SC-FT110x50-K106.STEP
3D-Models/SC-FT110x50-K106.STL
3D-Models/SC-FT111.2x21.4-K229.STEP
3D-Models/SC-FT111.2x21.4-K229.STL
3D-Models/SC-FT111.2x32.5-K230.STEP
3D-Models/SC-FT111.2x32.5-K230.STL
3D-Models/SC-FT111.2x43.6-K231.STEP
3D-Models/SC-FT111.2x43.6-K231.STL
3D-Models/SC-FT111.2x54.7-K231.STEP
3D-Models/SC-FT111.2x54.7-K231.STL
3D-Models/SC-FT111.2x65.8-K233.STEP
3D-Models/SC-FT111.2x65.8-K233.STL
3D-Models/SC-FT111.2x88-K234.STEP
3D-Models/SC-FT111.2x88-K234.STL
3D-Models/SC-FT113x39.8-K108.STEP
3D-Models/SC-FT113x39.8-K108.STL
3D-Models/SC-FT113x49.8-K109.STEP
3D-Models/SC-FT113x49.8-K109.STL
3D-Models/SC-FT114.6X38-K409.STL
3D-Models/SC-FT114x33-K110.STEP
3D-Models/SC-FT114x33-K110.STL
3D-Models/SC-FT115x60-K316.STEP
3D-Models/SC-FT115x60-K316.STL
3D-Models/SC-FT120X49-K117.STEP
3D-Models/SC-FT120X49-K117.STL
3D-Models/SC-FT120x103-K113.STEP
3D-Models/SC-FT120x103-K113.STL
3D-Models/SC-FT120x35-K114.STEP
3D-Models/SC-FT120x35-K114.STL
3D-Models/SC-FT120x40-K116.STL
3D-Models/SC-FT120x63-K119.STEP
3D-Models/SC-FT120x63-K119.STL
3D-Models/SC-FT120x65-K120.STEP
3D-Models/SC-FT120x65-K120.STL
3D-Models/SC-FT120x69-K121.STEP
3D-Models/SC-FT120x69-K121.STL
3D-Models/SC-FT120x83-K122.STEP
3D-Models/SC-FT120x83-K122.STL
3D-Models/SC-FT122.4x28-K267.STEP
3D-Models/SC-FT122.4x28-K267.STL
3D-Models/SC-FT122x44.8-K235.STEP
3D-Models/SC-FT122x44.8-K235.STL
3D-Models/SC-FT124.6X35-K343.STEP
3D-Models/SC-FT124.6X35-K343.STL
3D-Models/SC-FT124.6X45-K437.STL
3D-Models/SC-FT125x51-K125.STEP
3D-Models/SC-FT125x51-K125.STL
3D-Models/SC-FT127x75-K126.STEP
3D-Models/SC-FT127x75-K126.STL
3D-Models/SC-FT129.5x34.5-K250.STEP
3D-Models/SC-FT129.5x34.5-K250.STL
3D-Models/SC-FT130X55-K128.STEP
3D-Models/SC-FT130X55-K128.STL
3D-Models/SC-FT130X55-K443.STL
3D-Models/SC-FT130X55-K451.STL
3D-Models/SC-FT130X55-K452.STL
3D-Models/SC-FT134.6X45-K439.STL
3D-Models/SC-FT134.6X45-K440.STL
3D-Models/SC-FT134.6X45-K441.STL
3D-Models/SC-FT134X35.6-K129.STL
3D-Models/SC-FT136X64-K304.STEP
3D-Models/SC-FT136X64-K304.STL
3D-Models/SC-FT140X50-K217.STL
3D-Models/SC-FT140X70-K218.STL
3D-Models/SC-FT140X90-K219.STL
3D-Models/SC-FT140x35-K197.STEP
3D-Models/SC-FT140x35-K197.STL
3D-Models/SC-FT140x35-K216.STEP
3D-Models/SC-FT140x35-K216.STL
3D-Models/SC-FT140x50-K163.STEP
3D-Models/SC-FT140x50-K163.STL
3D-Models/SC-FT140x50-K198.STEP
3D-Models/SC-FT140x50-K198.STL
3D-Models/SC-FT140x70-K199.STEP
3D-Models/SC-FT140x70-K199.STL
3D-Models/SC-FT140x90-K200.STEP
3D-Models/SC-FT140x90-K200.STL
3D-Models/SC-FT142x53.4-K236.STEP
3D-Models/SC-FT142x53.4-K236.STL
3D-Models/SC-FT145.6X40-K357.STEP
3D-Models/SC-FT145.6X40-K357.STL
3D-Models/SC-FT145.6X65-K455.STL
3D-Models/SC-FT145.6X65-K458.STL
3D-Models/SC-FT145.6X65-K459.STL
3D-Models/SC-FT145X54-K134.STEP
3D-Models/SC-FT145X54-K134.STL
3D-Models/SC-FT145X68-K135.STEP
3D-Models/SC-FT145X68-K135.STL
3D-Models/SC-FT145X82-K136.STEP
3D-Models/SC-FT145X82-K136.STL
3D-Models/SC-FT147X41.3-K137.STEP
3D-Models/SC-FT147X41.3-K137.STL
3D-Models/SC-FT147X54.5-K138.STEP
3D-Models/SC-FT147X54.5-K138.STL
3D-Models/SC-FT147X60.6-K139.STEP
3D-Models/SC-FT147X60.6-K139.STL
3D-Models/SC-FT147x35.7-K283.STEP
3D-Models/SC-FT147x35.7-K283.STL
3D-Models/SC-FT147x41.3-K282.STEP
3D-Models/SC-FT147x41.3-K282.STL
3D-Models/SC-FT149x50.5-K265.STEP
3D-Models/SC-FT149x50.5-K265.STL
3D-Models/SC-FT150.2x38.8-K140.STEP
3D-Models/SC-FT150.2x38.8-K140.STL
3D-Models/SC-FT150.2x72-K142.STEP
3D-Models/SC-FT150.2x72-K142.STL
3D-Models/SC-FT150X90-K173.STEP
3D-Models/SC-FT150X90-K173.STL
3D-Models/SC-FT150x55-K164.STEP
3D-Models/SC-FT150x55-K164.STL
3D-Models/SC-FT152x44-K143.STEP
3D-Models/SC-FT152x44-K143.STL
3D-Models/SC-FT155.6X50-K358.STEP
3D-Models/SC-FT155.6X50-K358.STL
3D-Models/SC-FT155.6X90-K460.STL
3D-Models/SC-FT155.6X90-K461.STL
3D-Models/SC-FT155.6X90-K465.STL
3D-Models/SC-FT159x40-K364.STEP
3D-Models/SC-FT159x40-K364.STL
3D-Models/SC-FT160x55-K166.STEP
3D-Models/SC-FT160x55-K166.STL
3D-Models/SC-FT160x75.4-K262.STEP
3D-Models/SC-FT160x75.4-K262.STL
3D-Models/SC-FT160x80-K146.STEP
3D-Models/SC-FT160x80-K146.STL
3D-Models/SC-FT165.6X90-K475.STL
3D-Models/SC-FT165.6X90-K483.STL
3D-Models/SC-FT165.6X90-K484.STL
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
