Kamikawa-Enclosure/Kamikawa-Enclosure-Open-Models/(commit log)

2026-07-01 SC-US1000-00 STEP & STL 3D enclosure models
    Upload 3D solid files for model SC-US1000-00 aluminum extrusion enclosure:
    1. STEP file: Universal format compatible with SolidWorks, Fusion360, Creo, AutoCAD
    2. STL file: For 3D printing and rapid prototype preview
    All dimensions match real production samples, supports custom CNC cutting, hole punching and surface anodizing.
    [SC-US1000-00.STL]
2026-07-01 SC-US1000-00 DWG 2D CAD drawing
    Upload 2D DWG engineering drawing for SC-US1000-00 aluminum extrusion enclosure.
    This drawing contains complete dimensional data: outer size, inner cavity, wall thickness, mounting hole positions and reserved cutout layout.
    Compatible with AutoCAD, SolidWorks, Fusion 360 and other mechanical design software, available for structural layout and production reference.
    Custom CNC punching, anodizing and length modification are supported for this model.
    [SC-US1000-00.DWG]
2026-07-01 SC-AU1000-00 STEP & STL 3D enclosure models
    Upload complete 3D solid files for SC-AU1000-00 aluminum extrusion enclosure:
    1. STEP file: Universal neutral format, compatible with SolidWorks, Fusion 360, Creo, AutoCAD and all mainstream mechanical design software.
    2. STL file: Used for rapid prototyping, visual preview and 3D printing.
    All geometric dimensions are consistent with actual production housings. We support custom CNC cutouts, drilling, length trimming and various anodizing surface treatments for this model.
    [SC-AU1000-00.STEP]
2026-07-01 SC-AU1000-00 DWG 2D CAD drawing
    Upload 2D DWG engineering drawing for SC-AU1000-00 aluminum extrusion enclosure.
    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
    [SC-AU1000-00.DWG]
2026-07-20 Create Product Case Studies 3D
